mp003-debug/eye-starlink/docs/optics.md

# 新镜头到货：2026-10-23

用户10月23日确认新镜头已装好、板卡开机，纸和尺子已准备好；标称850nm补光灯10月24日已到货，铭牌/原厂接头核对及纸张开关灯响应已完成，详见procurement.md和status.md。24行/1倍增益开灯原图无饱和、大字可辨，细节仍偏软，画面位置有偏移；红外精细对焦、光谱、安全和PCCR未验证。10月23日完成的是换镜头及普通室内标靶检查。旧章节中的“保持原装镜头”等是历史操作，当前用完整新镜头替换，不拆传感器玻璃或撬IR-cut。

先在35–40cm固定纸张/尺子建立清晰基线，再固定焦点分别查看30、35、40、45cm。每档保存原始640×480画面并记录尺子可见宽度、清晰度、是否重新调焦。当前预览工具含缩小全图和中心放大窗；放大不增加原始细节。可见光焦点先用于安装验证，850nm补光到货后还需复核焦点和曝光。

镜头到货不等于安装净空、近红外像质或眼控通过；今天的标靶与可见光几何检查不作为PCCR验收。

已完成可见光粗调：手持纸约35–40cm可拍清楚；随后固定纸和竖尺于约40cm，原始640×480图能分辨毫米刻线。尺子1–5cm跨度约209像素，粗估视野123×92mm；非精密标定。随后保持当前焦点完成35/45cm固定标靶抽查，40/45cm刻线和笔画更清楚，35cm略软。目标位置/自动曝光不同，此处仅作目视比较，不等于精密景深或PCCR距离验收；30cm未测。数据见data/private/bringup/lens_40cm/assessment.json。

# 当前距离要求补充（2026-10-20）

用户要求实际使用有前后距离余量。此前32–35cm只作历史台架位置；当前先以35–40cm建立基线，将30–45cm作为待验证使用范围。镜头需要覆盖至少30–45cm的调焦位置，优先留25–50cm调焦余量。但可调焦范围、固定焦点景深、同一次PCCR校准允许的头部前后移动量必须分别测量，不能互相替代。

仍先找一只12mm镜头：薄透镜近似下，6µm像素、4mm示例目标，在30/35/40/45cm分别约27.8/23.7/20.6/18.3像素；这些是原生采样估计，不是识别精度。12mm在640列裁剪下对应水平视野约92/108/124/140mm。实际镜头畸变、焦点、景深、头动和反光效果尚未验证。

到货后先用刻度尺/打印目标，固定一个焦点，在30、35、40、45cm测清晰度和采样，再决定光圈/光源和安装位置。安全条件确认后的真人测试分开记录：每个距离重新校准的结果，以及固定一次校准后前后移动的结果；失焦或特征不可靠时暂停选择，不能输出伪稳定坐标。暂不购买测距模块。

以下旧计算保留其当时的32–35cm条件，不是当前使用硬限制。

# 原装 ATK-MT9V034 的光学准备步骤

2026-10-20用户确认只有原装摄像头与转接板，未动过镜头或线路，未准备补光及驱动。随后提供4张实物照片和京东购买链接。照片确认PCB版本为V1.5，替代此前V1.4的口头记录；产品名称仍按ATK-MT9V034记录。最新客服转述提供了M12×0.5、2.8mm及镜筒内IR-cut的信息。用户提醒客服可能出错，以下将转述、估算和实测严格分开；镜头拆检及近红外测试仍未完成；最新板测状态见status.md。

## 1. 实物核对与现在的动作

原始照片保存在[hardware/photos](../hardware/photos)，逐文件来源和SHA256见[manifest.json](../hardware/photos/manifest.json)。照片没有旋转、裁剪或修改像素。

| 实物证据 | 当前可以确认 | 仍不能确定 |
| --- | --- | --- |
| [正面照片](../hardware/photos/camera_front.jpg) | PCB丝印ATK-MC9V034 V1.5；镜头朝前，2×9接口 | 不能仅凭丝印中的MC认定内部换了传感器型号；芯片标记被镜座遮挡 |
| [镜头侧面](../hardware/photos/lens_side.jpg) | 镜筒外螺纹、黑色镜座、侧面螺钉可见 | 螺钉看起来用于锁定镜头；照片本身不能确认螺纹/焦距/后焦。客服转述提供暂定参数，详见下文 |
| [转接板](../hardware/photos/adapter_top.jpg) | PMODA/PMODB、STB/EXP开关、RST标记、两个轴向电阻 | 开关档位对应的电平、内部走线、电阻阻值不能从这些照片确定 |
| [组件全貌](../hardware/photos/assembly.jpg)及用户说明 | 现有相机与转接板，无另备补光和驱动 | 照片中的镜面反光不能证明是否有IR-cut，不能定位可拆滤片 |

正面照片在“镜头面朝观察者、接口位于下方”视角中，丝印上排从左到右为GND、SCL、SDA、D0、D2、D4、D6、PCLK、STB；下排为3.3V、VSYNC、HREF、RST、D1、D3、D5、D7、EXP。这只是丝印抄录，不是Pmod针序，也没有证明模组内部走线；背面视角会左右翻转，不能直接照此另接杜邦线。

现有[参考原理图](../references/atk_mt9v034_v14_schematic.pdf)来自V1.4资料包，不能改名成V1.5资料。该参考中STB为STANDBY、EXP为EXPOSURE；传感器LED_OUT另有其脚，且不是LED电源。客服转述称V1.5的DVP、I2C、供电、排针接口无变化，因此继续保留现有采集接线与XDC基线；这不是实际通断或新版原理图核验。新增接线仍应核对实际连接。暂不按照片规定STB/EXP开关该向哪边拨。

现在保持原装镜头和接线。把相机固定在屏幕下沿可调支架上，以32–35cm观看距离为基准，先在普通稳定室内光照下查看原始图像，检查中心及四角注视时的完整眼区、清晰度和是否离框。这是采集及几何检查，不能代替PCCR验证。现有采集上板操作先确认板卡连接及唯一控制进程；静态/单帧DMA诊断已实现并完成本地故障测试，实际板测见board_bringup.md，不运行旧实验来替代。

京东短链接已解析为[商品10114211122946](https://item.m.jd.com/product/10114211122946.html)，详细参数页未成功读取。2026-10-20用户转述客服答复如下，不再重复要求用户询问同一组问题：

| 项目 | 客服转述 | 工程采用方式 |
| --- | --- | --- |
| 原镜头 | M12×0.5，2.8mm | 暂定选型和估算输入，未独立测量 |
| IR-cut | 存在，位于镜头镜筒内部 | 优先换完整兼容镜头，保留原镜头，不撬内部滤片 |
| 可替换镜头 | M12、1/3英寸、无IR-cut、850nm、2.8mm，可在32–35cm对焦 | 说明可能存在兼容替换件；没有具体型号，也不证明其瞳孔采样足够 |
| V1.5改版 | DVP/I2C/供电/排针接口不变，仅布线与电源滤波优化 | 延续现有接口基线；原理图/通断未独立核验，晶振频率本次未明确答复 |

config/hardware.json中的reported字段保存以上答复及不确定性。顶层尚未独立确认的镜头字段继续为空，verified标志保持false；不能因收到客服答复就将光学、安全或板测标为通过。

## 2. 镜头选择：先看瞳孔像素数

能在35cm对焦，只说明焦点能落到该距离。2.8mm广角镜头即使换成无IR-cut版本，在相同距离下仍给瞳孔留下相近的少量像素；数字放大和ROI裁剪不会增加原始采样细节。

以下为选型用的理想薄透镜估算，非实际眼图或精度：像元间距p=0.006mm，捕获区域640×480，传感器不做binning；u近似取320/350mm，实际镜头主平面位置、畸变、光圈、近红外像质和角膜折射均未建模。m=f/(u-f)，物方视场宽=640p/m，目标直径像素数=d*m/p。4mm是示例目标尺寸，不代表已测得用户的瞳孔直径。

| 焦距 | 32–35cm处水平视场，640列裁剪 | 假设4mm目标直径 | 选型判断 |
| --- | --- | --- | --- |
| 原配/同焦距2.8mm | 约43.5–47.6cm | 约5.4–5.9像素 | 先做采集、对焦及视场基线，不优先买同焦距红外替换件作为主方案 |
| 8mm | 约15.0–16.4cm | 约15.6–17.1像素 | 较大视场的对照候选 |
| 12mm | 约9.9–10.8cm | 约23.7–26.0像素 | 首个单眼特写试验的优先候选，需核对机械适配和对焦 |

小瞳孔会更困难：同模型35cm、3mm示例目标在2.8mm镜头下约4.0像素，在12mm下约17.8像素。任何像素数都不是准确眼控的充分条件。较长焦距缩小可见区域，必须同时实测完整眼区、头动和景深；表中视场不能直接当成允许的头动范围。后续如输出全幅752列，水平视场可增加17.5%，同一个目标所占的原生像素数不会增加；当前位流仍输出640列，未作此改动。

估算可复现：

```powershell
python D:/Eye_tracker_system/tools/estimate_optics.py
```

默认输出[build/optics/estimate.json](../build/optics/estimate.json)。脚本仅执行几何计算，不访问相机、不控制补光、不生成眼控有效标记。

### 当前镜头规格方向

2026-10-21更新：用户已下单MTV12MP5C（12mm/F2.8/M12×0.5），商家转述无IR-cut、支持850nm且适配原镜座，待到货实测。先用这一只建立35–40cm基线，再分别验收30–45cm的调焦、固定焦点清晰度和校准移动容差；不追加8mm对照镜头。镜尾净空与传感器盖玻璃仍须按实物检查，不强行旋到底。

“定焦”通常指焦距固定，不必然表示不能调焦。需要确认的是实际工作距离能否调清楚，以及是否有足够机械调节空间。去掉IR-cut会同时接收可见与近红外，不等于加了850nm带通片；带通片留待环境干扰实测后判断。

### 现在可做的原装成像检查

板端采集适配就绪后，在普通稳定室内光下，把带50mm刻度跨度的直尺放在计划眼部平面，分别测量镜头前方约32cm和35cm，尺面尽量与成像面平行、刻度跨度位于画面中央。固定相机和尺子，记录实际距离。原始帧按640×480、1:1保存，关闭预览缩放对测量的影响，记录是否存在binning/其他缩放。

在原始帧中测量50mm跨度的像素距离n，得到中心附近的n/50像素/mm，与估算作数量级比较。按暂定2.8mm模型，约应为67–74像素/50mm；偏差先排查真实镜头参数、距离、畸变、调焦和采集缩放。没有采集到画面前不填写实测值，也不拿UI截图或插值图替代。

确认具体替换镜头适配并拿到实物后，断电、固定好模组，再按镜头/镜座说明松开锁紧螺钉并更换镜筒；不拆镜座、不撬滤片、不触碰传感器盖玻璃，不强行旋到底。换镜头后先用普通目标对焦，850nm下最终焦点在非人体台架上复核；几何或光源位置变化后重新标定。

## 3. 补光与驱动准备清单

| 部件 | 需要核对的内容 | 当前状态 |
| --- | --- | --- |
| 透近红外镜头 | 接口/后焦/成像面/工作距离/850nm响应 | M12×0.5为客服暂定规格；优先12mm、对照8mm，待具体型号和机械/光学确认 |
| 850nm LED照明组件 | 精确型号、数量、光谱、角度、辐射参数、驱动和散热资料 | 12V/24灯/850nm配电源款已收到，纸张补光响应已验证；驱动、光学输出及近眼适用性未验证，见procurement.md |
| 配套限流驱动 | 匹配LED、硬件电流上限、默认关闭、手动关闭、必要的使能接口 | 未选型；不以软件PWM替代硬件限流 |
| 供电与支架 | 按驱动额定输入选电源；可调固定架和线缆应力保护 | 先核对现有配件 |

初期可以只设计一个独立照明单元和可调位置；以实际反光点身份验证决定是否需要增加光源，不直接堆叠多灯。光源数/位置改变都应触发重新标定。

电气关系是“合适电源 → 配套限流驱动 → LED”。未来由PL控制时，GPIO只接符合3.3V逻辑要求的驱动使能/同步输入，非隔离控制需要共地；具体引脚和供电等型号确定后绘制，不能先猜。摄像头LED_OUT是同步信号，不能直接作为补光供电。现有Pmod和转接板不接新增大电流负载。

## 4. 先台架，再眼部成像

先在不照射人的台架上检查驱动限流、实际电流、默认关闭、温升、相机响应、曝光与增益。人眼试验前，需要对实际灯板、镜头/光学件、最小可能观看距离、驱动状态、持续时间及可预见故障条件取得光生物安全评估依据。仅凭850nm、低电功率、看不见或LED元件资料都不能推定整机安全；商用眼控仪的认证也不能套用到自制灯板。没有测量条件时，优先使用适用条件明确的已评估照明组件，并由具备相应测量能力的实验室复核组合后的条件。

安全条件明确后，再采集重复中心、上下左右/四角、自然小幅头动、闭眼、遮挡和离框原始图。记录曝光、增益、瞳孔像素数、反光点位置/面积、饱和情况和几何配置。相机I2C及双上下文手动曝光/增益恢复已实现并上板；不把偶然清晰的一帧当作稳定结果。

验收目标是看清真实瞳孔边界和对应光源的角膜反射，且注视变化可重复区分。虹膜外圈、眼皮阴影、眼镜/环境高亮都不能直接当作目标特征。校准与检查采用不同采集序列。

## 原始依据

客服答复的来源为用户本次转述，包含“客服也有可能出错”的限定；没有将其伪装成厂商书面规格。以下公开来源用于传感器参数和一般光学原则。

- [onsemi MT9V034 数据手册](https://www.onsemi.com/download/data-sheet/pdf/mt9v034-d.pdf)：传感器尺寸、像素间距、曝光/增益及近红外支持；不证明当前镜头透过率。
- [Edmund Optics：焦距与视场](https://www.edmundoptics.com/knowledge-center/application-notes/imaging/understanding-focal-length-and-field-of-view/)：焦距/视场/工作距离关系及近轴估算的限制；不证明某个M12镜头与本模组兼容。
- [Tobii PCCR 工作原理](https://www.tobii.com/resource-center/learn-articles/how-do-eye-trackers-work)：瞳孔与角膜反光的相对位置。
- [ams OSRAM：Eye safety of IREDs used in lamp applications](https://look.ams-osram.com/m/563d74f4395107c7/original/Eye-safety-of-IREDs-used-in-lamp-applications.pdf)：红外LED风险评估及最终系统责任。
- [Tobii 光学安全说明](https://help.tobii.com/hc/en-us/articles/212372449-Safety-guidelines)：商用产品进行IEC/EN 62471实验室测试的说明，不是自制系统的证明。

2026-10-20预算和交期已确定，具体询价规格与候选筛选见[procurement.md](procurement.md)。已有音箱AUX可复用；不因预算充足就增加不必要外设。
