mp003-debug/eye-starlink/report/design.md

# 设计说明与协同开发总结

## 系统划分

本队伍确定应用场景、交互流程、板级接口、软硬件职责和验收路径。PL 处理相机
GRAY8 采集、DDR 帧通路、RGB565 显示、UART 和双缓冲音频；ARM 组织识别、停留
状态机、文字输入、多媒体和无线消息。输入失效、帮助抢占和退出均有显式状态转换。

无线协议区分照护需求、用户确认的正文/表情分享和可关闭的活动摘要。接收端的
“确认/处理”是本屏状态，不冒充上行护理确认。断线时不自动补发旧表达。

AI 采用两个独立层次：小型 MLP 的 INT8/INT32 推理及 NEON 内核用于边缘计算研究；
极小语言模型在 PYNQ 的 ARM CPU 本机运行。生成候选经过全文预览及再次确认才
进入正文，朗读与无线发送各自确认。系统不自动替用户表达意图。

## 智能体辅助设计与本队伍决策

本队伍利用智能体辅助分析 PS/PL 分工、RTL/驱动草案、构建日志、回归脚本和文档；
需求、接口选取、实现取舍、接线与真人操作反馈由本队伍确定。对生成内容进行编译、
仿真、参考对比和实机检查，发现不符时回到接口契约修正，保留失败与通过的区别。

| 任务 | 采用方式 | 工程判断及修正 |
|---|---|---|
| 异构接口设计 | 以 IP/寄存器/时钟/缓冲区契约约束生成内容 | 保留既有外设地址及独立位流，不以重载旧工程替代增量整合 |
| 定位与交互 | 生成状态机检查和预览辅助 | 同步匹配曾阻塞 BTN0 轮询，改为后台计算与缓存绘制 |
| 无线分享 | 建立 Python→C 的整链离线模型 | 确认后的发送推进不应因视线暂时无效而停滞；过期确认仍取消 |
| 轻量语言模型 | 辅助导出、定点推理和性能记录 | 独立参考误差未达严格标准时保留失败，不用近似结果替代严格通过 |

上述经验整理成独立通用 Skill，使模型输出受到可执行检查约束。更适合此类项目的
智能体工具应提供接口契约检查、版本锁定、日志定位、资源时序关联以及可复现命令
导出，避免只生成片段代码而忽略硬件状态与清理路径。

本文件为工程总结，不是逐字对话记录。可复现检查及其结果见 `validation.md`。
