mp003-debug/eye-starlink/docs/requirements.md

# 已确认要求与工程验收

2026-11-03最后一轮10分钟拍摄窗口已启动，用户确认BTN0定位成功并进入主页，SSH已关闭，可断网线拍摄。沿用当前固定机位模型与全部功能，仅新增600秒显式配置和临时服务；151升级文件/49选定保底核对一致，运行源码、模型、门限、位流、四板固件、媒体及当前个人数据未覆盖。首次定位后计时，BTN2计入窗口、BTN3提前退出，期间独占硬件，禁止并行眼控或bootpy。上一小时日志核对3600.038秒/28950帧/272选择、1句语音完成，到时正常退出、坏行坏帧不增、音频静音且DMA停止；未重新审阅相机图或逐项确认意图，不作准确率或完整无线验收。本轮10分钟完整结果尚未观察。见build/demo_ten_20261103/result.json。

2026-11-03用户报告上一轮40分钟拍摄正常完成，日志核对2400.134秒/19527帧/137选择、24句语音完成，首次中央参考通过、无BTN2，坏行坏帧不增、到时静音并停DMA；不是逐选择意图或准确率验收，无线13次接纳及1次分享接纳，2次delivery_unknown保留。按新授权扩展显式--demo-window上限至3600秒，仅launch.py/board.py/trial_limits.py时长及帮助文本变化，普通1200秒限制不变；508项软件回归通过，含原40分钟及新一小时模拟时钟退出/停音/有界记录检查。板端151文件/49选定保底核对，旧/新个人模型、门限、位流、四板固件、素材、默认配置、收藏/音量/书签保留。新一小时独立临时服务已启动，用户确认BTN0进入主页，SSH/SFTP已关闭，可断网线拍摄；初次定位后计时，BTN2计入窗口、BTN3提前结束，独占硬件期间禁止启动其他眼控或bootpy。一小时完整真人运行尚未验收。见build/demo_hour_20261103/result.json。

2026-11-03当前固定机位新校准副本已通过代表性验证：原始采集98.234秒/75样本，50拟合、25留出匹配；独立方向368帧、状态854帧通过，实际菜单104.235秒/540交互帧/9次主动选择、4句完整语音，首次定位与BTN2→BTN0均一次取得5张参考，音乐返回停音、重定位后喝水及BTN3正常。模型7065e82c…与300/2400秒显式配置仅新增在build/fixed_camera_calibration_20261103，旧模型和默认配置不改，151运行文件/49选定保底/收藏音量书签核对一致，门限、位流、四板固件及媒体保留。535相机图审阅、733传回证据文件核对；四轮错误计数不增、音频/DMA清理正常、无重启。真人轮次接收端未供电，4次照护未发送，不能记无线LIVE通过；用户重新供电后HELLO及三种静默TEST匹配通过。新40分钟临时演示已启动，用户确认BTN0进入主页及新喝水使三端刷新；可在远程连接关闭后断网线拍摄。运行期间独占硬件，禁止并行眼控或bootpy。完整40分钟稳定性未验收。见docs/fixed_camera_calibration.md及阶段result.json。

2026-11-03本次40分钟演示启动未成功。原定位多轮眼角匹配失败；临时同步对齐引导曾阻塞BTN0轮询，已通过后台匹配及缓存绘制修复，板端CPU合成按键间隔80.44ms、绘制39.16ms，用户随后确认BTN0可出现中央圆点；但4次正式采集共48个候选均未通过眼角匹配，未进入交互。保持原250ms按键保护、5张参考、6–10秒采集、4次尝试和全部门限；失败均另存，不计40分钟通过。最后DMA已停、音频静音，151运行文件/49选定保底/3项个人数据哈希一致，板卡空闲、SSH/SFTP已关闭。用户选择评估为当前固定机位另建校准副本；已核对采集/建模流程，估计45–60分钟、用户配合10–15分钟，尚未新采集或生成模型，原模型和配置保留。见build/demo_recovery_20261103/result.json、build/fixed_camera_calibration_20261103/plan.json。所有引导只在build内为临时工具，不能当作稳定性验收或默认运行入口。

2026-11-03用户要求在当前姿势再试一次，已启动40分钟演示round5（eye-control-upgrade-demo-40min-20261103-round5.service），启动前硬件空闲，151升级/49选定保底一致，2400秒预检通过。当前active/running，等待BTN0定位确认；首次定位成功后开始40分钟计时，BTN2计入窗口、BTN3提前退出。程序独占硬件，禁止并行眼控或bootpy；源码、门限、个人模型、固件、媒体与个人数据未覆盖。完整40分钟未验收。记录build/demo_window_20261103_round5/result.json；此前失败见下一条。

2026-11-03再次安排40分钟演示（round2）：上一轮在BTN2重新定位时未取得有效参考并超时退出，exit1；DMA已停、音频已静音，不记为40分钟通过。确认空闲后复用现有程序，151升级/49选定保底文件一致，2400秒启动预检通过；未改运行源码、模型、门限、固件、媒体或覆盖个人数据。round2/round3/round4的2/1/2次定位均未取得有效参考，已退出并静音；round4的24张样本清楚，外侧眼角匹配不足，32文件诊断包SHA核对通过。用户报告相机角度可能变化，等待恢复朝向或短预览辅助；物理根因未确定；首次定位成功后计时40分钟，BTN2不重置计时，BTN3提前结束。当前没有演示窗口在运行，失败不计入40分钟。详见build/demo_window_20261103_round2/result.json、build/demo_window_20261103_round3/result.json及build/demo_window_20261103_round4/result.json。

2026-11-03按用户要求再次启动40分钟拍摄窗口，复用既有已验证程序，无运行源码/固件/模型/门限/媒体/个人数据覆盖。启动前确认硬件空闲，151升级文件和49选定保底文件哈希一致，2400秒启动预检通过。独立临时服务eye-control-upgrade-demo-40min-20261103.service已active/running，用户确认BTN0定位成功并进入主页，SSH已关闭、可断网线拍摄；首次定位成功后计时40分钟，BTN2不重置计时、BTN3提前结束。运行时独占硬件，禁止并行眼控或bootpy；完整40分钟结果尚未验收。记录build/demo_window_20261103/result.json。

2026-11-02用户授权40分钟拍摄窗口：新增显式--demo-window允许2400秒，默认1200秒不变。仅launch.py、board.py、appearance_trial.py、trial_limits.py接入时长参数；507项软件检查通过，含模拟2400秒自动停音及有界记录，不是40分钟真人稳定性验收。独立临时systemd服务运行，网线/SSH断开不结束；首次中央定位通过后开始40分钟计时，BTN2重新定位计入窗口，BTN3可提前退出。模型、门限、位流、四板固件、媒体和个人数据不改，原启动服务不变。演示准备与状态见build/demo_window_20261102/result.json；本轮已启动，用户确认BTN0定位成功并进入主页，SSH/SFTP已关闭，可拔网线。演示服务独占硬件直到40分钟到时或BTN3退出，禁止并行启动其他眼控或bootpy；完整40分钟结果尚未观察。

2026-11-02接收屏分享第二、三阶段已集中更新01/02/03/04并独立部署PYNQ，504项回归及7组Python→C离线整链通过；静默TEST覆盖原三需求和23条分享（含64字），用户确认无通知/亮灯。首轮确认后视线失效使分片停顿，已修复share_link.py推进条件并复测，失败另存。修复后1200.117秒及925.419秒两轮，共17303帧/124次选择、2句完整语音，12次分享提交获三端匹配回执；固定表达/心意/收藏正文、预览取消、已读清除、活动开关/过时、帮助优先、音乐/视频帮助、听书/游戏本地操作、04掉线不补发及BTN2→BTN0新确认通过。坏行坏帧不增，DMA/音频正常清理，无PYNQ重启；最大服务间隔269.756ms，250ms保护保留，无active service_gap中止。320图审阅/459传输条目核对（跨包重复），151升级/49选定保底核对，个人模型/门限/位流/媒体及收藏音量保留，书签按用户续听更新。02 TFT与原照护流程保留，本屏已读/处理仍无上行确认。20分钟为混合操作及观察窗口；02/03逐端掉线、64字真人和长时负载未验收。详见docs/receiver_sharing.md、build/receiver_sharing_20261102/result.json。 最终两份接收屏说明与清单已同步，151文件再次一致；私有验收包位于build/receiver_sharing_20261102/accepted，串口/SSH关闭、硬件空闲，三端待机。

2026-11-02用户批准的“照护优先”第一阶段已完成新版接收屏实测，包括原协议三需求、本屏确认/清除、帮助优先及音乐/视频帮助。视频发送调度的一文件修复经491项回归及真实眼控复测通过；保底只读、01/模型/门限/位流/个人资料保留。后续仍按六句固定表达/六张心意，再显式确认文字和默认关闭活动摘要推进；尚未扩展协议，草稿、媒体及本地操作不直接外发。确认/清除仅本屏，不宣称上行护理确认。详见[接收屏升级](receiver_displays.md)。

2026-11-01无线最小整合已独立部署并完成代表性板测：488项升级回归、56项参考检查、板端23页CPU检查通过；146升级文件/49选定保底文件及收藏、音乐100%、听书书签保留，模型/门限/升级双缓冲位流/四板固件不改。两次HELLO/TEST匹配，重做时用户确认无通知。三轮真实眼控252.048/637.848/89.092秒，共7488交互帧、24次主动选择、8句完整语音；8次原需求通知均PYNQ与三端接纳，音乐中帮助、视频两次帮助、BTN2→BTN0新控制器和新喝水、返回通过，13次本地动作不发无线。混合轮含600.018秒交互窗口及观察/空闲，非连续播放或20分钟验收。03/04首次SW1短按无响应，约1秒重试确认、SW2待机灭灯通过；无上行护理确认。3次更多均三端接纳但PYNQ视线失效撤销等待，保留delivery_unknown；新返回menu_back只本地。最大服务间隔281.921ms，250ms保护不变，未记录active service_gap中止，不宣称始终低于250ms。197图审阅、349传输条目核对（跨包重复），各轮坏行/坏帧1→1、清理正常、无重启。逐端掉线恢复、新20分钟及打字/游戏/听书无线混合仍待验收。结果build/wireless_upgrade_20261101/result.json；完整私有包eye_tracker_upgrade_wireless_short_verified.zip。默认无线仍off，显式live启用。 最终仅两份验收说明和清单同步，146文件再次一致；串口日志与SSH已关闭，全部眼控测试服务inactive，硬件空闲。收尾跨至2026-11-02。

2026-11-01自由长句增强已独立部署：UI v11、479项软件检查通过；词语简拼12010词＋5000字、16步正文撤销、64字正文/收藏与四行展示，保留完整拼音。首轮600.103秒/4662帧/69次主动选择，混合简拼与全拼展示“今天下午”、帮助和清空正常；用户在简拼中找U，已补充JT/XW/W与完整拼音提示及直接返回候选。修复后252.405秒/1903帧/45次主动选择完成JT/XW整词、撤销重加、收藏展示及两次帮助，用户BTN3结束并确认更省力、提示清楚。两轮首次5张参考通过、无BTN2、错误计数不增，DMA/音频清理正常、无复位或板卡重启；250张相机样本审阅、306个传回条目SHA核对，144升级/49选定保底/20保护项一致。音乐100%与第3篇听书29.12秒保留；模型/门限/位流、保底和02/03/04不动，无线off。规划选择次数不代表真人速度，64字真人输入与新20分钟尚未验收。见build/free_text_20261101/result.json、docs/free_text.md。 最终私有包eye_tracker_upgrade_free_text_verified.zip已保存；仅两份说明和清单同步，144文件再核对通过，新增收藏“今天下午”保留，硬件空闲、SSH已关闭。

2026-11-01眼控小游戏与有声书已独立部署：UI v10、466项软件检查通过。三轮420.067秒/3427帧/35选择、90.167秒/720帧/10选择、53.250秒/431帧/6选择，均首次5张中央参考通过、无BTN2，后两轮用户BTN3结束。图形配对完成五题，问答试三题后主动退出；3篇成熟男声均试听，前两篇到结尾，暂停继续、帮助及返回正常。第3篇保存251522样本（15.72秒），进程重启静音恢复同位置，明确播放后继续，返回保存465931样本（29.12秒）；用户确认51次均主动、音画进度正常。三轮错误计数不增，DMA/音频正常清理，无复位/板卡重启；196相机样本审阅、270传输条目SHA核对，140升级/49选定保底/18保护项一致。原收藏及音乐100%保留，新书签独立保存；模型/门限/位流、保底与02/03/04不动，无线off。短测非20分钟验收，问答整轮/错误重试、第3篇全长等尚未真人覆盖。硬件空闲。结果build/pastimes_20261101/result.json，最终私有包同目录eye_tracker_upgrade_pastimes_verified.zip；下一项按用户安排优化自由长句。 最终仅两份说明与清单同步，140文件再次核对通过，听书位置保留，SSH已关闭。

2026-11-01词句候选与续写已独立部署，453项软件检查通过。两轮240.118秒/1827帧/37选择、82.313秒/608帧/21选择，均首次5张中央参考通过、无BTN2；整句“你好”“我想喝水”、两次删除、单字“我”后续写、展示、帮助和返回覆盖，补测由用户BTN3正常结束。用户确认58次均主动、内容与音画进度正常、整句候选更省力。两轮坏行/坏帧均1→1，音频/DMA正常清理，无复位/重启；186相机样本已审阅、242传输文件条目SHA核对，130升级文件/49选定保底/19保护项一致。收藏“你”“我想喝水你好”和音乐100%保留；模型/门限/位流、保底、02/03/04不变，无线off。已知短句路径可减至7次选择，不是通用整句输入或真人速度；本增强20分钟与自由输入切回尚未真人覆盖。硬件空闲，最终说明与清单已同步、SSH已关闭。结果build/typing_words_20261101/result.json，当前私有包同目录eye_tracker_upgrade_typing_words_verified.zip，说明docs/typing_words.md。

2026-11-01：输入效率与按钮美化v9已独立部署，447项软件检查、411音节可达与板端CPU缓存检查通过。真实眼控600.107秒/4609帧/84次主动选择，首次5张中央参考通过、无BTN2辅助；常用整句后拼出“你好”，合计6字正文展示并收藏，另覆盖两次大图返回、视频播放/暂停返回、表情及音乐。用户确认内容符合意图、音画进度正常，按钮更清楚美观、输入比之前省力，继续要求更简化打字。坏行0→0、坏帧1→1，音频/DMA正常清理，无复位/重启；125相机图审阅、151传回文件SHA核对，129升级文件/49选定保底及19保护项一致。原收藏“你”保留，用户新增“我想喝水你好”，音乐100%不变。本轮无帮助语音/删除/清空/收藏重载真人覆盖，非20分钟或准确率验收。该轮提出的进一步简化现已完成，见上方词句候选阶段。见docs/ui_typing.md、build/typing_ui_20261101/result.json。

2026-11-01：用户确认45秒AMD B1最终内容及两轮真实眼控检查，31次选择主动，完整播放、暂停续播、帮助打断/不自动续播和返回正常。已完成代表性短片验证，尚非新20分钟或恒定8fps验收。下一阶段减少中文输入层级和选择次数，保留大目标、个人收藏、原模型和防误触门限；无线整链仍待用户安排。证据build/amd_video_20261101/result.json。

以下为历史阶段记录，当前状态以上文及本阶段结果为准。

2026-11-01本地视频第一版独立部署及短测完成：440项软件检查通过，生成的6秒H.264/320×180/8fps素材完成静音与有声脚本检查；真实眼控128.480秒/936帧/12主动选择及120.056秒/866帧/17主动选择，两轮首次5张参考通过、无BTN2重定位，4次自然结束、2句帮助完整，暂停继续及返回媒体菜单覆盖。用户确认29次均主动、音画基本正常；右下“暂停/控制”会暂停并回控制页，非原地暂停，文案歧义已记录。修复首帧启动超时（板端CPU实测8.743秒，媒体等待5→15秒，眼控门限不变）及首次操作日志帧编号重名，两次失败均正常停音/停DMA，未计入通过。两轮错误计数均不增加、无DMA复位恢复或重启；148相机样本和24显示样本已审阅，230传回文件哈希通过。123运行文件/49选定保底/18保护项核对，收藏“你”和音乐100%保留，硬件空闲。最终包及说明同步另见build/video_upgrade_20261101/result.json、docs/local_video.md。2026-11-01用户进一步明确需要宣传AMD自家芯片的产品短片，先列现成视频或原创动画方案，最终素材由用户决定，确认后才下载或制作；当前仅测试片，30–60秒实际素材、多片切换和新20分钟仍待验证，不承诺实际8fps。启动约9–10秒仍需改进；随后按用户安排改善打字效率，无线/02/03/04不动。

2026-10-31相册与分组拼音已独立部署，UI v8、424项软件检查通过。相册进度和大图返回两处问题已修复；120.017秒/988帧/16选择复测有3次大图正常返回，用户确认无需BTN2。输入先300.030秒/2251帧/19选择选出“你”；随后600.108秒/4598帧/55主动选择完成清空流程、收藏和大字展示，180.041秒/1336帧/17主动选择完成收藏载入和删除正文，收藏仍保留。用户确认后两轮内容与画面响应正常；三个输入轮次各用过一次BTN2辅助重新定位，不称为无辅助连续输入。仅1字实际输入，长句效率、删除收藏、新页帮助及20分钟新负载未板测。正常结束轮次坏行/坏帧均1→1、DMA/音频清理正常，无复位/重启；497张交互图已审阅、854个传输文件条目已核对（跨包有重复）。116升级文件/49选定保底文件一致，18项模型/分类器/bit/HWH/WAV未改。3张风景、5000字/411音节、32字展示及12条收藏已实现；自定义文字只在本屏展示，不新增语音或发送，无线off、02/03/04不动。见build/daily_tools_20261031/result.json与docs/daily_tools.md。

六张表情卡已按用户选择实现为本地静态大图，399项软件检查及两轮真人短测通过（51次主动选择、7句完整语音）。表情不发往手机或接收端，不新增表情语音；原模型/门限和四区域保护不变。相册和输入状态见上文；视频尚未实现。

2026-10-31用户确认下一步音乐增强：曲名、播放进度、独立音量设置；随后按表情/心情卡、相册、分组输入与常用句、视频预研推进。当前音乐增强已完成386项软件检查和两轮本版本短测（36次主动选择，3句帮助完整）；不等于新20分钟验收。音乐音量独立衰减，不调低帮助与交流语音；所有页面继续四大目标、原停留/释放保护。存储、帧率和真实操作体验须按新版本验证，不能沿用旧20分钟结论。

2026-10-31最新：可视定位/BTN2→BTN0辅助恢复180秒短测已通过，随后20分钟音乐与交流混合检查完成（66次主动选择、28句完整语音、三首各完整自然结束），用户确认后半程正常、无中途重新定位。首次启动失败、重试第3次参考采集才通过，仍需改善启动便利性。372项回归；不代表准确率、通用自动恢复或无线整链验收。见[本轮结果](../build/assisted_endurance_20261031/result.json)及[使用流程](reposition.md)。

## 用户要求

1. PYNQ-Z2 不换；保留现有 ATK-MT9V034 模组、现有转接板和 9 寸折叠屏。2026-10-20实物照片确认PCB为V1.5，替代此前V1.4的口头记录；未更换硬件。
2. 首版免佩戴、屏幕支架式，自然看 UI，需要允许眼睛与相机距离变化。32–35 cm仅保留为早期调试记录，不作为最终硬限制；暂定30–45 cm为首版待验证范围，35–40 cm建立基线。固定焦点景深、同一次校准允许的前后移动量和重新校准边界均须实测；固定头位只能用于诊断。
3. 采集、识别、个人校准、显示、交互、本地语音与安全停机全部运行于板上 PS+PL。独立供电、断开电脑与外网后可使用，不依赖 Notebook。
4. 四大按钮：喝水、休息、帮助、更多；更多页有返回。支持可见停留进度、单次播报、防连点、取消、暂停/恢复、重新校准及失效保护。辅助人员可手动设置；鼠标不代替真实眼控验收。
5. 必须交付实际 Vivado .xpr 工程、BD、RTL、引脚/时序约束、重建脚本、资源/时序报告和板测记录。
6. 所有新增内容只写入 <project>；D:/Eye_tracker_system保留为禁止写入的基线。失败算法可推翻，旧实验不成为新主线依赖。
7. UI后续需更丰富、美观，采用清晰图标、配色和状态反馈；保留大目标和防误触，实际显示通路应支持界面颜色。
8. 用户报告截止为 2026-11-04，需预留视频、文档和稳定性时间。2026-10-21 完整交付不作承诺。

9. 2026-10-20用户授权为赶进度缩减部分指标/范围，但稳定性和实际效果必须保留。补配件预算1000元以内，期望2–3天内到货；纽曼BS02音箱支持3.5mm AUX，优先复用。具体交期未核实。采购仅限淘宝/京东，助手给详细参数，用户寻找商品，随后助手核对具体链接和SKU，购买前确认必要性、兼容性、价格和交期；不把泛化清单当作下单建议。收货地区为广西南宁市西乡塘区，非必需品不买。

首版按单眼、受控室内环境、四个大目标、本地预录固定语音交付；暂缓自由鼠标、通用键盘、3DGS和复杂动画。校准、独立检查、无效输入保护、取消/暂停和防重复播报继续保留。头动与适用人群按实测报告，不宣称通用眼镜适配或大范围自由头动。

2026-10-25用户明确同意优先普通室内光、有限头动的稳定四区域眼控。此方案不称为PCCR，保留独立检查、闭眼/离框保护、停留、取消和防重复；实际头动与距离范围仍须测量。

2026-10-28启动方式调整：用户决定正常开机后在需要时手动启动程序，取消上电自动进入眼控及反复自启测试这一交付前置项。电脑可仅用于发送启动命令，采集、识别、显示、语音和通信仍须全部运行于PYNQ；不依赖Notebook或电脑计算。系统开机完成后手动运行的可靠性仍须保留真实证据。本调整按用户演示安排执行，未独立核验赛事规则。

## 用户新增通信要求（2026-10-22）

两块BearPi-Pico H3863采用自带星闪通信，约2米、无遮挡。PYNQ将四按钮已确认触发事件经有线UART发送到本端小熊派，再无线送至队友小熊派；队友负责具体动作模块。保留PYNQ USB Host供有线鼠标使用。此扩展与现有本地界面/语音共存，正式运行不依赖电脑。见[通信说明](communication.md)。

2026-10-27通信拓扑更新：用户已有四块同款小熊派，A通过UART连接PYNQ，B、C、D均接收每个相同按钮事件。三端具体动作分别由队友开发；本项目交付通信固件、事件接口和验证证据。先完成通信交接，再回到眼控完善。2026-10-27四板TEST事件及B断电恢复台架验证通过；真实眼控到无线和队友动作仍未验收。

## 首版工程目标

2026-10-29升级授权：按使用引导与状态提示、本地音乐、更多快捷交流推进，阶段见roadmap.md。前三阶段在升级目录完成后，用户安排独立部署并确认板卡空闲、可以观察；板端仅使用/home/xilinx/Eye_Tracker_Upgrade_Version和eye-control-upgrade.service，不覆盖保底服务/固件，不操作队友02/03/04接收端。升级后板上效果须单独验证，历史20分钟及TEST通信证据不自动适用于新代码。

2026-10-30首批音乐限定3首，用户从已核对录音许可的候选选择1/2/3后才授权下载，已独立导入。标称32GB SD内仅新增普通曲库文件，通过网线传输，不需读卡器、格式化或重写镜像；后续加曲先核对实际空闲容量与许可。选曲尊重个人偏好，不当作渐冻症治疗方法。当前21.52MB及测试结果见music.md；10月31日第2首全曲通过。20分钟检查因移开后返回仍选不中而提前结束，重新中央定位后的120秒操作恢复；后续辅助定位模式已完成第3首全曲和20分钟混合使用；通用移开后自动恢复仍未验证，不放宽门限。

下面是建议验收指标，未当作用户逐项批准或已通过：两轮各40个随机首试目标，每轮至少38个正确且零错误播报；至少10个新鲜有效坐标/秒；连续20分钟；正常开机后按需手动启动（上电自启测试于2026-10-28按用户要求移出交付前置项）。每项同时报告失败数、丢失率和实际条件。

沿用原先的输入年龄150ms、输入服务250ms、识别worker500ms预算，校准归一化拟合最大误差0.08和独立检查0.10作为初始软件门。屏幕坐标按宽高分别归一化，误差为该坐标系欧氏距离；它不是视角精度。更换定义或数值必须说明原因，不为追通过而放宽。

## 不可替代的真实验收

模拟 UI 通过不等于眼控；数学校准通过不等于光学有效；Vivado 构建通过不等于上板；历史位流板测不等于新位流板测。测试包括自然头动、眼镜/反光、闭眼、遮挡、离框、断流、校准失效和重启。

核心脱机后再考虑3DGS或其他扩展，它们不是首版前置条件。
