mp003-debug/eye-starlink/docs/display.md

# 彩色显示与界面

2026-10-20用户希望界面更丰富、更好看。当前采用浅色、青绿色主色和独立功能图标；“眼语”是暂定界面名称，可继续调整。界面优化必须同时落实到板端显示格式，不能只提供电脑上的彩色效果图。

## 当前实现

四个目标仍为喝水、休息、需要帮助、更多；目标矩形和停留逻辑保持原定义。用浅色卡片、文字加图标、目标边框和停留进度表示状态；颜色不作为唯一提示。重要状态以文字说明，模拟/回放来源始终可见。桌面预览没有伪造已连接摄像头、识别精度或实际发声。

640×480是当前真实HDMI时序。渲染器缓存背景、字体和图标，动态更新目标、状态和光标，避免每帧重画完整装饰。四按钮交流UI及相机调焦界面均已上板验证；交流UI当前以合成坐标验收。实体辅助按键和合成停留到实际语音已联调；真实视线与个人校准闭环仍待验证。

## 两种缓冲不能混用

| 通道 | 用途 | 像素格式 | 一行字节 | 每帧字节 |
| --- | --- | --- | --- | --- |
| VDMA S2MM | 摄像头采集 | GRAY8 | 640 | 307200 |
| VDMA MM2S | 界面显示 | RGB565小端 | 1280 | 614400 |

RGB565每个16位字中R占15:11、G占10:5、B占4:0。红色0xF800在DDR中为00 F8，绿色为E0 07，蓝色为1F 00。PL在显示端扩展到RGB888送入现有TMDS编码器。UI颜色独立于灰度摄像头，不需要换彩色传感器。

软件framebuffer.py负责格式、几何、步长和字节序检查。board_io.py实现静态显示、三缓冲动态显示、整帧重复采集和安全停止。2026-10-22共126项软件测试通过，包含超时、硬件当前槽确认和CPU/DMA所有权。最新位流相机预览优化后30.056秒322次换帧、10.713fps，用户确认跟手感改善且稳定。

按60帧/秒估算，显示有效像素读取约36.864MB/s；这是字节数计算，不是板端吞吐实测。摄像头与显示必须分配独立缓冲，重配置几何前停止通道。

Vivado改变AXIS宽度时可能重置相关行缓存配置；同步脚本现在显式恢复并检查两个方向8192的linebuffer_depth。创建脚本同样检查。不能靠放宽CDC检查掩盖配置改变。

参考：[AMD AXI VDMA PG020](https://docs.amd.com/r/en-US/pg020_axi_vdma/Product-Specification)。

## 实际屏幕验证

先显示RGB色条、边缘线和像素网格，再显示当前UI原始帧，核对颜色/字节序、边界、比例、撕裂与停止行为。最后再并行启动摄像头，检查两通道状态和缓冲独立性。本轮上述静态步骤已实测完成并由用户确认画面正常，详见status.md。历史动态相机预览已通过60秒验证；最新位流另通过30秒预览、18.141秒/362次UI换帧及19段合成输入场景。两项分别测试，尚未验证真实眼控闭环和长时间稳定性。

当前HDMI工程只发送视频，不能通过HDMI输出语音。用户已有纽曼BS02，优先复用3.5mm AUX输入；板载codec已通过三段实际语音听音；按键中止及恢复复核见status.md。

## 可复用的板端交流UI

src/eye_tracker/ui.py消费现有DwellController的状态，不产生选择事件。中文/图标/状态用tools/build_ui_assets.py预生成assets/communication_ui.npz（约354KiB压缩、6.6MiB展开），不分发字体文件；背景、选中锁定提示和20档进度直接拼入RGB565空闲帧。锁定目标即使暂时丢失输入仍显示“已选择·请移开视线”，避免重复选择的原因不可见。

同一几何和停留时间用于素材契约校验；修改后须重新构建并验证。真实位流维持三显示缓冲，运行时仅在空闲槽完成复制/flush后换帧。ui-test所有画面都有“测试输入·非真实眼控”标记，底部选择反馈明确未播放声音。输入新鲜度仍按150ms门限，不因演示放宽。板测性能见status.md，不作为含摄像头/定位的最终性能。

## 预览绘制优化（2026-10-21）

小全景384×288改为最近邻采样，中心128×128到192×192放大方式不变；原始640×480采集不变。数字图块用有界缓存直接拼入RGB565，颜色预打包；相机帧和统计仍每次更新。小全景取消平滑可能有锯齿，不影响原图及后续定位输入。参考渲染与优化输出的逐字节一致性测试通过。

同一位流和曝光下，预览由8.188提升到10.713fps，P95绘制61.994降至37.141ms；用户确认改善。完整曝光到屏幕延迟仍未量测。完整记录见status.md和build/board/result.json。
