mp003-debug/eye-starlink/docs/emotion_cards.md

# 六张本地表情卡

2026-10-31，用户选定首批六张：开心、难过、担心、喜欢、谢谢、想你。此版本先在PYNQ连接的屏幕展示，表达由本人主动选择；不识别或推断用户情绪，不发往手机或02/03/04，不增加六句语音。

启用后从“更多”进入“表情心意”。“心情”页包含开心、难过、担心；“心意”页包含喜欢、谢谢、想你，两页右下均为返回。选中后上半屏显示静态大图与文字，下半屏保留原位置的“需要帮助”和“返回”。图像保持到用户返回；返回回到原来的那一页。帮助使用现有完整语音，播完仍保留所选表情。

“更多”的四格变为本地音乐、快捷交流、表情心意、返回。快捷交流内进入原回应交流或日常照护，九句既有语音内容不变。音乐离开播放页时仍停音。四区域位置、1秒新停留、300ms有效移开、无效输入清零和防重复保护保持；特别覆盖“担心/想你”翻页后同位置出现帮助的情况。图像上半部不是可选目标。BTN2辅助重新定位清除表情并在成功后回主页，不恢复旧内容。

以显式 `--emotion-cards` 启用，当前集成入口要求同时带 `--music --quick-phrases`，无线off。默认未启用时保持原菜单。示例仅在确认板卡空闲后使用独立升级目录：

```bash
cd /home/xilinx/Eye_Tracker_Upgrade_Version
sudo ./tools/run_eye.sh --profile data/private/profiles/upgrade_check.json --music --quick-phrases --reposition-assist --emotion-cards
```

UI v7源码与素材需整包配套；矢量图形为本项目绘制，中文在开发机烘焙成RGB565，不依赖板上Emoji字体、联网或额外下载。压缩素材3.05MB、数组54.36MB，比音乐v6增加约0.98MB存储/17.45MB数组。两轮RSS采样范围190136–197076KiB与194856–205824KiB；短测包含有限审计增长，不把差值称为纯UI开销或长期平台。

2026-10-31六张本地表情卡独立部署与两轮短测通过：开心/难过/担心、喜欢/谢谢/想你分两页，静态大图保持，展示页帮助/返回，新增动作不发手机或无线。UI v7、399项软件回归；240.047秒/1926帧/18选择与180.029秒/1407帧/33选择，均首次采集5张中央参考通过，无中途辅助重新定位。第二轮全六张、新快捷交流两页及音乐播放覆盖，7句语音全部完成；用户确认51次均主动，图文匹配、返回正确、音画响应正常，无明显误选或选不中。坏行/坏帧各1→1、0→0，DMA/音频正常清理，无复位或重启。205交互图审阅、251下载文件SHA核对，102升级文件/49选定保底文件一致；18项模型/分类器/bit/HWH/WAV不变，不改门限/保底/02/03/04。RSS采样峰值205824KiB，属于短测而非20分钟/准确率验收。结果build/emotion_cards_20261031/result.json；下一项按已定顺序为眼控相册，尚未实现。

两轮初次中央采集均取得5张有效参考；本轮未按BTN2，清除已展示表情后回主页属于软件检查，不列为真人覆盖。未重做新版本20分钟、音乐全曲、专门闭眼/离框挑战或无线联调。完整私有包为同阶段eye_tracker_upgrade_emotions_verified.zip，包含个人模型，不作公开发布。
