mp003-debug/eye-starlink/docs/free_text.md

# 自由长句与词语简拼

2026-11-01：在已验证小游戏/有声书v10之上开发，已独立部署并完成两轮代表性真实眼控检查。新UI为v11，原四大目标、1秒停留、300ms有效移开、个人模型与位流保持。文字仍只在本屏显示，不自动朗读或发送。

从“文字输入→自由输入”选择“词语简拼”或“完整拼音”。简拼每字取首字母，如今天JT、下午XW、音乐YY；zh/ch/sh只取z/c/s。输入一个字母时先显示单字；要组词，选右下“继续简拼”后补下一字母。单字“午”简拼为W，完整拼音为WU；简拼不会接入该字的后续韵母。最多6个首字母。候选每页两项，下一组循环，选一字或一词后回到简拼字母页继续。所有加入都需新的明确停留，不自动拼出整句。候选较多时可切回完整拼音。

词库包含5000个原有汉字及12010个2–6字词语：来自已在工程内固定版本保存的MIT词频与读音数据，另含13个手工连接片段。新增词库419006字节，不下载新依赖，不联网推断。常用首读音和11项明确多音词读法优先，保留最多16种初声组合。已有常用表达及个人收藏可提高相关候选顺序，原候选不删除；不写入学习日志。仍可能遇到生僻词、罕见读音或简拼重码，需要翻页或使用完整拼音，不是通用中文输入法的等效替代。

“修改/完成”可删除一个未完成简拼字母，或通过“查看候选”回到原候选页，不改正文和首字母；简拼为空时，可撤销最近一次正文编辑，按加入的一字或一词撤销，不影响收藏。撤销历史只在内存保留最近16步；退出程序后不保留，也不恢复已经删除的收藏。进入“输入方式”可切换完整拼音、输入标点数字。切换方式保留各自未完成的拼音/简拼；确认载入收藏、确认清空会清理两种待输入内容。未收藏草稿不会跨进程保存。

正文与收藏单句上限由32字扩至64字，收藏仍最多12句。空间不足时整词不加入，已有正文和简拼保留，不截断内容。大字展示使用同一28像素字形、最多四行，帮助与返回仍在原下方位置；旧收藏可直接载入。64字是容量边界，不表示真人已经输入过64字。

| 规划输入内容 | 原完整拼音选择次数 | 新简拼选择次数 |
| --- | ---: | ---: |
| 今天下午 | 36 | 19 |
| 我们一起听音乐 | 58 | 31 |
| 明天天气很好 | 52 | 31 |
| 谢谢你陪我聊天 | 64 | 40 |
| 今天下午我想和你一起听音乐 | 112 | 56 |

以上从文字输入主页到正文完成，按真实状态机、事先确定的单字/词语切分计算，含新输入方式入口和候选翻页；不含进入功能、查找失败、纠错、展示或实际眼控时间，不代表所有句子都会更快。原完整拼音因新方式选择页多一次入口选择，后续逐字流程保持。

本地检查包括全部词条别名的字母可达性、原411音节可达、跨页持续注视不连选、无效输入不能提交、完整词语空间边界、撤销/载入/标点返回、旧与64字收藏、四行展示及动态进度缓存。16张初版及8张提示修复的实际RGB565页面已审阅，PC及两轮板端CPU21页/840次缓存绘制通过；不据此声称PYNQ帧率。当前结果：build/free_text_20261101/result.json。

2026-11-01自由长句增强已独立部署：UI v11、479项软件检查通过；词语简拼12010词＋5000字、16步正文撤销、64字正文/收藏与四行展示，保留完整拼音。首轮600.103秒/4662帧/69次主动选择，混合简拼与全拼展示“今天下午”、帮助和清空正常；用户在简拼中找U，已补充JT/XW/W与完整拼音提示及直接返回候选。修复后252.405秒/1903帧/45选择，具体简拼/撤销/收藏覆盖与用户反馈见结果。两轮参考采集、退出及错误计数按原始日志记录，DMA/音频清理正常、无复位或板卡重启；250张相机样本审阅、306个传回条目SHA核对，144升级/49选定保底/20保护项一致。音乐100%与第3篇听书29.12秒保留；模型/门限/位流、保底和02/03/04不动，无线off。规划选择次数不代表真人速度，64字真人输入与新20分钟尚未验收。见build/free_text_20261101/result.json、docs/free_text.md。

修复后用户确认用JT、XW输入“今天下午”；撤销只退回“今天”，再次选词恢复4字。45次选择及BTN3均主动，两次收藏操作只新增一条“今天下午”，原两句保留；展示、两次帮助及画面进度正常。用户评价“比逐字输入省力，提示清楚”。本轮252.405秒/1903帧，首次5张参考通过、无BTN2，坏行0→0、坏帧1→1；未触发新的直接返回候选入口，也未输入标点或超过4字的真人自由句，因此这些不计为真人覆盖。首轮600.103秒/4662帧/69选择同样首次参考通过、无BTN2，坏行/坏帧均1→1，帮助一遍完整；该轮混合简拼与全拼，已单独保留其模式混淆反馈。

完整私有包为build/free_text_20261101/eye_tracker_upgrade_free_text_verified.zip。最终同步仅更新本说明、upgrade_deployment.md与清单；已测运行源码和素材保持。未收藏草稿不跨进程保留。新“查看候选”原位返回的软件行为已检查，真人是否触发按日志单独记录，不扩大为所有新分支已验收。
