mp003-debug/eye-starlink/docs/local_video.md

# 本地视频第一版

2026-11-01：播放器、离线导入和眼控主循环接入已实现，440项软件检查通过。PC实际H.264解码配合模拟音频寄存器完成两轮48帧精确RGB565比较、暂停继续、自然结束及96000样本顺序比较；强制终止解码进程后停音并保持故障态。本版本随后独立部署完成两轮真人短测，见下方板测记录；仍不等于实际恒定8fps、端到端音画延迟或20分钟验收。

## 当前内容：B1成熟男声与管弦乐版已板测

用户已确认revision3预览，并完成最终45秒内容的两轮真实眼控短测。正式片库已部署到`/home/xilinx/Eye_Tracker_Upgrade_Version`，全程离线运行。完整私有包为`build/amd_video_20261101/accepted/eye_tracker_upgrade_amd_verified.zip`；旧30秒素材仅保留历史记录。

镜头沿用已认可的黑色、银色和橙光风格，新增芯片微距、游戏空间、创作雕塑和产品主视觉4张场景，组成7段虚拟镜头。加入缓动推拉、流动光路、粒子、标题与中文大字幕；这些是生成静帧与视频合成，不是精确芯片3D建模。收尾明确标注“非官方概念展示”，不含具体SKU、性能数字或官方背书。

七句中文旁白已换为Microsoft Yunjian合成男声（语速-12%、音高-6Hz），低频轻度均衡与2.5:1压缩，最后一句42.625秒结束，无句间重叠。通过[edge-tts](https://github.com/rany2/edge-tts)合成，运行时离线。配乐改为Scott Buckley的[Titan](https://www.scottbuckley.com.au/library/titan/)124.5–169.5秒管弦乐节选，按[CC BY 4.0](https://creativecommons.org/licenses/by/4.0/)使用；做渐强/淡出、EQ和旁白压低背景音，片尾、视频comment、CREDITS.txt和素材attribution.json保留作者、来源、许可与改动说明，无购买或发布。旁白期间音乐降至30%，180ms进入/650ms释放。混音峰值0.801，PCM无削波；活跃语音样本与背景RMS比8.32–14.56dB，这只是信号检查，电脑预览与板卡AUX实际听感均获用户确认。预览48kHz立体声，板卡16kHz单声道，时长仍45秒。

- [45秒有声预览](../build/amd_video_20261101/revision3/amd_b1_cinematic_preview.mp4)：1280×720/24fps，17421732字节。
- [场景素材与生成提示词](../assets/video_sources/amd_b1/revision2/prompts.json)、[旁白文本](../assets/video_sources/amd_b1/revision3/narration.json)。采用内置image_gen，原始PNG均保存在同一升级目录。
- [制作脚本](../tools/build_amd_video.py)、[旁白生成脚本](../tools/synthesize_video_narration.py)、[当前阶段结果](../build/amd_video_20261101/result.json)。
- 正式片库`assets/video`（原候选保存在`build/amd_video_20261101/revision3/board_candidate`）：MP4+WAV合计3041267字节，附来源记录。私有最终内容包输出至`build/amd_video_20261101/accepted`，只允许部署升级路径和独立服务。

本地专项检查：完整解码1080源帧；板卡格式360帧/45秒、720000个PCM样本；静音时钟/模拟音频两模式各逐像素核对360帧RGB565，每模式3次暂停续播和自然结束通过，音频逐样本与转换后的混音一致。45张预览采样与8个原生UI视图已审阅，字幕放大后保持在画面内。模拟时钟没有跳帧或故障，不据此承诺板上实际8fps或延迟。85项既有运行源码、配置、模型/分类器、bit/HWH、原语音与音乐哈希不变。440项软件回归是上一轮结果，本轮未修改运行核心，不重复整套测试。

旧30秒版本与45秒Yunxi/原创配乐版的预览、原始素材与检查结果保留；旧包`eye_tracker_upgrade_amd_video_local.zip`/`amd_video_delta.zip`仅作历史，禁止按旧部署计划发送。上一轮丰富版结果保存于`build/amd_video_20261101/revision3/before_revision_result.json`；更早30秒结果见revision2/before_revision_result.json。当前板卡使用最终45秒内容；实际AUX、画面与眼控操作已短测，不是新的20分钟验收。无需重新烧写SD镜像。

## 最终45秒内容的真实眼控检查（2026-11-01）

| 轮次 | 交互时长 | 帧数 | 主动选择 | 覆盖 |
| --- | ---: | ---: | ---: | --- |
| 首轮 | 240.111秒 | 2017 | 15 | 完整播放45秒、自然结束、返回菜单 |
| 补测 | 180.033秒 | 1382 | 16 | 5.669秒暂停并续播至结尾、5.349秒帮助打断、保持暂停、返回 |

两轮首次采集5张中央参考通过，无中途BTN2重新定位；用户确认31次选择均主动、音画与响应正常。补测帮助和休息两句均完整播报。首轮结束前再次播放仍在载入时达到时限，正常清理，不计作第二次完整播放。两轮共两次自然结束，来自同一短片，其中一次含暂停续播。

两轮坏行/坏帧均1→1，音频静音、双DMA停止后释放，无复位恢复或重启。155张相机样本已审阅、194个传回证据文件哈希核对，126升级文件与49选定保底文件一致，收藏“你”和音乐100%保留。18项保护文件及85项既有运行文件未改。板卡空闲、升级static/inactive、保底眼控disabled/inactive、bootpy enabled/inactive，启动参数和自动启动策略不变。

按音频时钟跳过的显示帧分别为19和24（补测含重播），无播放器故障；用户未见明显异常。这不等于恒定8fps、零跳帧、精确音画延迟或准确率证明。新视频20分钟、多片切换和通用移开后恢复未验收。返回在暂停控制页触发并清除位置；“暂停/控制”仍会回控制页。结果见`build/amd_video_20261101/result.json`，原始证据保留在其`accepted/board_evidence`内。

## 使用流程

显式启用 `--local-video --daily-tools --emotion-cards --music --quick-phrases`，无线保持off。正常菜单路径：更多→相册表情→相册视频→本地视频。未启用视频时原相册路径保持原样。

- 控制页：播放观看、下一段、需要帮助、返回。下一段会停止当前播放，选择后再明确播放，不自动播放下一段或循环。
- 观看页：画面在顶部352×198范围，下方原左下/右下锚点分别是需要帮助、暂停/控制。上方两个眼控目标关闭；注视内容不会产生上方按钮选择。
- 暂停/控制同时暂停画面和声音并返回控制页；再次播放从已消耗的音频样本/静音时钟位置继续。帮助先暂停视频声音，再使用原音量播报，结束后保持暂停。
- 返回媒体菜单、BTN2重新定位、BTN3退出停止并清除续播位置；BTN0暂停/恢复和BTN1取消只令视频暂停，恢复眼控后不自动续播。
- 原1000ms停留、300ms有效移开、150ms新鲜度以及模型与分类器规则不变。任何视频操作不发手机或02/03/04接收端。

## 导入与存储边界

使用现有工作区Python和 `tools/import_video.py`，输入文件先放进升级目录。默认无声，显式 `--audio` 才抽取原音轨；无音轨会报错。导入器不联网、不下载、不覆盖同名素材，拒绝升级目录外的输入和输出。

```powershell
& '<user-home>/.cache/codex-runtimes/codex-primary-runtime/dependencies/python/python.exe' tools/import_video.py assets/video_sources/example.mp4 --id amd1 --title 'AMD短片' --seconds 30 --audio
& '<user-home>/.cache/codex-runtimes/codex-primary-runtime/dependencies/python/python.exe' tools/build_text_assets.py
```

统一H.264 Baseline、无B帧、320×180、固定8fps，单段1–60秒。源片不足指定时长则用实际时长；视频保持比例补边。音轨为独立PCM16/mono/16kHz，与视频帧数严格对齐，每帧2000样本，峰值不超过8191。视频声音固定使用导入后的PCM，不改音乐音量文件、原语音素材或codec增益。

最多8段、每个MP4/WAV不超过8MiB，库内有效素材累计不超过64MiB。上限是校验边界，不是内存常驻量；60秒单声道WAV约1.92MB。清单限制文件名、目录边界、帧数、尺寸和SHA256；启动前完整检查音轨。导入全片解码检查、标题字库重建后再打包。现有32GB SD无需重新烧镜像或使用读卡器。

## 运行与故障行为

主进程仍唯一拥有采集、显示DMA和音频硬件。`spawn`子进程只读视频并完成颜色转换/固定最近邻映射，不获得MMIO、DMA或PYNQ句柄。应用队列限1个待解码请求、2个输出帧；过时帧可以跳过，主循环不等待解码。首次帧到达后才开始声音和播放时钟。

有声视频以音频IP实际已消耗样本为时钟，无声视频以单调时钟计时。暂停保持画面，恢复显式启动。首帧等待有界15秒（板端CPU单测实测8.743秒，原5秒会超时退出）；等待期间主循环继续响应，不播放声音。解码进程退出、格式改变或播放期间连续落后超过约0.75秒会停音并显示播放异常，不自动重启。CPU解码进程终止和回收有界；音频STOP失败仍进入原有硬件清理错误流程，不能隐瞒为普通媒体错误。

静态中文文字按页面状态缓存；运动画面和进度条直接复制像素，不逐帧栅格化中文字。静态UI格式仍为v8，动态页面/字库另随新包校验。未新增板端依赖或重建FPGA。

## 证据与下一步

- `build/video_upgrade_20261101/result.json`：本阶段汇总。
- `build/video_upgrade_20261101/offline_video.json`：PC真实解码+模拟音频证据；两轮相同生成素材，非96张不同内容。
- `build/video_upgrade_20261101/ui_review.png`：9张640×480原生渲染页面拼图，已人工审阅。
- `build/video_upgrade_20261101/before_video.zip`：修改前检查点；18项保护文件哈希保持一致。

下一步按用户既定顺序改善打字效率。当前仅1段45秒正式素材，多片切换、新20分钟负载与首次载入优化仍待验证；不将先前6秒素材的检查范围替代本次证据。

## 早期6秒测试片板测记录与边界（历史）

第一次静音检查因5秒首帧上限退出。CPU单测首帧8.743秒，改为15秒媒体等待上限后，静音34.246秒/有声36.091秒脚本完成；两轮均检查暂停、续播、完整结束、帮助抢占及返回停播。暂停前后的PL样本合计各96000，用户确认画面/声音正常。未采集端到端音画延迟；连续提示音也不能证明所有内容的主观同步。

第一次真实启动在首次菜单选择时因日志两个frame_index关键字重名退出；已改用camera_frame_index区分，回归夹具补齐真实快照字段，440项再次通过。两次失败均保留记录并正常停止音频和DMA，无复位恢复，不能算作通过轮次。

修复后两轮首次中央参考通过（各5张），无辅助重新定位：

| 轮次 | 交互时间/帧 | 主动选择 | 覆盖 |
|---|---|---|---|
| 首轮 | 128.480秒/936帧 | 12 | 2次自然结束、帮助在3.155秒暂停视频、2句完整帮助、主动BTN3退出 |
| 补测 | 120.056秒/866帧 | 17 | 在3.335/3.430秒暂停回控制页、两次继续到结束、两次返回媒体菜单、到时退出 |

用户确认两轮选择主动、音画基本正常，并询问为何暂停会返回。当前“暂停/控制”按设计**暂停音画并回视频控制页**；再选“播放观看”从原位置继续，控制页“返回”才退出媒体菜单并清除位置。该文案易产生歧义，已记录后续可改为“暂停并返回控制页”，本轮不变更已测试布局。

两轮视频显示缓存分别接收85帧，统计跳过10/11帧；这是4次播放同一6秒测试片，含暂停与重放，不是四段不同视频或恒定8fps验收。下一段按钮跨不同素材、无声视频真人流程、30–60秒代表性内容和新20分钟负载仍待测。首轮坏行/坏帧1→1；补测坏行0→0、坏帧1→1，DMA和音频清理正常，无复位恢复或重启。148相机样本与24显示样本已审阅，230个传回文件哈希通过。

测试包仅含生成测试素材（MP4+WAV共310088字节），不代表已选定正式娱乐内容。当前完整私有包eye_tracker_upgrade_video_verified.zip以result.json所记哈希为准；video_offline.zip和video_test.zip均缺少后续修复，作为历史保留。49选定保底文件、18保护项、收藏“你”和音乐100%保持。
