mp003-debug/eye-starlink/docs/music.md

# 本地音乐升级（阶段2）

2026-10-31音乐增强独立部署与短测通过：UI v6、386项软件回归；曲名、样本进度、音乐入口/独立音量页和20–100%五档衰减完成。两轮240.069秒/1979帧/18选择、180.055秒/1508帧/18选择，均首次中央采集通过；用户确认主动、曲名匹配、暂停进度停住、音画正常。60%实际播放、帮助抢占及3句帮助完整通过，语音音量不受音乐调节影响；用户主动恢复100%，保存文件及板端预检读回5档。坏行/坏帧各1→1，DMA/音频清理正常、无复位/重启；150交互样本已审阅，198下载文件SHA核对，99升级文件/49选定保底文件一致。模型/门限/bit/HWH/WAV不变，无线off、02/03/04不动。结果build/music_controls_20261031/result.json；属于本版本短测，不是新20分钟或准确率验收。

最高100%仍沿用此前合适的音量，板测覆盖60%/100%听感及80%中间档调节；20%/40%、损坏偏好与保存失败等边界仅软件验证。两轮未重做本版本三首全曲或20分钟负载。

当前导航：更多→本地音乐→音乐入口。入口四格为“播放控制／音乐音量／需要帮助／返回”；播放页仍是“播放/暂停／下一首／需要帮助／返回”，返回停音、清进度并回音乐入口。音量页四格为“小声一点／大声一点／需要帮助／返回”。每次翻页和再次调节都保留300ms有效移开与新1秒停留，不增加小按钮或长按暗操作。

音乐音量为20%、40%、60%、80%、100%五档，表示PCM幅度比例，不是主观响度比例。首次为已试听的100%，只对尚未提交的音乐块做有界衰减；不改WAV、codec增益或帮助/交流语音。进入音量页先停音乐，调整后不会自动播放；当前值即时原子保存至升级目录data/private/music_volume.json，下一次读取保留值。该个人设置不放入升级包，不覆盖现有偏好；损坏设置会在硬件加载前拒绝，不静默改成其他音量。帮助保持原语音音量。

曲名来自playlist.json，时间与进度条是显示信息，不能点击拖动。暂停时冻结，返回清零，换曲显示对应总时长，自然结束满格；显示秒数向下取整。中文曲名随UI编译成像素，不依赖板上字体。新增/修改曲目后须在电脑运行tools/build_ui_assets.py再打包；预检绑定顺序、ID、曲名、样本数及音频SHA，避免旧曲名与新录音错配。UI素材v6须与本次源码一起部署。

以下为此前版本的板测证据。

2026-10-31最新：20分钟眼控/音乐/交流混合检查通过（1200.059秒、66次主动选择、28句完整语音）。三首本轮均从头连续播放至自然结束：舒伯特5725440样本/357.84秒、勃拉姆斯1413538样本/88.346秒、李斯特3622400样本/226.4秒。用户确认第3首完整正常及全程音画、后半程选择正常；无中途重新定位。后10分钟RSS波动740KiB，采集错误0→0，音频/DMA正常退出。首次启动失败、重试第3次采集才通过；不是20分钟连续音乐或通用自动恢复证明。372项回归，见[本轮结果](../build/assisted_endurance_20261031/result.json)。

以下为既有阶段记录。

2026-10-30：用户选定1/2/3，已下载、完整解码并导入电脑及板端独立曲库，共21,522,888字节（21.52MB）、672.586秒；358项本地回归和板端95文件离线预检通过。首曲完整播放88.35秒、1413538样本一致，另两曲各试听25秒，无音频故障且退出静音，用户确认清楚、音量合适。两轮120秒真实眼控完成播放、切歌、暂停恢复，以及两次帮助抢占/返回停音；7句语音完整，用户确认主动选择、音画稳定、行为正确。第二、三首全曲和20分钟持续负载仍待测；不是随机准确率验收。结果见build/music_import_20261030/result.json。

| 编号 | 曲目 / 录音者 | 时长 | WAV大小 | 录音许可 |
| --- | --- | --- | --- | --- |
| 1 | 勃拉姆斯Op.39 No.15 / Martha Goldstein | 1:28.35 | 2.83MB | [CC BY-SA 2.0](https://creativecommons.org/licenses/by-sa/2.0/) |
| 2 | 李斯特《安慰曲》第3首 / Benedict Kramer；录音Tobias Lohner | 3:46.40 | 7.24MB | [CC BY-SA 4.0](https://creativecommons.org/licenses/by-sa/4.0/) |
| 3 | 舒伯特D.899 No.3 / Chiara Bertoglio | 5:57.84 | 11.45MB | [CC BY 3.0](https://creativecommons.org/licenses/by/3.0/) |

完整来源链接、录音署名、原文件/转换后哈希和所作转换保存在assets/music/attribution.json，并随曲库分发。转换后每条录音沿用各自上述许可，不代表演奏者认可本项目。原OGG和转换日志仅保留在电脑build/music_import_20261030；板端播放不需转换工具或联网。按个人偏好选择，不宣称治疗效果。以下阶段2/3/4文字为历史记录。

阶段4更新：已独立部署并完成两分钟真实眼控，用户进入空音乐页、触发播放/下一首/帮助/返回；曲库为0首，没有歌曲播放。新位流双缓冲已通过长语音的数字与实际听音检查，这不等于音乐实曲连续播放、暂停恢复或负载验收。最新证据见build/upgrade_deploy_20261029/result.json。

阶段3更新：当前配套素材已升为版本4，增加独立的回应交流/日常照护两页；358项软件回归通过，详见[双页交流](quick_phrases.md)。下面的342项和素材v3描述属于阶段2完成时记录，当前部署须用最新源码和素材；硬件位流保持同一v2版本。

2026-10-29：源码、实际RGB565界面、音频RTL和Vivado位流已本地完成；342项软件测试及两项音频RTL仿真通过。尚未连接PYNQ、实际听音或真人音乐操作。结果见 `build/music_upgrade_20261029/result.json`。

## 文件存放与导入

电脑曲库是 `<project>/assets/music`，已部署的独立板端曲库为 `/home/xilinx/Eye_Tracker_Upgrade_Version/assets/music`。它是SD卡Linux文件系统中的普通目录；复制歌曲不需要重新烧写镜像，也不改启动分区。曲目导入后须同步升级包清单，再在程序停止时传入板卡。

曲库现有上述3首完整录音。首版接受PCM16、小端、单声道、16000Hz的WAV；每曲大于0且不超过1小时，最多32曲，不支持直接播放MP3或自动重采样。界面显示曲目编号，按播放列表顺序切换。16kHz单声道是当前板载音频通路的范围，不承诺高保真。

准备好相应格式的WAV后，在升级目录执行下面的本地导入命令（示例路径须替换）：

```powershell
python tools/import_music.py D:/Music/selected_16k_mono.wav --id track01 --title "选定的音乐"
```

导入器检查格式、长度和损坏数据，必要时把峰值缩放至既有8191界限，拒绝覆盖同名曲目，生成WAV和带SHA256的playlist.json；原始文件不改。运行前再次核对清单、路径、完整PCM和哈希。启动后播放前核对文件大小/修改时间，播放时继续检查块长度和峰值；运行中不要替换曲库。每曲约1.92MB/分钟，未来复制前检查SD可用空间。

## 眼控行为

- 音乐默认关闭，仅显式 `--music` 的有声eye-trial启用；要求配套音频IP v2和源码/版本3界面素材。无线仍默认off。
- 主页面四按钮不变。“更多”进入功能菜单，左上进入音乐、右下返回主页。音乐页依次为左上播放/暂停、右上下一首、左下帮助、右下返回。
- 换页后需在原触发区外保持有效输入300ms，再开始新一轮完整停留。闭眼或无效输入不能绕过此门。
- 正常暂停在完整立体声帧边界生效，恢复沿当前位置继续。下一首在播放时立即切歌；暂停时切换曲目后等待显式播放。末曲下一首回到第一曲；自然结束停音，不自动续曲/循环。
- 帮助优先中止音乐并播放原帮助语音，播完保持暂停。再次播放从已消费样本位置继续；抢占可能打断正在发送的样本重复片段，和正常精确暂停不同。
- 返回音乐页上级时停音并清位置；BTN0/BTN1暂停音乐且不自动续播，BTN2清校准和BTN3退出停音。识别无效立即清停留，但已主动开始的音乐不会因普通眨眼停播。
- 只有一个音频硬件拥有者，短语与音乐不同时播放。缺数、失钟、播放停滞或暂停应答超时会停音并退出当前运行，记录故障，不重播旧缓冲冒充正常连续输出。
- 音乐/新增导航键只作本地动作；帮助仍沿原规则可在另行显式启用无线后发送。未扩展02/03/04协议或固件。

## 连续播放实现

原64KiB音频RAM保留，v2将其分成两个16384样本的缓冲区，每区1.024秒；PS有界读取文件、填充空闲区，PL保持I2S时钟连续消费。无需把整首歌读入内存，无音频DMA或后台硬件线程。数组转换/读回会产生有界临时副本；实际板上RSS和填充余量仍待测。

AXI基址0x43C20000、地址范围128KiB不变；ID仍AUD1，版本0x00020000。原短语单缓冲模式保留，软件在短语开始前切回模式0。

| 偏移 | v2含义 |
| --- | --- |
| 0x08 | START=1、STOP=2、CLEAR=4；PAUSE=8、RESUME=16。STOP立即清播放和缓冲所有权 |
| 0x0C | busy/done/fault/clock_alive为bit0–3；paused/underrun/pause_pending为bit4–6 |
| 0x30 | 停止时选择模式：0短语、1连续播放 |
| 0x34 | bit0/1表示两区已交PL，bit2表示当前区；交付后禁止PS修改 |
| 0x38/0x3C | 提交bank0/1，低位长度1–16384，bit31表示末块，其他位为0 |
| 0x40 | 本轮播放已消费样本数 |
| 0x10000/0x18000 | 两区PCM16数据首地址；每区32KiB |

16kHz样本仍各重复三个48kHz帧，左右声道相同。最后一个样本完整输出后才报告结束或欠载，禁止提交/覆盖PL拥有的缓冲。暂停期间失钟仍终止。

## 验证与下一步

```powershell
python tools/verify_audio_rtl.py
python tools/verify_software.py
python tools/preview_music.py
```

XSim实际解码I2S引脚：49159个连续样本（超过3秒、含两区复用），检查左右声道/每样本三次重复、暂停恢复、末块、写保护、欠载、停止和暂停时失钟；旧短语仿真也通过。软件覆盖超过4秒的缓冲调度、导入、帮助抢占、翻页防连选、故障清理及无线命令隔离。均非真人或听音证据。

Vivado在升级目录重新创建实际.xpr/BD/缓存后完成综合、实现、位流导出；WNS2.209ns、WHS0.015ns，LUT4563、FF6263、BRAM40。既有HDMI外部时序及方法学警告仍单独保留，详见 `build/fpga/result.json`。新位流SHA256为 `662895c04211deb32e805b7f205251faa8abf0d87e62992abac631b864f75c20`，未上板。

升级副本的current_eye.json已绑定此新bit/HWH，原配置保存在before_music.zip；模型和分类器未改。离线预检只确认文件/合同/历史模型入口一致，不能替代启动时的新鲜中央参考或新版本真人验证。build/deploy旧包与保底服务模板不能用于本次升级。

后续按用户安排隔离部署，再验证AUX连续性、音质、负载下眼控/辅助键响应、帮助抢占与长时运行。板端目录必须为升级专用路径，服务为eye-control-upgrade.service，并与保底服务、bootpy和DMA所有者互斥。本轮没有部署授权或执行。
