mp003-debug/eye-starlink/docs/pastimes.md

# 眼控小游戏与本地有声书

2026-11-01，用户确定先增加“图形配对＋轻松问答”及3篇原创温和短故事，之后再优化自由长句。当前已在独立升级目录实现并部署，通过三轮真实眼控短测。UI素材版本10，保留个人模型、18项模型/位流/旧音频保护文件与原1秒停留、300ms有效移开等输入保护。

启用参数为原有`--music --quick-phrases --emotion-cards --daily-tools`加`--pastimes`；视频仍由`--local-video`独立启用。无线必须off，标准手动服务参数未改。入口：更多→休闲心意→游戏听书。原相册、视频与表情移到同级“相册心意”；新增页面仍保留帮助与返回。

图形配对使用六种静态图形，每轮随机抽五种；题目右上为参照图形，两种答案在已验证按钮中心显示。轻松问答从十道日常常识题中随机抽五题。均两项答案、不限时、错误可重试；正确后必须明确选择下一题，不自动切换，不记录竞争性分数。游戏只用于休闲，不宣称认知训练或疾病疗效。

有声书包含原创虚构故事《雨后的小书店》《山间的来信》《黄昏的面包店》，成熟合成男声Yunjian，合计247.368秒/7,915,908字节，PCM16单声道16kHz，峰值不超过7600。没有第三方故事文本或录音，文本和合成来源保存在assets/audiobooks/stories.json与attribution.json；配音在开发机生成，板端完全离线播放。

播放/暂停、上一章、下一章、从头播放、时间/进度、帮助与返回均已实现。进入章节选项时暂停；切换章节后保持暂停，再明确选择播放。自然播完不自动切章。帮助先立即停止朗读、保存位置并释放共用音频，再播放原帮助语音；不会自动续播。音乐、视频、短语和有声书互斥使用同一音频硬件。有声书保持原语音硬件增益，音乐的独立衰减设置不影响朗读。

进度独立保存在data/private/audiobook_progress.json，按章节ID和音频SHA绑定，每30秒及暂停、章节切换、返回、帮助、正常退出时原子保存。重新启动只恢复位置，不自动开声。异常断电可能丢失最近一次保存后的片段；损坏或过期书签不用于越界播放，页面明确提示，保存失败仍可停止音频。收藏和音乐音量文件不在升级包中，不覆盖。

本地验证包括完整软件回归、实际RGB565逐页预览、同位置跨页防连选、重启恢复样本位置、章节隔离、不自动续播、书签异常、音频错误与模拟相机主循环中的帮助优先级。板端另完成17页/680次CPU缓存绘制检查，P95最高14.027ms；未含眼部处理、DMA或音频，不代表实际帧率。实际声音与核心流程短测范围见下文，本负载20分钟仍待验证。结果集中保存在build/pastimes_20261101/result.json。

本阶段板测三轮分别420.067秒/3427帧/35选择、90.167秒/720帧/10选择、53.250秒/431帧/6选择，全部首次获得5张中央参考，无BTN2辅助，后两轮由用户BTN3正常退出。用户确认51次选择均主动，图形、文字、按钮进度、音画与返回正常。图形配对完成五题；轻松问答试三题后主动退出，不记为整轮完成。

第1篇80.136秒完整播放，第2篇80.304秒经暂停与帮助后播到结尾；一条帮助语音完整结束，之后需主动播放。第3篇先暂停在251522样本（15.720125秒），退出后重新启动，恢复相同章节与样本且保持静音；用户主动播放后接续，返回时停音并保存465931样本（29.1206875秒）。用户确认三篇声音正常、音量和进度正常、恢复位置与续听正确。

三轮坏行/坏帧分别1→1、0→0、1→1，双DMA停止后释放、音频静音，无清理错误、复位或板卡重启。196张相机样本审阅，270个传输条目SHA核对（跨证据包有重复）；140升级文件、49选定保底与18保护项核对一致。原收藏两句和音乐100%保留。当前私有包build/pastimes_20261101/eye_tracker_upgrade_pastimes_verified.zip，含个人模型，请勿公开。

本阶段仍未真人覆盖问答整轮、故意答错重试、第3篇全长、上一章与从头播放控件，以及20分钟新混合负载；书签损坏、保存失败、断电边界与跨媒体抢占有软件覆盖，本轮未做对应实机故障注入。不能当作渐冻症患者临床有效性或识别准确率证明。下一阶段按用户要求回到自由长句效率优化。
