mp003-debug/eye-starlink/docs/quick_phrases.md

# 双页快捷交流（阶段3）

2026-10-29，用户确认采用“回应交流＋日常照护”双页方案。本地源码、六句WAV和实际RGB565素材已完成，358项软件测试通过。随后阶段4已独立部署并完成120.052秒真实眼控，双页六句全部触发并完整播完，用户确认主动选择、语音匹配完整、画面稳定、无明显误选或漏响应。阶段3离线结果见 `build/phrases_upgrade_20261029/result.json`，阶段4实测见 `build/upgrade_deploy_20261029/result.json`；不是独立随机准确率或长时稳定性验收。

## 内容与入口

原主页保持喝水、休息、帮助、更多四个位置。同时启用音乐和快捷交流时，“更多”页左上本地音乐、右上回应交流、左下日常照护、右下返回主页。只启用快捷交流时音乐入口隐藏，其他位置不移动。

| 页面 | 左上 | 右上 | 左下 | 右下 |
| --- | --- | --- | --- | --- |
| 回应交流 | 是 | 不是 | 请停一下 | 返回 |
| 日常照护 | 换个姿势 | 上厕所 | 我不舒服 | 返回 |

“换个姿势”卡片副标题及完整播报为“请帮我换个姿势”，“上厕所”完整播报为“我要上厕所”。其余卡片按显示文字播报。“请停一下”仅向照护者表达请求，不暂停程序、不停止外部设备、不发送接收端命令；实体BTN0/BTN1仍承担暂停/取消。

快捷交流默认关闭，显式 `--quick-phrases` 启用，可与 `--music` 共用。只允许有声eye-trial，要求配套音频IP v2，不允许脚本化辅助按键/挑战混入此模式。原严格个人配置文件字段不增加开关，旧启动方式不会自动启用新页面。独立升级服务已安装并完成首次手动测试，保持static，不开机自启。

## 交互与音频

- 每个表达需完整1秒有效停留。同一目标持续注视不重复；闭眼、离框、陈旧输入等仍立即清除未完成停留。语音开始后普通眨眼不打断已确认的表达。
- 换页需在原触发区之外持续有效输入300ms；此期间不累计新选择。返回时这段有效移开同时用于导航释放和当前可见按钮解锁，避免连续等待两轮；无效帧不能代替移开视线。
- 播报期间不累计新停留、不排队。新表达沿用原新鲜时间、live来源、校准、文本身份及防重复检查。返回只导航，不播音。
- 所有表达沿同一音频入口执行；音乐在短语开始前暂停，语音结束不自动续播。通过音乐页返回菜单时，音乐本就停止并清位置；日常使用进入两页无需后台继续播放。
- BTN0暂停、BTN1取消、BTN2清校准、BTN3退出均中止正在播报的长/短句，中断后不续播、不补播。清校准后继续禁选。
- 新页面导航和六句表达都只作用于本地屏幕/AUX；即使未来另行启用无线，也不会发送给02/03/04。原帮助事件保留原协议语义。

## 固定素材与较长语音

`src/eye_tracker/phrases.py`是文字来源，目标、界面反馈、生成工具和运行时音频校验共用。`assets/speech/manifest.json`绑定每句文字、文件名、样本数和SHA256。原water/rest/help WAV字节未改；六句使用本机Microsoft Huihui Desktop、正常Rate=0生成，PCM16/mono/16kHz，峰值不超过8191。

| 键 | 完整语音 | 样本数 | 时长 |
| --- | --- | ---: | ---: |
| yes | 是 | 19040 | 1.190秒 |
| no | 不是 | 21600 | 1.350秒 |
| please_stop | 请停一下 | 28800 | 1.800秒 |
| reposition | 请帮我换个姿势 | 39760 | 2.485秒 |
| toilet | 我要上厕所 | 33600 | 2.100秒 |
| unwell | 我不舒服 | 26720 | 1.670秒 |

超过32768样本的两句通过 `phrase_audio.py` 复用阶段2双缓冲，其余继续使用原短句模式。没有截断语音、提高语速或修改RTL。固定短语上限8秒，文件大小/PCM长度/峰值/哈希均在加载前检查；一次只播一句。欠载、失钟、总时长超时或不完整结束均停音报错。

板上只读取已生成WAV和像素素材，不依赖Windows语音引擎、字体、网络或电脑计算。阶段4用户已确认本次六句听感完整清楚，长句在真实眼控循环中完整结束；升级输出0dB，WAV字节不变。持续运行及不同环境音量仍按实际条件验证。

## 本地验证与边界

使用工程记录的带NumPy/Pillow的Python，在升级目录运行：

```powershell
python tools/build_ui_assets.py
python tools/verify_software.py
python tools/preview_quick_phrases.py
```

358项测试零失败/错误/跳过，本阶段新增16项。覆盖两页全六句/重复往返、无效输入/禁选、音文与文件绑定、真实运行循环的合成候选接线、长句跨缓冲顺序/末样本/中止/超时、可选启动和无线隔离。预览及像素一致性已检查；这些是离线软件验证，不是新真人准确率或板测证据。

需要主动重制六句时才运行 `tools/build_quick_speech.py`；它使用本机Huihui，将输出限制在升级目录，对子PowerShell进程使用RemoteSigned，不修改永久执行策略，不重制原三句。文本变化后须重新生成WAV和RGB565素材再验证；不要只改单个文件绕过身份检查。

素材版本4，压缩约1.58MB，全部数组约27.96MB；新增固定PCM合计339040字节。阶段4两分钟运行RSS约170332至177336KiB，929交互帧约7.74帧/秒；这是包含审计记录的短时数据，不是新增功能单独开销或长时稳定平台。复用阶段2位流 `662895c04211deb32e805b7f205251faa8abf0d87e62992abac631b864f75c20`，本阶段未重建FPGA、未重复其XSim；历史构建的外部时序/方法学限制继续保留。

当前部署包位于build/upgrade_deploy_20261029，build/deploy旧包及保底服务模板不可用于升级。独立板端目录 `/home/xilinx/Eye_Tracker_Upgrade_Version` 和 `eye-control-upgrade.service` 已使用；每次运行前仍须核对所有者与连接。真实眼控到接收端整链继续等待通知。
