mp003-debug/eye-starlink/docs/receiver_displays.md

# 接收屏升级：照护优先

2026-11-02后续：第二、三阶段已集中更新四板并完成代表性真实眼控、混合负载和04掉线恢复检查；详见[接收屏分享](receiver_sharing.md)。以下保留第一阶段范围和证据，新增分享按新报告独立验收。

2026-11-02。第一阶段照护显示已完成逐板更新及代表性真实眼控检查：三端七种页面、本屏确认/清除、帮助优先、03/04红灯、音乐和视频播放中帮助均通过。用户确认选择与BTN3主动，画面、进度及声音正常。视频补测发现一次帮助未发出，已修复PYNQ的一文件发送调度并完成真实复测；失败与通过分别保留。此结论仅覆盖下述范围，不等于新20分钟或逐端掉线恢复验收。

## 总体路线

升级版按五类组织：照护与求助、交流与文字、情绪心意、休闲娱乐、定位与系统支持。接收屏呈现与照护者有关的信息，眼控定位、草稿编辑、媒体内容本身保留在本机。

1. 本阶段：沿用原协议，完成待机、喝水、休息、帮助及本屏确认显示，先验证显示与原通知共存。
2. 下一阶段：增加六句固定表达、六张情绪心意的明确发送与对应显示；扩展协议需独立版本/能力检查，旧接收端不误解新消息。
3. 随后：明确确认后发送最长64字文字，活动摘要默认关闭。仅在活动状态切换时更新，不传照片、视频、音频或每次游戏操作。普通信息不能覆盖待处理照护/求助；过时活动标注未知，不凭视线门控判定设备离线。

下述记录对应第1步；第2、3步现已接入明确确认的表达、心意、正文及默认关闭的活动摘要。普通本地操作不直接外发媒体或正文；新增验收范围以接收屏分享报告为准。

## 第一阶段实际变化

| 设备 | 本地实现 |
| --- | --- |
| 02串口屏 | 480×272彩色分类、需求大字、优先求助配色；“待响应”与“本屏已确认·待处理”分开；底部“确认收到”“本屏已处理”两个触摸区 |
| 03/04墨水屏 | 480×800黑白分区、图标、大字、状态和实体按键说明；右上角各自标识03或04；其余能力相同 |
| 01与PYNQ | 01不改；PYNQ仅修复event_link.py中的心跳/新鲜动作调度。仍是原HELLO/PING/EVENT及1喝水/2休息/3帮助；4更多/5返回不改变接收屏，新menu_back只在本机处理 |

02的确认只改变本屏状态；完成只清除此屏。03/04的SW1确认后红灯继续闪，SW2清除后灭灯；没有上行护理确认，也不表示其他接收端已处理。求助在本屏清除前不会被喝水、休息覆盖。

墨水屏驱动、刷新时序、按键消抖、LED与引脚不改：CS GPIO0外接10k上拉3V3；SW1 GPIO13/SW2 GPIO14各串1k经常开按键接地；GPIO2串1k至红灯阳极、阴极接地。本版SW1/SW2按住约1秒的确认、清除及红灯行为已实物复核，不宣称任意短按都已验收。

## 文件和构建

- 修改前备份：`build/receiver_upgrade_20261102/before_receiver_upgrade.zip`。
- 独立源码：`comm/receiver_upgrade/`；SDK：`comm/fbb_sdk_upgrade/src/`，锁定交接要求的1.10.106 / `7cda10e7476d8df35f0ac1a4013eb395874247e0`，18项指纹匹配。
- 原SDK只读取并复制。复制时排除顶层生成输出，保留厂商ROM下必需的`output`目录；不运行保底构建脚本，不用旧`comm/sdk`。
- 编译工具：系统Python3.11（含cmake）执行`tools/build_receiver_firmware.py NODE --label LABEL`。每次全配置构建、清除旧samples归档；核对节点、7个应用对象和唯一eye_entry。没有连接/烧录代码。
- 图像生成：现有带Pillow的验证Python执行`tools/build_receiver_assets.py`。14张墨水屏图，每张解压严格48000字节；顺时针旋转与交接版同向。最终ELF逐字节核对各节点七幅字图。
- 串口屏源工程：`comm/receiver_upgrade/hmi/eye_care_upgrade.HMI`，USART HMI 1.68.1实际编译；设备TJC4827T143_011，480×272/8MB/gb2312。
- 串口屏生产文件：同目录`eye_care_upgrade.tft`，2372852字节；图片ID3待机、4/5喝水、6/7休息、8/9帮助，奇数需求图为本屏确认状态。
- page0保留两个无绘制触摸区：m0=(16,218,216,42)，释放发送`A5 02 5A`；m1=(248,218,216,42)，释放发送`A5 01 5A`。普通模拟器与实体固件分别核对后才能认定整体验收。
- 接收端最终私有包：`build/receiver_upgrade_20261102/receiver_care_ui_verified.zip`；包含源文件、已测02/03/04固件、TFT、原三板回退固件和原HMI、烧写与板测证据。原HMI副本已用同一编辑器编译为`baseline_v6.tft`（2043240字节、0错误/0警告），用于配套回退；源HMI与保底原件哈希一致，回退TFT不是从实体屏读回的镜像。此前local_ready包保留为硬件检查前候选。
- PYNQ最终私有包：同目录`eye_tracker_upgrade_receiver_care_verified.zip`，包含146个升级运行清单文件。相对上一无线版仅一处运行源码修复及两份随包说明更新；不包含、覆盖板端收藏/音量/听书进度。`before_sender_fix.zip`和板端`sender_fix_before_board.zip`保留修复前检查点。

## 本地验证

接收屏初版488项升级软件回归通过，发送调度修复后491项通过。新增主机C检查直接编译实际HMI/EPD驱动，覆盖需求与确认页映射、重复新请求重新提醒、帮助优先、完成清除、拆分/异常触摸帧、导航无显示动作、队列满BUSY重试、TEST隔离与重复包去重；03/04字图分别检查。模拟HAL不等同硬件验收。

串口屏编辑器报告0错误/0警告；早期离线模拟器已查看全部七个图片ID并验证确认/完成原始字节。初始157个保护文件一致，后续仅event_link.py经明确范围修复；模型、门限、位流、素材及板端个人数据不变。结果汇总见`build/receiver_upgrade_20261102/result.json`。

## 本版硬件证据与限制

03早期传输中断后换数据线/直连USB，并改为115200、直接文件日志，最终七段完整写入成功；具体电气或日志影响未单独证实。04/02采用保持RST后连接再释放完成烧录。四板身份均从启动日志核对，01未烧写。02配套TFT在44秒下载2372852字节，内部屏幕固件随编辑器更新（此前S89，更新后版本未读回）；原02接线已恢复，用户确认三端新版待机清楚且方向正确。

HELLO及1/2/3 TEST均首次匹配，三端日志一致，用户确认无通知、无红灯。第一次预览因用户未准备好超时，无选择；第二次有一次有效喝水后，用户误按03/04板载RST，请求重试，眼控以SIGINT安全结束。两次均保留，不计为完整成功轮；误按复位只发生于接收板，PYNQ启动ID不变。

| 检查轮 | 总时长/交互帧/主动选择 | 结果 |
| --- | --- | --- |
| 照护流程 | 529.206秒/4250帧/6次 | 三需求/确认页、02触摸本屏隔离、SW1确认/SW2清除、红灯；帮助覆盖已确认休息，喝水和导航不覆盖待处理帮助 |
| 音乐混合 | 259.669秒/1982帧/11次 | 实际播放时帮助停音并保持暂停，三端通知；时间结束前未完成视频，后续单独补测 |
| 首次视频补测 | 276.129秒/2073帧/27次 | 本地帮助与表情/收藏文字正常；无线帮助因心跳等待过期，记为未发送，不算无线通过 |
| 发送修复后视频 | 101.619秒/657帧/7次 | 实际视频6.416秒处帮助停音停画，完整语音且不自动续播；三端各接纳一次，PYNQ匹配ACK，用户BTN3结束 |

未发送的根因是动作到达时已过去61.255ms，心跳等待把首次发送推到152.780ms，超过原150ms新鲜度。修复只让尚未发送的心跳让位，并在在途心跳回执后同次服务发送仍新鲜的动作；不抢占在途包，不放宽150ms/250ms保护或协议。新增回归覆盖此时序及过期拒绝；最后真实帮助session=2988434023、seq=2、code=3有三端唯一接纳和PYNQ回执。

含中断轮共11223交互帧、52次主动选择、8句完整语音；7次已发送照护通知均获三端与PYNQ接纳，另一次修复前帮助明确未发送。5次更多三端接纳但PYNQ因input_disabled撤销等待，保留delivery_unknown；39次本地动作无EVENT。最大服务间隔271.273ms，未记录active service_gap中止，不声称所有间隔低于250ms。

373张保留相机图已审阅，无黑色竖纹；包含自然离位/闭眼等样本，不用于准确率。613传输条目哈希核对（跨包重复），146运行文件与各轮清单一致，49选定保底文件、收藏、音乐100%及第3篇听书465931样本书签保持。四个完整轮坏行/坏帧均1→1，DMA/音频清理正常，无PYNQ重启；中断轮不具备正常结尾错误差值。串口记录与眼控已停止；接收端最后帮助由各屏自行确认/清除，未另行观察最终清除。

这是一组限定范围检查，不是新20分钟、连续音视频、眼控准确率或逐端掉线恢复验收。文字、表情与固定表达外发尚未实现，不能把待机分类图标记为消息功能。

## 板测顺序与回退

先确认四板和PYNQ当前空闲、供电及接线、USB日志无占用；串口号只作枚举，必须从启动身份确认地址，不能直接沿用历史COM号烧写。03/04可以先单板升级一块观察，成功后再更新另一块。01保留原固件。

02需要**匹配更新TFT与02固件**，原界面与新程序混用无法正确显示。本轮使用用户原USB下载器供电下载，断电切换后恢复原接线；不拔出、不格式化PYNQ启动SD卡，不猜测串口电平或带电改接线。

逐板记录完整烧写结果与启动身份，再检查待机、三需求、确认/清除。三端就绪后做HELLO/TEST（接纳但无通知），再真实眼控LIVE和音乐/视频帮助打断，复核普通本地动作不发无线。仅短测通过仍不等于新20分钟、逐端掉线恢复或全面准确率验收。

失败时只使用包中对应节点的交接固件恢复；02还需恢复原HMI编译出的对应TFT。保底目录、PYNQ个人配置与升级部署目录始终不作回退覆盖目标。
