mp003-debug/eye-starlink/docs/receiver_sharing.md

# 接收屏分享：合并第二、三阶段

2026-11-02接收屏分享第二、三阶段已集中更新01/02/03/04并独立部署PYNQ，504项回归及7组Python→C离线整链通过；静默TEST覆盖原三需求和23条分享（含64字），用户确认无通知/亮灯。首轮确认后视线失效使分片停顿，已修复share_link.py推进条件并复测，失败另存。修复后1200.117秒及925.419秒两轮，共17303帧/124次选择、2句完整语音，12次分享提交获三端匹配回执；固定表达/心意/收藏正文、预览取消、已读清除、活动开关/过时、帮助优先、音乐/视频帮助、听书/游戏本地操作、04掉线不补发及BTN2→BTN0新确认通过。坏行坏帧不增，DMA/音频正常清理，无PYNQ重启；最大服务间隔269.756ms，250ms保护保留，无active service_gap中止。320图审阅/459传输条目核对（跨包重复），151升级/49选定保底核对，个人模型/门限/位流/媒体及收藏音量保留，书签按用户续听更新。02 TFT与原照护流程保留，本屏已读/处理仍无上行确认。20分钟为混合操作及观察窗口；02/03逐端掉线、64字真人和长时负载未验收。详见docs/receiver_sharing.md、build/receiver_sharing_20261102/result.json。

## 使用方式

保留独立升级目录与服务，显式增加 `--receiver-sharing`，同时启用 `--eye-events live` 和原日常工具依赖。无线及分享默认关闭，不修改自启动。`--eye-events log` 用于真实眼控输入、接收端不显示内容的TEST检查。

入口：更多 → 快捷交流 → 文字输入 → 编辑展示 → 接收屏分享。原正文、收藏、输入法及休闲功能保留。没有启用分享参数时沿用原页面。

| 内容 | 发送方式 | 接收屏行为 |
| --- | --- | --- |
| 是、不是、请停一下、请帮我换个姿势、我要上厕所、我不舒服 | 选择固定表达，再确认发送 | 交流表达页，不触发红灯 |
| 开心、难过、担心、喜欢、谢谢、想你 | 选择心意文字，再确认发送 | 情绪心意页，不发送本机图片或新增语音 |
| 输入正文 | 固定正文快照 → 完整预览 → 继续确认 → 确认发送 | 最长64字，完整接收后显示，草稿与收藏不变 |
| 活动摘要 | 本次运行内明确开启，默认关闭，随类别变化发送 | 显示上次活动，两分钟未更新标为过时，不据此判断离线 |

活动仅包含菜单、音乐、视频、听书、游戏、相册、文字交流、展示心意类别；不发曲名、书名、照片、视频、声音、正文或每次游戏操作。变化最多每5秒一次，连接不可用时丢弃当次更新，不补发旧活动；关闭后不再自动更新，并尝试发送关闭提示。关闭提示若失败，旧活动仍按原规则标为过时。

正文限1–64个可打印GB2312字符。不支持的生僻字或符号明确提示，不替换、不截断。引号与反斜杠按屏幕文本语法转义。“三端已接纳”只表示应用接纳，不表示屏幕已完成刷新或护理人员确认。提交包在途时取消/断链显示“接纳结果不确定”，不能宣称远端撤回。

## 显示、优先级与协议

02沿用第一阶段TFT的24像素中文字库和触摸区，MCU动态绘制类别、正文、状态与“本屏已读/本屏清除”。官方USART HMI 1.68.1离线模拟器已检查64字末字、引号及反斜杠；板上若仍为已验收TFT，不需要重复下载或拆线。03/04以24像素栅格生成480×800竖屏，短表达放大、长文分行；SW1本屏已读，SW2本屏清除。普通分享不闪红灯。

原喝水/休息/帮助保持v1协议与照护流程。任何待处理照护都阻止普通分享覆盖；新照护丢弃旧分享，清除照护后不恢复旧分享。帮助仍优先于喝水/休息。活动不覆盖明确发送的表达/正文。本屏已读和清除仍无上行护理确认，也不改变其他屏。

02显示任务优先级改为30，让优先级28的协议任务能抢占9600波特率的较长绘制发送；仍只有原显示任务写UART。墨水屏引脚、SPI/刷新时序、按键消抖和LED逻辑保留。用户已确认播放中帮助的显示与抢占正常；物理刷新不能立即中断，本轮没有计量接纳至实际刷新延迟。

沿用16字节物理帧、原UART/SLE和升级位流。v1照护字节不变。版本2必须先在同一v1会话内完成三端CAPS：32 CAPS、33 BEGIN（类别/字节数）、34 DATA（两字节）、35 COMMIT（整段CRC16）。每包保留CRC16、三端逐包回执；只在完整COMMIT校验后交给显示队列。最多128字节/64字，传输总时限20秒；原会话2秒失联、150ms首次动作新鲜度、250ms服务间隔保护不放宽。

显式确认后允许自然眨眼；暂停、重新定位、退出、取消和照护终止未完成分享。断线不自动补发。旧固件不支持v2时停止分享并保留v1照护。COMMIT部分接纳不能回滚，发送端显示不确定。日志仅记录类别、长度、会话、序号与状态，不记录正文或分片内容；相机/显示诊断文件仍按原私有证据规则保存。

## 构建、验收与回退

仅在升级目录开发，保底只读；SDK固定1.10.106/`7cda10e7476d8df35f0ac1a4013eb395874247e0`，不用旧comm/sdk。01扩展协议转发，02/03/04扩展重组显示；PYNQ新增分享控制器、启动选项、页面与字形，不改模型、分类器、视线门限、PL、媒体或个人收藏/书签/音量。检查点 `build/receiver_sharing_20261102/before_sharing.zip`。

软件回归、实际C驱动主机检查和Python→C桥→三C接收端离线检查分别记账，不当作真人或无线验收。更新前核对当前独占与四板USB身份，不沿用历史COM号；先接收端、01最后，四端一致后才启用PYNQ分享。02保持第一阶段TFT。

本轮集中测试路线如下；首次失败修复后完成20分钟混合窗口，再集中补测未覆盖项：

1. 更新、启动身份核对与静默HELLO/CAPS/TEST；原照护及新分享TEST均不得通知或亮灯。
2. 约20分钟真人窗口：固定表达/心意、已有收藏载入后预览发送、取消不发送、三屏显示及本屏已读清除。
3. 活动默认关闭与明确开关、过时提示；音乐/视频/听书/游戏不外发内容；播放中求助抢占。
4. 帮助不被分享覆盖；BTN2→BTN0不重发旧内容；单端掉线后重新确认新消息。完成BTN3退出。

不要求用户重新输入64字；长度上限先由离线与静默TEST覆盖。真人长文、所有词句、长时无线负载未覆盖时仍列为待验收。失败时只回退升级部署和对应节点：第一阶段PYNQ包、02/03/04固件及原01交接固件。保留屏幕TFT配套，不覆盖个人数据。候选包仅作历史，当前已验证私有包位于build/receiver_sharing_20261102/accepted，禁止公开发布。

## 本轮证据与修复

首轮8次选择中，确认“是”后视线暂时无效，DATA到COMMIT间隔2965.369ms，三端返回会话过期，未显示。修复仅令已确认的固定内容继续逐包推进；取消、辅助定位、退出和帮助仍中止未完成分享，150ms/250ms/2s/20s保护不变。504项回归、7组离线整链与板端1/64字模拟视线失效TEST通过，再完成真实眼控复测。首轮SIGINT正常清理，但exit1明确记为失败。

两次通过轮分别1200.117秒/9846帧/70次选择和925.419秒/7457帧/54次选择，第二轮由用户BTN3结束。前轮默认活动关闭，经明确开启后显示音乐活动及过时提示；结束前未实际完成关闭，后轮补齐明确开启再关闭。关闭可显示“活动分享已关闭”，不会自动清除屏幕；随后本地操作不再推送活动。待处理帮助拒绝普通提交属预期，更多导航的delivery_unknown单列，不记为可靠送达。

04下载前两次失败，用户换数据线/直连USB后完整写入；不据此推断电气根因。04拔下后分享未发送，重接无补发；BTN2→BTN0后重新确认才显示。新固件引导段与既有TFT保持，未重编或替换PYNQ位流。所有运行样本为私有调试证据，非眼控准确率或临床验收。
