mp003-debug/eye-starlink/docs/reposition.md

# 可视定位与辅助重新定位

2026-10-31最新：可视定位/BTN2→BTN0辅助恢复180秒短测已通过，随后20分钟音乐与交流混合检查完成（66次主动选择、28句完整语音、三首各完整自然结束），用户确认后半程正常、无中途重新定位。首次启动失败、重试第3次参考采集才通过，仍需改善启动便利性。372项回归；不代表准确率、通用自动恢复或无线整链验收。见[本轮结果](../build/assisted_endurance_20261031/result.json)及[使用流程](reposition.md)。

2026-10-31，372项软件回归、RGB565素材v5检查及180秒真实眼控短测通过。两次中央定位各5张新鲜参考、中途BTN2→BTN0恢复成功；1270交互帧/23次主动选择、6句语音完整，用户确认预览、选择与音画正常。坏行/坏帧0→0，音频/DMA清理正常，无复位或重启。它提供明确的人工确认恢复流程，不宣称头部移开后自动恢复，也不改变个人模型、分类门限、同眼匹配或位流。

## 使用流程

仅在升级目录以`--reposition-assist`显式启用，默认启动行为不变。无线开启或脚本化挑战不能与此模式并用。

1. 启动后显示实时相机画面；用户自然坐好、眼部清楚入镜后，由辅助人员按板上BTN0。
2. 用户看屏幕中央圆点，完成原有6–10秒、5张新鲜参考及一致性检查。小预览只供辅助人员观察，不是注视目标。定位期间禁止选择和音频播放。
3. 通过后进入主页，每次选择仍需新的完整1秒停留。音乐由新的眼控选择启动，不自动续播。
4. 持续选不中时，辅助人员按BTN2：先停音乐与语音，清除本次参考与旧停留，进入实时预览；坐好后按BTN0再采集。无需重启Linux或重载位流。
5. BTN1取消正在进行的采集，回到预览；BTN3退出。失败后须重新按BTN0才能重试，不自动在任意姿态下采集。一次运行最多4次采集，每次预览/定位流程最多60秒；运行总时限不会因中途重新定位而延长。超时会安全退出并记录未完成。

画面清楚不等于识别有效。若仍无法获得参考或恢复选择，应保留证据检查位置、相机与模型适用条件，不降低识别门限来通过。患者不需要自己按板卡，按键由辅助人员完成；尚未实现完全无辅助的重新定位入口。

## 启动与验证边界

现有手动服务仍保持原参数。新流程使用明确的启动参数，且必须先检查升级/保底服务、bootpy和硬件拥有者为空：

```bash
cd /home/xilinx/Eye_Tracker_Upgrade_Version
sudo /usr/bin/python3 tools/upgrade_preflight.py --owners
sudo /bin/bash tools/run_eye.sh --profile data/private/profiles/upgrade_check.json --music --quick-phrases --reposition-assist
```

真实验证时用独立临时systemd服务承载上述命令，避免SSH关闭中断运行；不覆盖保底服务，不添加开机启动。当前独立升级目录已同步本功能及v5素材；标准手动服务没有加入新参数，因此仍需显式启动新模式。

每次重新定位重新读取原模型和经验证的同眼位置种子，再取得新参考。旧参考另存`reference_attempts/`，交互行记录`reference_epoch`，`reposition_events`记录确认、取消、失败、通过与超时。稀疏图像和合成测试不能当作真实准确率或自动恢复验收。后续第3首全曲与20分钟混合使用已完成；首次启动失败、重试第3次参考采集才成功，通用明显移开后的自动恢复仍未验收。

本地结果：`build/reposition_upgrade_20261031/result.json`；离线预览：同目录`preview.png`（使用已标注的历史图像）。

本轮中途重新定位约16.77秒（包括辅助人员等待），恢复后首个选择距通过约3.12秒；不是固定恢复时延。按BTN2时音乐/语音已停，本轮未真人验证BTN2打断活动音频、BTN1取消、失败重试或超时；这些边界由软件测试覆盖。89张有限交互样本已审阅，126个下载文件SHA一致；实际结果与用户反馈见本阶段result.json。
