mp003-debug/eye-starlink/docs/typing_words.md

# 明确选择的词句候选

2026-11-01，用户完成v9十分钟检查后，确认按钮更清楚美观、输入比之前省力，并要求进一步简化。本增强已完成453项软件检查、独立部署与两轮真人短测。用户确认整句候选更省力，内容、续写、显示、帮助和返回正常。

拼出一个音节后，候选页除了汉字，还能显示以该字开头的已知词句。例如ni可以选择“你”或“你好”，wo可以选择“我”或“我想喝水”。所有单字仍可通过“下一组”选到，第一候选字不变；最多加入3项词句候选。

若先选中单字“我”，会出现“想喝水”“想休息”等可接在正文后面的内容。只有完成一次新的有效停留选择才会加入，不自动补字。选择“拼音输入”可继续逐字输入，“修改/完成”可删除或展示。选择完整词句后进入展示/收藏操作页，不自动展示、播音或发送。

候选来自当前20句本地常用表达和已有个人收藏，按稳定顺序去重；不使用云端、生成模型或新词频下载。它是已知词句的快捷方式，不是通用整句拼音输入法。遇到续写建议而仍选择逐字输入时，会多一次“拼音输入”操作，不能声称所有自由文本都变快。

| 内容 | 已测v9逐字拼音步数 | 本地词句候选步数 |
| --- | ---: | ---: |
| 你好 | 15 | 7（ni后选整句） |
| 我想喝水 | 35 | 7（wo后选整句） |
| 谢谢 | 18 | 9（xie后选整句） |
| 请帮我换个姿势 | 58 | 11（qing后选整句） |

从文字输入主页到正文完成，不含功能入口、显示、纠错和实际注视时间；是确定性的已知短句路径，不是真人速度。常用表达菜单本身仍可直接选择整句。

32字限制保持：空间不足时隐藏不能完整加入的词句；不会截断正文或吞掉待选拼音。所有内容必须明确选择，跨页仍需300ms有效移开与1秒新停留，长时间盯住同一位置不会连续提交。原有5000字/411音节、收藏原子保存、防误触、模型与位流保持。

本地预览和检查：`build/typing_words_20261101/offline_review.json`与`word_completion_preview.png`。备份为同目录`before_word_completion.zip`；当前板端检查点为`build/typing_ui_20261101/eye_tracker_upgrade_typing_ui_verified.zip`。新完整私有包为`build/typing_words_20261101/eye_tracker_upgrade_typing_words_verified.zip`，不包含个人收藏或音乐音量。

板端两轮分别240.118秒/1827帧/37选择、82.313秒/608帧/21选择，均首次采集5张中央参考通过、无BTN2。第一轮直接选出并展示“你好”“我想喝水”，包含两次删除；第二轮先选“我”再续写“想喝水”，展示、完整帮助语音和返回，用户按BTN3正常结束。用户确认58次均主动，内容、声音、画面与停留进度正常。

两轮坏行与坏帧均1→1，双DMA停止后释放、音频静音、无清理错误，无复位或重启。186张相机样本已审阅，242个传输条目SHA核对；130升级清单、49选定保底及19保护项核对一致，原收藏两句和音乐100%保留。首轮正常离开画面的样本不当作准确率失败。

板端CPU文件检查含10页、400次缓存绘制，候选页P95为13.922ms、续写页13.016ms；冷页140.625–240.615ms。未含相机识别、DMA与音频，不代表实际帧率。继续自由拼音的出口、32字边界已有软件覆盖，但本增强未专门真人补测；新20分钟混合负载、泛化输入效率仍待验证。
