mp003-debug/eye-starlink/docs/ui_typing.md

# 输入效率与按钮美化

后续词句候选与续写已独立部署，并通过两轮共58次主动选择短测；见[词句候选说明](typing_words.md)。下方保留v9首轮84次选择的原始范围，两个版本证据不混用。

2026-11-01，本轮按用户授权改善文字输入和全局按钮。UI素材版本9、字形图集版本2；447项软件检查与411音节可达检查通过，现已独立部署并完成10分钟混合真实眼控检查。用户确认按钮更清楚美观、输入比之前省力，并要求进一步简化。

## 输入方式

文字输入页四个入口为“拼音输入 / 常用表达 / 编辑展示 / 返回”。拼音只显示词典允许接在当前拼音后面的字母；拼成音节时直接进入候选。若音节还没拼完，例如ha后还要输入o，选择右下“继续拼音”。单独m、n等少见音节可从“修改/完成→选字”进入候选。全部411个词典音节仍可达。

选中汉字后清空拼音并直接继续输入下一个字。“修改/完成”提供选字、删除、展示收藏和返回输入页。删除仍先删未完成拼音，再删正文；不删除收藏。已有常用句与当前正文末尾能匹配时，将相应候选字排到前面，其余候选保持原顺序；不增加在线模型、学习日志或存储写入。

“常用表达”提供日常需要、交流心意各10句，以及原有“我的收藏”。每页两句，下一组和返回；选择后整句追加到正文并进入展示/收藏操作页，不自动展示、不播音、不发送。未完成的拼音保留。空间不足时整句不加入，不截断或覆盖草稿。正文32字、收藏12句上限及原子保存方式保持。

| 自由拼音输入 | 旧版选择次数 | 新版选择次数 |
| --- | ---: | ---: |
| 你好 | 23 | 15 |
| 谢谢 | 28 | 18 |
| 我想喝水 | 57 | 35 |
| 我想听音乐 | 78 | 43 |
| 请帮我换个姿势 | 104 | 58 |

从文字输入页开始，到正文输入完成为止；不含进入功能、纠错、实际注视或展示。“你好”“我想喝水”等预置整句从该页各3次选择可加入，另1次可展示。步数由真实状态机的确定性路径计算，不代表真人速度、正确率或渐冻症患者适用性验收。原来未完成“你好”的情况仍留在历史证据中，不用本轮模拟结果覆盖。

## 按钮与页面

所有按钮继续使用原四大目标范围，文字中心对齐已校准的注视位置；没有缩小按钮或增加密集小目标。圆角、细边框、图标与顶部装饰预先生成，不闪烁、不播放装饰动画。

| 内容 | 视觉区分 |
| --- | --- |
| 输入与主页 | 薄荷绿、简洁文字卡片 |
| 快捷交流 | 蓝色与暖色需求卡片 |
| 音乐 | 紫色、音符和声波细节 |
| 表情心意 | 玫瑰色、对应表情图标 |
| 相册 | 绿色、叶片细节 |
| 视频 | 靛蓝色、播放图形 |
| 常用表达 | 暖色对话卡片 |

帮助采用暖色，返回/继续等右下导航采用蓝色；保留文字含义，不仅依赖颜色。单字候选放大到36像素，长句自动采用适合卡片宽度的字号。相册大图返回仍以(472,336)为中心，查看照片不改变命中区域。

动态页面仅在内容改变时混合字形，停留和光标更新只复制缓存。已选择提示和进度继续明确显示；无效输入仍立即清零，翻页后仍要有效移开300ms，再重新停留1秒。150ms新鲜度、模型、分类器、参考采集、位流、音频和无线规则均未改。

## 验证与部署边界

42张原生界面预览和操作步数见`build/typing_ui_20261101/offline_review.json`，当前阶段汇总为同目录`result.json`。本地CPU缓存绘制检查通过；板端360次CPU缓存绘制P95为12.256–15.206ms，首次页面绘制146.381–249.455ms；未包含相机、眼图处理、DMA或音频开销，不作为恒定帧率承诺。

运行须完整更新v9源码、communication_ui.npz及新glyphs.npz，避免混用旧包。完整私有包为`build/typing_ui_20261101/eye_tracker_upgrade_typing_ui_verified.zip`，包含个人模型，不公开。包不含个人收藏/音乐音量文件，部署时保留。使用现有显式功能参数及独立升级服务；保底目录与服务、02/03/04和启动镜像不变，无线off。

真实检查运行600.107秒/4609帧/84次主动选择，首次5张参考通过，无中途BTN2。预置“我想喝水”之后通过拼音加入“你好”，最终6字正文展示并收藏；原收藏“你”保留。不是6字自由拼音，也不把84次总选择解释为最佳输入步数。还覆盖两次相册大图返回、视频播放/暂停返回、两张表情及音乐播放。用户确认内容符合意图，音画与进度正常。

坏行0→0、坏帧1→1，DMA和音频正常清理，无复位或重启；125相机样本已审阅，151传回文件哈希通过。129升级文件与49选定保底文件一致，19保护项保持；音乐100%未变。正常退出后硬件空闲。此轮未触发帮助语音、删除/清空或收藏重载；新20分钟、长句输入效率和通用恢复未验收。

下一步按用户反馈增加明确选择的词句候选，减少继续逐字母输入的次数。当前验证包作为板端检查点，新简化先在本地验证。
