mp003-debug/eye-starlink/docs/wireless_upgrade.md

# 升级版无线整合

2026-11-02更新：接收屏照护第一阶段已独立部署并通过代表性实测，02彩色屏及03/04墨水屏均支持原三需求、本屏确认/清除及帮助优先。无上行护理确认、无新消息类型，01/模型/门限/位流/素材及个人状态保持。详细结果在build/receiver_upgrade_20261102/result.json，界面说明为docs/receiver_displays.md（开发目录）。以下11月1日数据保留为前一阶段记录，四板不改等范围仅适用于当时。

视频帮助补测曾在心跳等待期间超过150ms新鲜度，本机语音成功但EVENT未发出。仅修复event_link.py：动作到达时不启动新心跳，尚未发送的心跳让位，在途心跳ACK后同次服务发送仍有效的动作；150ms/250ms、重试和失效撤销规则不变，不抢占在途包、不补发旧请求。491项软件回归通过。修复后真实眼控101.619秒/657帧/7主动选择，实际视频6.416秒处帮助暂停，三端各接纳一次且PYNQ匹配ACK；用户确认完整语音、不自动续播、接收显示及主动BTN3正常。原失败另存sender_failure.json，不改写为成功。

本阶段另有529.206秒照护流程、259.669秒音乐混合和276.129秒修复前视频补测。含一次因误按接收板RST而中断的轮次，共52主动选择、8句完整语音，7次已发照护通知均匹配，39本地动作无EVENT；5次更多三端已接纳但PYNQ撤销等待，保留delivery_unknown。最大服务间隔271.273ms，未记录active service_gap中止，不保证始终低于250ms。373张图审阅、613传输条目核对（含重复），146升级文件、49选定保底及收藏/音乐100%/听书书签保留。四个正常结束轮错误计数不增、DMA/音频清理正常、PYNQ无重启。新20分钟、逐端掉线恢复仍待验收。

当前完整私有PYNQ包为build/receiver_upgrade_20261102/eye_tracker_upgrade_receiver_care_verified.zip；接收端与回退包为同目录receiver_care_ui_verified.zip。最终只同步两份验收说明及清单，已实测源码保持。默认无线仍off，必须显式live；表达、情绪、文字和活动摘要外发属于后续阶段。

## 2026-11-01最小整合记录

2026-11-01：最小合并、独立部署、HELLO/TEST、真实LIVE、音乐/视频代表性混合和重新定位补测完成。原有升级功能代码与数据保护通过；本阶段属于限定范围验证，逐端掉线与更长连续负载尚待验收。交接72项载荷/74份导入文件保持只读依据。

## 接入判断与修改范围

当前升级位流已经包含event_uart_0，0x42C00000、64KiB、50MHz、115200/8N1、TX U12/AR1、RX T14/AR0。bit保持662895c04211deb32e805b7f205251faa8abf0d87e62992abac631b864f75c20；HWH保持d2b3120f4a7598ab7c67294592763e79176815ecead5d3c76d11daebf5b2eb50。底层event_protocol/event_uart/event_link/trial_limits与交接参考一致，不替换、不放宽时限，不重编FPGA或四板固件。

仅7个运行模块有小范围修改：launch.py、board.py放开显式无线与升级功能共存入口；emotions.py、daily_tools.py只调整选项验证；trial_events.py以原EVENTS为白名单并增加暂停/新控制器绑定；appearance_trial.py接入定位生命周期与通信服务点；text_ui.py在冷页面字形绘制结束时调用同一线程的可选服务回调。默认off不建立UART。UI素材、按钮位置、停留/释放规则、识别模型与门限、输入功能、音视频、收藏及书签不变。

视频仍由原有CPU解码子进程提供帧，主循环不等待首帧；不另开UART/MMIO线程。冷页面绘制分段穿插非阻塞服务，不产生Action、不重复提交停留。辅助键先取消旧请求；进入预览期间无线禁用，新的参考通过后绑定当前控制器，再由原门控建立新会话。旧动作时间戳不得跨定位复用。退出先关闭无线，再做可能等待的媒体清理。

## 协议和状态边界

- 1喝水、2休息、3帮助保持原语义；4更多、5返回只导航接纳，不改变通知画面。
- 音乐、视频、听书、游戏、相册、表情、打字、收藏、六句新增快捷交流及新页面导航都留在本机。各页面明确选择“帮助”仍是原code3，仅发送一次。
- log为真实眼控输入加TEST标志，只记日志；live才交给接收端动作接口。模拟/回放不能走LIVE。
- 首发150ms、重试180ms、事务600ms、服务间隔250ms均保持。超过服务间隔仍中止旧会话，不自动补发。已发而无匹配ACK只能记录送达未确认。
- 只有原协议匹配的remote_accepted代表A汇总的三端通信接纳；它不等于显示刷新结束，更不等于护理人员已确认或完成。本屏未新增这类护理状态承诺。

## 本地证据

488项升级软件检查、56项交接通信参考检查通过。覆盖本地动作白名单隔离、六类升级页面与帮助单次提交、收端失联时本地继续、重新定位换控制器/旧请求撤销/失败退出、250ms服务超时不补发。参考套件只把旧定位显示桩适配为现有setup_frame；保留断言，未修改导入原件。旧音频夹具的-6dB断言不适用于已验证的升级0dB，音频行为由完整升级套件覆盖，不能把音量退回旧值以通过旧测试。

tools/check_wireless_coexistence.py是CPU和内存TEST对端检查，23种页面的开启/关闭回调像素一致，920次缓存绘制，无个人文件写入；不是实际无线通信或整帧时延。板端运行同工具后，再核对真实采集、识别、显示、音频负载中的service_gap与事务回执，不能用PC数值保证PYNQ时序。

结果：build/wireless_upgrade_20261101/result.json。修改前完整检查点before_integration.zip及上一版eye_tracker_upgrade_free_text_verified.zip保留。当前候选包不能取代上一版已验证包；短时保底8次眼控成功不计入升级验收。

## 本轮板端证据

三轮分别252.048秒/2029帧/4选择、637.848秒/5061帧/17选择、89.092秒/398帧/3选择。第一/三轮用户BTN3结束，第二轮达到600.018秒交互窗口正常结束。8次通知（喝水2、休息1、帮助5）各有三端唯一接纳、A汇总0x7与PYNQ匹配ACK；8句语音完整。用户确认24次均主动，画面、语音和按钮进度正常。原升级bit/HWH和四板固件保持。

音乐实际播放约67秒后帮助抢占，视频在10.625秒、续播至14.467秒两次帮助暂停；均不自动续播，用户确认正常。12次混合页本地动作和补测menu_back没有无线EVENT。两轮BTN2→BTN0分别取得新的5张参考并绑定新controller；定位期间没有旧EVENT。混合轮定位后用户尚未尝试选择，不能据此称为选不中；补测新参考后8.246秒的新喝水获三端及PYNQ接纳。

3次more在三端均接纳，但PYNQ因input_disabled取消等待，正确保留delivery_unknown；它们只导航，不改变通知画面，不改写为本机确认送达。真实服务间隔峰值281.921ms，记录中没有service_gap类型中止，仍保留250ms保护；不能声称完整运行始终满足250ms或以CPU页面检查代替整帧验证。

03/04最新物理接线由用户确认，需求显示与红灯正常。首次SW1短按未触发，两块约1秒重试后均有acknowledged及page6；SW2均completed locally及page0，用户确认待机灭灯。短按原因未明，不改固件、不宣称任意按压时长已验收。SW1/SW2仍没有上行护理确认。

197张图已审阅（包含用户观察接收端时移开视线的样本，不用于准确率），349个传输条目SHA校验（跨包重复）。三轮坏行/坏帧均1→1，音频/DMA清理正常，无板卡重启；146运行清单、49选定保底文件、收藏/100%音乐音量/第3篇听书465931样本书签保持。完整私有包：build/wireless_upgrade_20261101/eye_tracker_upgrade_wireless_short_verified.zip。

仍待：逐端断电掉线/重连与不补发、连续更长无线负载、打字/游戏/听书与无线的实际混合。此次600秒窗口包含观察和空闲，不是连续600秒视频/音乐或新20分钟验收。下一轮先明确各端独立供电与日志重连方式，再进行物理掉线测试；不得带电改UART/按键/显示接线。

## 后续复测路线与启动方式

1. 确认PYNQ外接电源/J9 REG、补光灯关闭、相机/屏幕/AUX正常，板卡及串口无其他所有者；读取四板身份，不按历史COM号烧录。保底、升级与bootpy均须空闲，既有共享锁保持。
2. 仅更新/home/xilinx/Eye_Tracker_Upgrade_Version的候选差异；保留个人收藏、音乐音量、听书进度，保持eye-control-upgrade.service独立、手动。先离线预检、板端CPU检查；沿用升级bit，不安装保底服务。
3. 记录四端原始串口日志，先HELLO/TEST逐事务核对三端接纳与A汇总；TEST不改变三端通知画面。
4. 用户就位后用--eye-events live执行真实喝水、休息、更多/返回、帮助。先正常需求，帮助放最后；按session/sequence/code核对，不以READY或本机播音代替送达。
5. 混合音乐、视频、输入、听书/小游戏与帮助，确认本地动作不外发，暂停、取消和BTN2重新定位无旧请求复播。再做有界连续运行与逐端失联/恢复、不补发检查。
6. 03/04新增实物按键/LED单独验收。若尚未安装，不把它们记为通过，也不因接线图重编固件。

测试使用原启动器和显式参数：

```text
tools/run_eye.sh --profile <本轮独立检查配置> --quick-phrases --music --emotion-cards --daily-tools --local-video --pastimes --reposition-assist --eye-events log
```

完成TEST后再把log改为live。运行时间由本轮独立配置限定；不覆盖用户current_eye.json或标准服务参数。

## 03/04接线与本地按钮

以imports/Eye_Wireless_Upgrade_Handoff_20261101/wiring/WIRING_UPDATED.md为准：CS GPIO0直连屏幕且10kΩ上拉3V3；SW1 GPIO13、SW2 GPIO14各串1kΩ至常开按钮再接地；LED GPIO2串1kΩ至阳极，阴极接地。接线修改须断电。

SW1只把本机需求标为已确认，红灯不会因此直接灭；SW2清需求回待机并灭灯。HELP待处理时保留优先页面。SW1/SW2没有上行护理确认协议。现有四板固件保持；禁止使用升级目录旧comm/sdk重建或旧TEST-only包覆盖。
