mp003-debug/eye-starlink/assets/eye_region_template.png

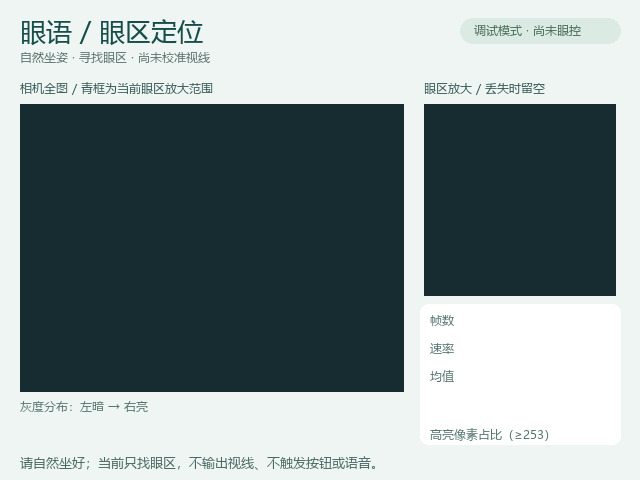
assets/eye_region_template.png
