mp003-debug/eye-starlink/assets/fixation_template.png

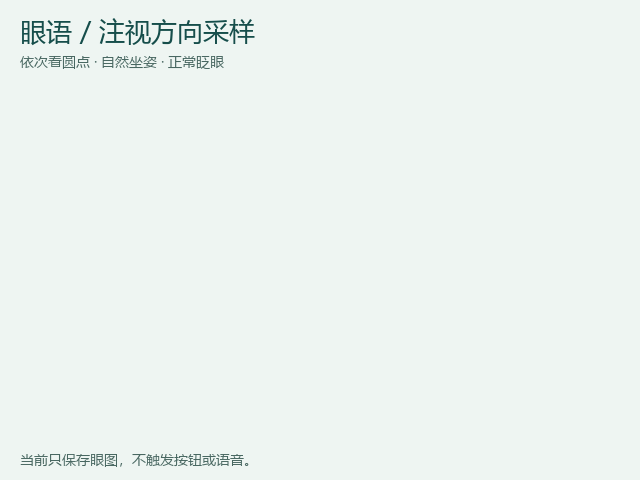
assets/fixation_template.png
