mp003-debug/eye-starlink/assets/preview_template.png

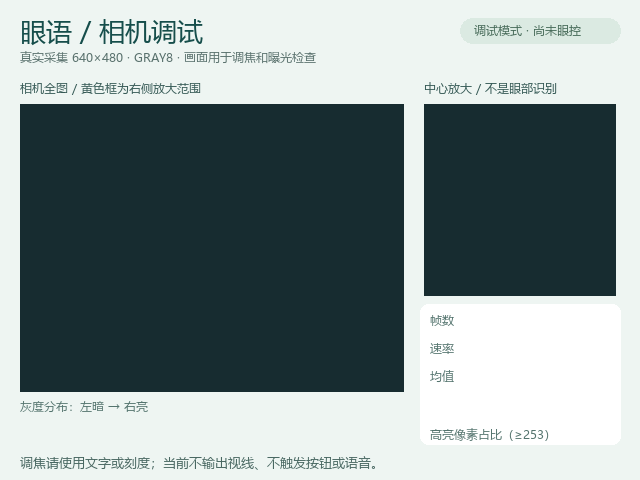
assets/preview_template.png
