mp003-debug/eye-starlink/board/wiring/epaper_connections_user.png

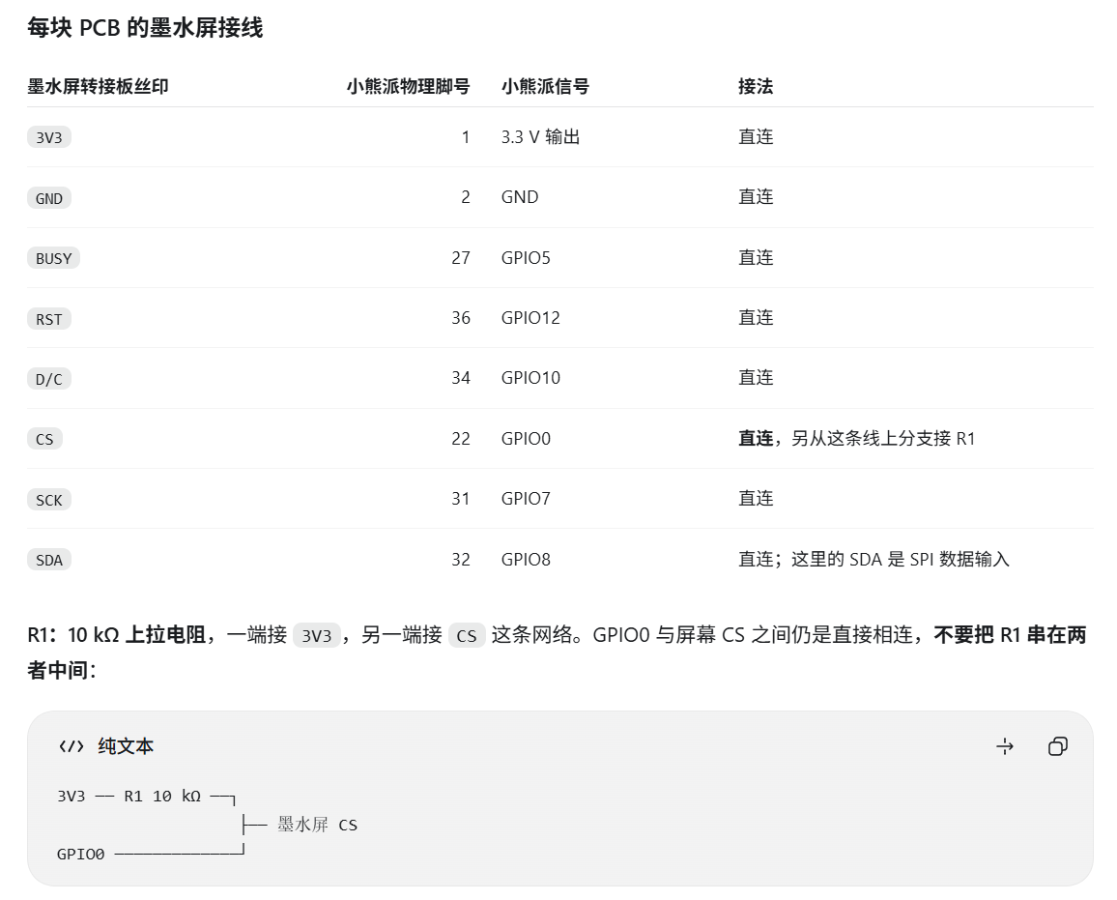
board/wiring/epaper_connections_user.png
