mp003-debug/eye-starlink/comm/receiver_upgrade/hmi/assets/03_idle.png

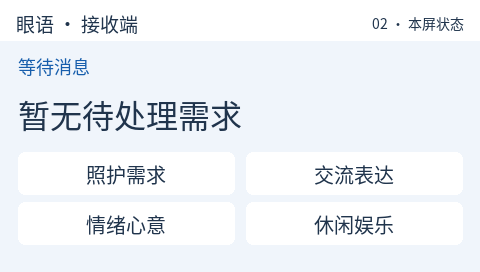
comm/receiver_upgrade/hmi/assets/03_idle.png
