mp003-debug/eye-starlink/comm/receiver_upgrade/hmi/assets/04_water.png

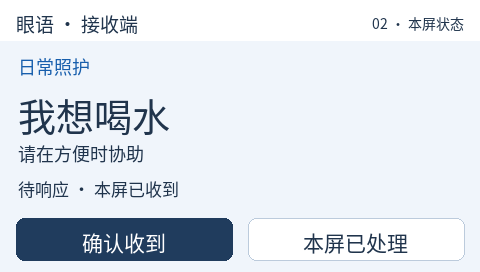
comm/receiver_upgrade/hmi/assets/04_water.png
