mp003-debug/eye-starlink/comm/receiver_upgrade/build_hooks/products_cmakelists.txt

if(DEFINED CONFIG_SAMPLE_SUPPORT_SLE_UART)
    add_subdirectory(sle_uart)
endif()
set(SOURCES "${SOURCES}" PARENT_SCOPE)
set(PUBLIC_HEADER "${PUBLIC_HEADER}" PARENT_SCOPE)
