mp003-debug/eye-starlink/board/wiring/keys_led_user.png

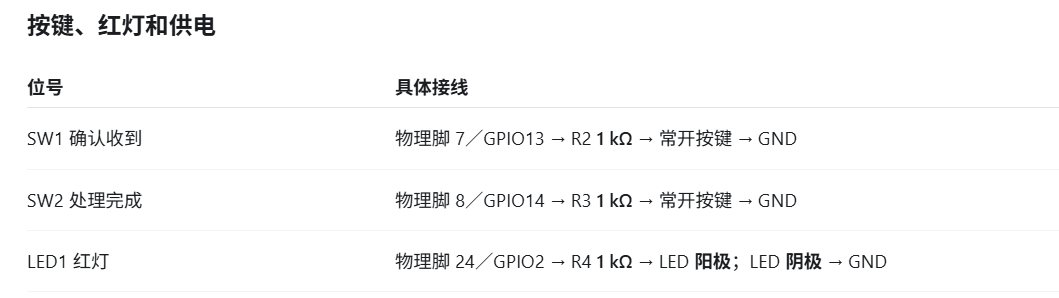
board/wiring/keys_led_user.png
