mp003-debug/eye-starlink/report/software_tests.txt

test_adopted_text_uses_existing_wireless_preview_confirm (test_ai_writing.AIWritingTests.test_adopted_text_uses_existing_wireless_preview_confirm) ... ok
test_async_page_change_resets_existing_dwell_and_requires_release (test_ai_writing.AIWritingTests.test_async_page_change_resets_existing_dwell_and_requires_release) ... ok
test_candidate_cancel_keeps_text_and_favorites (test_ai_writing.AIWritingTests.test_candidate_cancel_keeps_text_and_favorites) ... ok
test_candidate_requires_review_and_second_confirmation (test_ai_writing.AIWritingTests.test_candidate_requires_review_and_second_confirmation) ... ok
test_changing_draft_invalidates_generation (test_ai_writing.AIWritingTests.test_changing_draft_invalidates_generation) ... ok
test_enabled_entry_preserves_access_to_display_and_favorites (test_ai_writing.AIWritingTests.test_enabled_entry_preserves_access_to_display_and_favorites) ... ok
test_expired_or_replay_speech_confirmation_cannot_start (test_ai_writing.AIWritingTests.test_expired_or_replay_speech_confirmation_cannot_start) ... ok
test_feature_off_keeps_original_pages (test_ai_writing.AIWritingTests.test_feature_off_keeps_original_pages) ... ok
test_generated_text_never_auto_adopted_or_shared (test_ai_writing.AIWritingTests.test_generated_text_never_auto_adopted_or_shared) ... ok
test_help_stops_speech_and_cancels_worker_without_restart (test_ai_writing.AIWritingTests.test_help_stops_speech_and_cancels_worker_without_restart) ... ok
test_late_result_after_cancel_is_not_reused (test_ai_writing.AIWritingTests.test_late_result_after_cancel_is_not_reused) ... ok
test_launch_requires_explicit_opt_in_and_checks_complete_local_bundle (test_ai_writing.AIWritingTests.test_launch_requires_explicit_opt_in_and_checks_complete_local_bundle) ... skipped 'requires optional local private profile or AI runtime bundle'
test_only_explicit_share_confirmation_reaches_wire_commit (test_ai_writing.AIWritingTests.test_only_explicit_share_confirmation_reaches_wire_commit) ... ok
test_partial_pinyin_cannot_be_discarded_by_AI (test_ai_writing.AIWritingTests.test_partial_pinyin_cannot_be_discarded_by_AI) ... ok
test_play_uses_fresh_live_confirmation_and_streams_complete_pcm (test_ai_writing.AIWritingTests.test_play_uses_fresh_live_confirmation_and_streams_complete_pcm) ... ok
test_reposition_discards_result_and_pending_voice_but_preserves_draft (test_ai_writing.AIWritingTests.test_reposition_discards_result_and_pending_voice_but_preserves_draft) ... ok
test_silence_rejected_instead_of_claiming_speech (test_ai_writing.AIWritingTests.test_silence_rejected_instead_of_claiming_speech) ... ok
test_speech_file_corruption_is_rejected (test_ai_writing.AIWritingTests.test_speech_file_corruption_is_rejected) ... ok
test_unknown_glyph_and_overlong_candidates_rejected_without_truncation (test_ai_writing.AIWritingTests.test_unknown_glyph_and_overlong_candidates_rejected_without_truncation) ... ok
test_voice_ready_never_autoplays (test_ai_writing.AIWritingTests.test_voice_ready_never_autoplays) ... ok
test_wave_resample_limits_and_peak (test_ai_writing.AIWritingTests.test_wave_resample_limits_and_peak) ... ok
test_check_leakage_is_rejected_and_disables_previous_result (test_appearance.AppearanceModelTests.test_check_leakage_is_rejected_and_disables_previous_result) ... ok
test_invalid_feature_is_not_silently_repaired (test_appearance.AppearanceModelTests.test_invalid_feature_is_not_silently_repaired) ... ok
test_missing_or_ambiguous_target_cannot_create_model (test_appearance.AppearanceModelTests.test_missing_or_ambiguous_target_cannot_create_model) ... ok
test_single_outlier_is_not_forced_into_target (test_appearance.AppearanceModelTests.test_single_outlier_is_not_forced_into_target) ... ok
test_training_alone_never_enables_and_geometry_change_rejects (test_appearance.AppearanceModelTests.test_training_alone_never_enables_and_geometry_change_rejects) ... ok
test_training_cross_class_error_is_not_hidden_by_majority (test_appearance.AppearanceModelTests.test_training_cross_class_error_is_not_hidden_by_majority) ... ok
test_wrong_accepted_check_blocks_even_when_majority_is_correct (test_appearance.AppearanceModelTests.test_wrong_accepted_check_blocks_even_when_majority_is_correct) ... ok
test_default_uniform_metric_matches_explicit_uniform_model (test_appearance.DiscriminativeMetricTests.test_default_uniform_metric_matches_explicit_uniform_model) ... ok
test_invalid_or_mutable_external_weights_cannot_change_decisions (test_appearance.DiscriminativeMetricTests.test_invalid_or_mutable_external_weights_cannot_change_decisions) ... ok
test_training_metric_never_enables_actions_or_consumes_check_examples (test_appearance.DiscriminativeMetricTests.test_training_metric_never_enables_actions_or_consumes_check_examples) ... ok
test_weight_training_is_order_independent_and_distinguishes_informative_pixels (test_appearance.DiscriminativeMetricTests.test_weight_training_is_order_independent_and_distinguishes_informative_pixels) ... ok
test_weighted_fit_keeps_cross_class_conflict_block (test_appearance.DiscriminativeMetricTests.test_weighted_fit_keeps_cross_class_conflict_block) ... ok
test_weighted_novelty_gate_rejects_unseen_patterns_and_changed_geometry (test_appearance.DiscriminativeMetricTests.test_weighted_novelty_gate_rejects_unseen_patterns_and_changed_geometry) ... ok
test_distant_moving_texture_does_not_drive_eye_alignment (test_appearance.EyeAnchorTests.test_distant_moving_texture_does_not_drive_eye_alignment) ... ok
test_eye_band_change_does_not_become_head_motion_or_stale_eye_pixels (test_appearance.EyeAnchorTests.test_eye_band_change_does_not_become_head_motion_or_stale_eye_pixels) ... ok
test_known_translation_aligns_current_pixels_without_drift (test_appearance.EyeAnchorTests.test_known_translation_aligns_current_pixels_without_drift) ... ok
test_small_anisotropic_face_motion_aligns_but_excessive_shear_rejects (test_appearance.EyeAnchorTests.test_small_anisotropic_face_motion_aligns_but_excessive_shear_rejects) ... ok
test_textureless_or_wrong_geometry_fails_closed (test_appearance.EyeAnchorTests.test_textureless_or_wrong_geometry_fails_closed) ... ok
test_missing_required_support_is_still_rejected (test_appearance_diagnostic.AnatomicalFeatureCropTests.test_missing_required_support_is_still_rejected) ... ok
test_unknown_crop_cannot_silently_use_different_features (test_appearance_diagnostic.AnatomicalFeatureCropTests.test_unknown_crop_cannot_silently_use_different_features) ... ok
test_visible_eye_support_survives_missing_distant_skin (test_appearance_diagnostic.AnatomicalFeatureCropTests.test_visible_eye_support_survives_missing_distant_skin) ... ok
test_corner_refinement_recovers_eye_motion_different_from_brow (test_appearance_diagnostic.BoundedCornerPeakTests.test_corner_refinement_recovers_eye_motion_different_from_brow) ... ok
test_cut_off_strong_peak_is_bracketed_once_without_changing_feature (test_appearance_diagnostic.BoundedCornerPeakTests.test_cut_off_strong_peak_is_bracketed_once_without_changing_feature) ... ok
test_peak_beyond_bounded_retry_and_blank_are_still_rejected (test_appearance_diagnostic.BoundedCornerPeakTests.test_peak_beyond_bounded_retry_and_blank_are_still_rejected) ... ok
test_complete_eye_survives_clipped_search_margin (test_appearance_diagnostic.CornerEdgeTests.test_complete_eye_survives_clipped_search_margin) ... ok
test_corner_cannot_match_in_padded_or_blank_edge (test_appearance_diagnostic.CornerEdgeTests.test_corner_cannot_match_in_padded_or_blank_edge) ... ok
test_corner_refinement_recovers_eye_motion_different_from_brow (test_appearance_diagnostic.CornerEdgeTests.test_corner_refinement_recovers_eye_motion_different_from_brow) ... ok
test_refined_crop_not_unused_coarse_crop_controls_visibility (test_appearance_diagnostic.CornerEdgeTests.test_refined_crop_not_unused_coarse_crop_controls_visibility) ... ok
test_unobserved_final_feature_crop_still_rejected (test_appearance_diagnostic.CornerEdgeTests.test_unobserved_final_feature_crop_still_rejected) ... ok
test_corner_refinement_recovers_eye_motion_different_from_brow (test_appearance_diagnostic.CornerRegistrationTests.test_corner_refinement_recovers_eye_motion_different_from_brow) ... ok
test_single_visit_needs_explicit_current_fit_and_cannot_enable (test_appearance_diagnostic.CurrentSessionPackTests.test_single_visit_needs_explicit_current_fit_and_cannot_enable) ... ok
test_brief_wrong_candidate_never_survives_and_resets_previous (test_appearance_diagnostic.DiagnosticTemporalTests.test_brief_wrong_candidate_never_survives_and_resets_previous) ... ok
test_fixed_plan_covers_all_classes_once (test_appearance_diagnostic.DiagnosticTemporalTests.test_fixed_plan_covers_all_classes_once) ... ok
test_instructed_label_never_reaches_predictor_and_prediction_is_not_action (test_appearance_diagnostic.DiagnosticTemporalTests.test_instructed_label_never_reaches_predictor_and_prediction_is_not_action) ... ok
test_large_gap_cannot_earn_stability_and_duplicate_fails (test_appearance_diagnostic.DiagnosticTemporalTests.test_large_gap_cannot_earn_stability_and_duplicate_fails) ... ok
test_stale_or_missing_input_immediately_clears_candidate (test_appearance_diagnostic.DiagnosticTemporalTests.test_stale_or_missing_input_immediately_clears_candidate) ... ok
test_center_only_offset_is_frozen_and_preserves_new_direction_difference (test_appearance_diagnostic.SessionBaselineTests.test_center_only_offset_is_frozen_and_preserves_new_direction_difference) ... ok
test_duplicate_frames_and_unstable_reference_are_rejected (test_appearance_diagnostic.SessionBaselineTests.test_duplicate_frames_and_unstable_reference_are_rejected) ... ok
test_incomplete_or_excessive_setup_cannot_enable_reference (test_appearance_diagnostic.SessionBaselineTests.test_incomplete_or_excessive_setup_cannot_enable_reference) ... ok
test_reference_collection_never_scores_predictions (test_appearance_diagnostic.SessionBaselineTests.test_reference_collection_never_scores_predictions) ... ok
test_duplicate_eye_neighborhood_cannot_relocate_automatically (test_appearance_diagnostic.SetupRelocationTests.test_duplicate_eye_neighborhood_cannot_relocate_automatically) ... ok
test_explicit_setup_relocates_without_expanding_inference_window (test_appearance_diagnostic.SetupRelocationTests.test_explicit_setup_relocates_without_expanding_inference_window) ... ok
test_blank_or_unrelated_neighborhood_is_rejected (test_appearance_diagnostic.TranslationDiagnosticTests.test_blank_or_unrelated_neighborhood_is_rejected) ... ok
test_translation_and_current_eye_pixels (test_appearance_diagnostic.TranslationDiagnosticTests.test_translation_and_current_eye_pixels) ... ok
test_missing_duplicate_or_foreign_setup_never_moves_origin (test_appearance_trial.CurrentNeighborhoodTests.test_missing_duplicate_or_foreign_setup_never_moves_origin) ... ok
test_only_fresh_accepted_setup_moves_frozen_search_origin (test_appearance_trial.CurrentNeighborhoodTests.test_only_fresh_accepted_setup_moves_frozen_search_origin) ... ok
test_recentered_matcher_accepts_local_motion_but_still_rejects_escape_and_blank (test_appearance_trial.CurrentNeighborhoodTests.test_recentered_matcher_accepts_local_motion_but_still_rejects_escape_and_blank) ... ok
test_unverified_or_outside_origin_rejected_without_relaxation (test_appearance_trial.CurrentNeighborhoodTests.test_unverified_or_outside_origin_rejected_without_relaxation) ... ok
test_fresh_session_candidate_requires_its_own_evidence_hash (test_appearance_trial.NamedModelEvidenceTests.test_fresh_session_candidate_requires_its_own_evidence_hash) ... ok
test_paired_matcher_cannot_borrow_evidence_from_changed_or_unrecorded_code (test_appearance_trial.PairEvidenceHashTests.test_paired_matcher_cannot_borrow_evidence_from_changed_or_unrecorded_code) ... ok
test_feature_revision_can_reuse_only_exact_same_eye_position (test_appearance_trial.SeedEvidenceTests.test_feature_revision_can_reuse_only_exact_same_eye_position) ... ok
test_seed_is_only_position_and_checks_pack_and_positive_record (test_appearance_trial.SeedEvidenceTests.test_seed_is_only_position_and_checks_pack_and_positive_record) ... ok
test_seeded_check_needs_positive_current_results_and_identity_provenance (test_appearance_trial.SeedEvidenceTests.test_seeded_check_needs_positive_current_results_and_identity_provenance) ... ok
test_ambiguous_reacquisition_restores_seed_and_is_bounded (test_appearance_trial.SetupReacquisitionTests.test_ambiguous_reacquisition_restores_seed_and_is_bounded) ... ok
test_stale_seed_reacquires_position_then_uses_a_new_capture (test_appearance_trial.SetupReacquisitionTests.test_stale_seed_reacquires_position_then_uses_a_new_capture) ... ok
test_any_positive_wrong_or_incomplete_stage_blocks_entry (test_appearance_trial.VisualTrialTests.test_any_positive_wrong_or_incomplete_stage_blocks_entry) ... ok
test_assisted_retry_failure_cleans_up_without_resuming_old_speech (test_appearance_trial.VisualTrialTests.test_assisted_retry_failure_cleans_up_without_resuming_old_speech) ... ok
test_assisted_retry_stops_audio_mutes_and_requires_fresh_dwell (test_appearance_trial.VisualTrialTests.test_assisted_retry_stops_audio_mutes_and_requires_fresh_dwell) ... ok
test_audiobook_camera_loop_help_priority_chapter_and_exit (test_appearance_trial.VisualTrialTests.test_audiobook_camera_loop_help_priority_chapter_and_exit) ... ok
test_automatic_helper_test_cancels_and_pauses_only_real_selections (test_appearance_trial.VisualTrialTests.test_automatic_helper_test_cancels_and_pauses_only_real_selections) ... ok
test_both_quick_pages_use_camera_loop_dwell_and_single_speech (test_appearance_trial.VisualTrialTests.test_both_quick_pages_use_camera_loop_dwell_and_single_speech) ... ok
test_center_reference_required_before_screen_trial (test_appearance_trial.VisualTrialTests.test_center_reference_required_before_screen_trial) ... ok
test_challenge_prompts_do_not_override_candidate_dwell_or_locks (test_appearance_trial.VisualTrialTests.test_challenge_prompts_do_not_override_candidate_dwell_or_locks) ... ok
test_daily_tools_camera_loop_composes_saves_displays_and_views_album (test_appearance_trial.VisualTrialTests.test_daily_tools_camera_loop_composes_saves_displays_and_views_album) ... ok
test_display_failure_stops_audio_and_keeps_observations (test_appearance_trial.VisualTrialTests.test_display_failure_stops_audio_and_keeps_observations) ... ok
test_emotions_use_camera_loop_without_speech_except_explicit_help (test_appearance_trial.VisualTrialTests.test_emotions_use_camera_loop_without_speech_except_explicit_help) ... ok
test_entry_requires_every_target_and_sustained_fresh_evidence (test_appearance_trial.VisualTrialTests.test_entry_requires_every_target_and_sustained_fresh_evidence) ... ok
test_failed_reference_shows_failure_and_never_starts_actions (test_appearance_trial.VisualTrialTests.test_failed_reference_shows_failure_and_never_starts_actions) ... ok
test_forty_minute_demo_fake_clock_exits_and_keeps_bounded_records (test_appearance_trial.VisualTrialTests.test_forty_minute_demo_fake_clock_exits_and_keeps_bounded_records) ... ok
test_invalid_current_frame_cannot_reuse_stable_candidate (test_appearance_trial.VisualTrialTests.test_invalid_current_frame_cannot_reuse_stable_candidate) ... ok
test_live_helpers_stop_active_phrase_and_never_resume_it (test_appearance_trial.VisualTrialTests.test_live_helpers_stop_active_phrase_and_never_resume_it) ... ok
test_live_setup_and_display_failures_always_stop_and_mute (test_appearance_trial.VisualTrialTests.test_live_setup_and_display_failures_always_stop_and_mute) ... ok
test_live_speech_once_and_no_held_target_repeat_or_queue (test_appearance_trial.VisualTrialTests.test_live_speech_once_and_no_held_target_repeat_or_queue) ... ok
test_long_run_exceeds_short_audit_limit_without_repeating_held_speech (test_appearance_trial.VisualTrialTests.test_long_run_exceeds_short_audit_limit_without_repeating_held_speech) ... ok
test_more_requires_center_and_holding_more_cannot_trigger_return (test_appearance_trial.VisualTrialTests.test_more_requires_center_and_holding_more_cannot_trigger_return) ... ok
test_music_navigation_uses_real_dwell_and_help_suspends_before_speech (test_appearance_trial.VisualTrialTests.test_music_navigation_uses_real_dwell_and_help_suspends_before_speech) ... ok
test_one_hour_demo_fake_clock_stops_audio_and_keeps_bounded_records (test_appearance_trial.VisualTrialTests.test_one_hour_demo_fake_clock_stops_audio_and_keeps_bounded_records) ... ok
test_pause_cancel_and_clear_remove_dwell_without_clock_trigger (test_appearance_trial.VisualTrialTests.test_pause_cancel_and_clear_remove_dwell_without_clock_trigger) ... ok
test_previous_seed_preserves_fresh_center_requirement_and_bounds (test_appearance_trial.VisualTrialTests.test_previous_seed_preserves_fresh_center_requirement_and_bounds) ... ok
test_quick_pages_require_checked_audible_bank_before_actions (test_appearance_trial.VisualTrialTests.test_quick_pages_require_checked_audible_bank_before_actions) ... ok
test_real_reference_reset_retains_opt_in_but_clears_displayed_expression (test_appearance_trial.VisualTrialTests.test_real_reference_reset_retains_opt_in_but_clears_displayed_expression) ... ok
test_real_region_drives_one_visual_selection_and_held_target_locks (test_appearance_trial.VisualTrialTests.test_real_region_drives_one_visual_selection_and_held_target_locks) ... ok
test_reference_retries_rejected_blink_without_reusing_old_offset (test_appearance_trial.VisualTrialTests.test_reference_retries_rejected_blink_without_reusing_old_offset) ... ok
test_return_rearms_each_visit_without_held_more_auto_return (test_appearance_trial.VisualTrialTests.test_return_rearms_each_visit_without_held_more_auto_return) ... ok
test_runtime_camera_frames_drive_ui_but_no_audio_play_path (test_appearance_trial.VisualTrialTests.test_runtime_camera_frames_drive_ui_but_no_audio_play_path) ... ok
test_setup_progress_never_starts_speech_before_reference_validation (test_appearance_trial.VisualTrialTests.test_setup_progress_never_starts_speech_before_reference_validation) ... ok
test_short_mode_still_refuses_recording_overflow (test_appearance_trial.VisualTrialTests.test_short_mode_still_refuses_recording_overflow) ... ok
test_stale_or_duplicate_frames_cannot_complete_dwell (test_appearance_trial.VisualTrialTests.test_stale_or_duplicate_frames_cannot_complete_dwell) ... ok
test_video_camera_loop_routes_controls_and_stops_before_help_speech (test_appearance_trial.VisualTrialTests.test_video_camera_loop_routes_controls_and_stops_before_help_speech) ... ok
test_video_decoder_cleanup_runs_even_when_display_raises (test_appearance_trial.VisualTrialTests.test_video_decoder_cleanup_runs_even_when_display_raises) ... ok
test_volume_page_routes_real_dwell_once_and_keeps_help_and_cleanup (test_appearance_trial.VisualTrialTests.test_volume_page_routes_real_dwell_once_and_keeps_help_and_cleanup) ... ok
test_wireless_media_and_typing_only_original_actions_send_once (test_appearance_trial.VisualTrialTests.test_wireless_media_and_typing_only_original_actions_send_once) ... ok
test_wireless_missing_receivers_does_not_block_local_media_or_typing (test_appearance_trial.VisualTrialTests.test_wireless_missing_receivers_does_not_block_local_media_or_typing) ... ok
test_wireless_reference_rebind_and_failed_retry_cannot_restore_old_request (test_appearance_trial.VisualTrialTests.test_wireless_reference_rebind_and_failed_retry_cannot_restore_old_request) ... ok
test_busy_cannot_overwrite_pcm_or_restart (test_auxiliary.AudioTests.test_busy_cannot_overwrite_pcm_or_restart) ... ok
test_clock_fault_and_timeout_stop_playback (test_auxiliary.AudioTests.test_clock_fault_and_timeout_stop_playback) ... ok
test_clock_missing_and_invalid_formats_do_not_write (test_auxiliary.AudioTests.test_clock_missing_and_invalid_formats_do_not_write) ... ok
test_codec_bus_16bit_register_repeated_start_and_final_nack (test_auxiliary.AudioTests.test_codec_bus_16bit_register_repeated_start_and_final_nack) ... ok
test_codec_configuration_stays_muted_and_readback_is_required (test_auxiliary.AudioTests.test_codec_configuration_stays_muted_and_readback_is_required) ... ok
test_codec_pll_timeout_is_bounded (test_auxiliary.AudioTests.test_codec_pll_timeout_is_bounded) ... ok
test_i2c_adapter_does_not_touch_camera_video_control (test_auxiliary.AudioTests.test_i2c_adapter_does_not_touch_camera_video_control) ... ok
test_invalid_hardware_rejected_before_writes (test_auxiliary.AudioTests.test_invalid_hardware_rejected_before_writes) ... ok
test_mute_attempts_every_channel_after_failure (test_auxiliary.AudioTests.test_mute_attempts_every_channel_after_failure) ... ok
test_pcm_packing_odd_negative_and_readback (test_auxiliary.AudioTests.test_pcm_packing_odd_negative_and_readback) ... ok
test_phrase_bank_is_bounded_local_and_verified (test_auxiliary.AudioTests.test_phrase_bank_is_bounded_local_and_verified) ... ok
test_unexpected_stop_is_not_reported_as_completion (test_auxiliary.AudioTests.test_unexpected_stop_is_not_reported_as_completion) ... ok
test_warm_codec_requires_pll_disable_before_relock (test_auxiliary.AudioTests.test_warm_codec_requires_pll_disable_before_relock) ... ok
test_boot_pll_divisors_are_recalculated_before_use (test_auxiliary.ClockTests.test_boot_pll_divisors_are_recalculated_before_use) ... ok
test_unexpected_clock_readback_fails_before_dma (test_auxiliary.ClockTests.test_unexpected_clock_readback_fails_before_dma) ... ok
test_bad_clock_or_raw_is_rejected (test_auxiliary.ControlsTests.test_bad_clock_or_raw_is_rejected) ... ok
test_board_loop_respects_buttons_and_exits_without_audio (test_auxiliary.ControlsTests.test_board_loop_respects_buttons_and_exits_without_audio) ... ok
test_bounce_hold_release_and_second_press (test_auxiliary.ControlsTests.test_bounce_hold_release_and_second_press) ... ok
test_cancel_resets_partial_dwell_without_forging_action (test_auxiliary.ControlsTests.test_cancel_resets_partial_dwell_without_forging_action) ... ok
test_clear_calibration_cannot_resume_gaze_selection (test_auxiliary.ControlsTests.test_clear_calibration_cannot_resume_gaze_selection) ... ok
test_simultaneous_commands_prioritize_stop_then_invalidate (test_auxiliary.ControlsTests.test_simultaneous_commands_prioritize_stop_then_invalidate) ... ok
test_startup_held_and_scheduler_gap_never_forge_press (test_auxiliary.ControlsTests.test_startup_held_and_scheduler_gap_never_forge_press) ... ok
test_default_audio_test_never_unmutes (test_auxiliary.ListeningTests.test_default_audio_test_never_unmutes) ... ok
test_display_failure_stops_voice_preserves_incomplete_trace (test_auxiliary.ListeningTests.test_display_failure_stops_voice_preserves_incomplete_trace) ... ok
test_dwell_to_speech_once_per_target_no_held_repetition (test_auxiliary.ListeningTests.test_dwell_to_speech_once_per_target_no_held_repetition) ... ok
test_each_helper_interrupts_audio_no_resume_or_replay (test_auxiliary.ListeningTests.test_each_helper_interrupts_audio_no_resume_or_replay) ... ok
test_listening_opt_in_plays_three_phrases_and_mutes_on_exit (test_auxiliary.ListeningTests.test_listening_opt_in_plays_three_phrases_and_mutes_on_exit) ... ok
test_physical_abort_during_listening_preserves_trace_and_mutes (test_auxiliary.ListeningTests.test_physical_abort_during_listening_preserves_trace_and_mutes) ... ok
test_resume_keeps_interrupted_target_silent_until_fresh_next_dwell (test_auxiliary.ListeningTests.test_resume_keeps_interrupted_target_silent_until_fresh_next_dwell) ... ok
test_active_channel_cannot_be_taken_over (test_board_io.BoardIOTests.test_active_channel_cannot_be_taken_over) ... ok
test_bad_preview_frame_does_not_poison_or_touch_display (test_board_io.BoardIOTests.test_bad_preview_frame_does_not_poison_or_touch_display) ... ok
test_both_channels_must_halt_before_any_free (test_board_io.BoardIOTests.test_both_channels_must_halt_before_any_free) ... ok
test_capture_error_rejects_frame_before_cache_read (test_board_io.BoardIOTests.test_capture_error_rejects_frame_before_cache_read) ... ok
test_capture_fifo_overflow_is_fatal_before_completion (test_board_io.BoardIOTests.test_capture_fifo_overflow_is_fatal_before_completion) ... ok
test_capture_requires_completion_and_invalidates_cache (test_board_io.BoardIOTests.test_capture_requires_completion_and_invalidates_cache) ... ok
test_close_is_idempotent (test_board_io.BoardIOTests.test_close_is_idempotent) ... ok
test_combined_buffers_have_independent_addresses_and_sizes (test_board_io.BoardIOTests.test_combined_buffers_have_independent_addresses_and_sizes) ... ok
test_diagnostic_sequence_wrap_is_accepted (test_board_io.BoardIOTests.test_diagnostic_sequence_wrap_is_accepted) ... ok
test_diagnostic_valid_bit_alone_is_not_fresh (test_board_io.BoardIOTests.test_diagnostic_valid_bit_alone_is_not_fresh) ... ok
test_display_error_during_switch_poisoned_and_buffers_retained (test_board_io.BoardIOTests.test_display_error_during_switch_poisoned_and_buffers_retained) ... ok
test_display_fault_does_not_look_healthy (test_board_io.BoardIOTests.test_display_fault_does_not_look_healthy) ... ok
test_display_programming_and_cache_ownership (test_board_io.BoardIOTests.test_display_programming_and_cache_ownership) ... ok
test_display_start_timeout_never_enables_sink (test_board_io.BoardIOTests.test_display_start_timeout_never_enables_sink) ... ok
test_display_waits_for_delayed_dma_start_before_enabling_sink (test_board_io.BoardIOTests.test_display_waits_for_delayed_dma_start_before_enabling_sink) ... ok
test_dynamic_failed_shutdown_retains_all_four_buffers (test_board_io.BoardIOTests.test_dynamic_failed_shutdown_retains_all_four_buffers) ... ok
test_dynamic_slots_unique_flush_before_request_and_current_slot_ack (test_board_io.BoardIOTests.test_dynamic_slots_unique_flush_before_request_and_current_slot_ack) ... ok
test_failed_request_cannot_be_retried_in_same_session (test_board_io.BoardIOTests.test_failed_request_cannot_be_retried_in_same_session) ... ok
test_foreign_display_pointer_prevents_cpu_buffer_write (test_board_io.BoardIOTests.test_foreign_display_pointer_prevents_cpu_buffer_write) ... ok
test_latched_fault_rejects_even_completed_frame (test_board_io.BoardIOTests.test_latched_fault_rejects_even_completed_frame) ... ok
test_missing_capture_clock_reset_times_out_without_allocation (test_board_io.BoardIOTests.test_missing_capture_clock_reset_times_out_without_allocation) ... ok
test_native_errors_after_dma_reject_copy (test_board_io.BoardIOTests.test_native_errors_after_dma_reject_copy) ... ok
test_native_frame_counter_must_advance_not_just_snapshot_sequence (test_board_io.BoardIOTests.test_native_frame_counter_must_advance_not_just_snapshot_sequence) ... ok
test_native_frame_counter_wrap_is_valid_progress (test_board_io.BoardIOTests.test_native_frame_counter_wrap_is_valid_progress) ... ok
test_native_frame_geometry_rejects_wrong_sensor_window (test_board_io.BoardIOTests.test_native_frame_geometry_rejects_wrong_sensor_window) ... ok
test_native_frames_complete_before_geometry_is_accepted (test_board_io.BoardIOTests.test_native_frames_complete_before_geometry_is_accepted) ... ok
test_no_frame_event_cannot_be_mistaken_for_completion (test_board_io.BoardIOTests.test_no_frame_event_cannot_be_mistaken_for_completion) ... ok
test_overlapping_physical_addresses_are_rejected (test_board_io.BoardIOTests.test_overlapping_physical_addresses_are_rejected) ... ok
test_queue_not_empty_prevents_reuse (test_board_io.BoardIOTests.test_queue_not_empty_prevents_reuse) ... ok
test_repeated_captures_reuse_one_buffer_and_return_owned_copies (test_board_io.BoardIOTests.test_repeated_captures_reuse_one_buffer_and_return_owned_copies) ... ok
test_requested_slot_readback_cannot_hide_stuck_hardware_pointer (test_board_io.BoardIOTests.test_requested_slot_readback_cannot_hide_stuck_hardware_pointer) ... ok
test_reset_recovery_must_complete_before_free (test_board_io.BoardIOTests.test_reset_recovery_must_complete_before_free) ... ok
test_stale_frame_done_cannot_pass_a_new_stalled_capture (test_board_io.BoardIOTests.test_stale_frame_done_cannot_pass_a_new_stalled_capture) ... ok
test_static_display_cannot_be_updated_in_place (test_board_io.BoardIOTests.test_static_display_cannot_be_updated_in_place) ... ok
test_unaligned_address_is_not_programmed (test_board_io.BoardIOTests.test_unaligned_address_is_not_programmed) ... ok
test_wrong_frame_size_does_not_start_dma (test_board_io.BoardIOTests.test_wrong_frame_size_does_not_start_dma) ... ok
test_corrupt_bitstream_is_rejected_before_hwh_or_mmio (test_board_io.ContractTests.test_corrupt_bitstream_is_rejected_before_hwh_or_mmio) ... ok
test_real_built_pair_matches_contract (test_board_io.ContractTests.test_real_built_pair_matches_contract) ... ok
test_affine_predicts_unused_point_and_signed_features (test_calibration.CalibrationTests.test_affine_predicts_unused_point_and_signed_features) ... ok
test_common_pixel_translation_cancels_algebraically (test_calibration.CalibrationTests.test_common_pixel_translation_cancels_algebraically) ... ok
test_context_and_roi_changes_rejected (test_calibration.CalibrationTests.test_context_and_roi_changes_rejected) ... ok
test_degenerate_features_rejected (test_calibration.CalibrationTests.test_degenerate_features_rejected) ... ok
test_independent_failure_does_not_refit (test_calibration.CalibrationTests.test_independent_failure_does_not_refit) ... ok
test_mixed_sessions_and_missing_targets_rejected (test_calibration.CalibrationTests.test_mixed_sessions_and_missing_targets_rejected) ... ok
test_no_extrapolation_or_clipping (test_calibration.CalibrationTests.test_no_extrapolation_or_clipping) ... ok
test_nonfinite_coordinates_and_thresholds_rejected (test_calibration.CalibrationTests.test_nonfinite_coordinates_and_thresholds_rejected) ... ok
test_reused_frame_rejected (test_calibration.CalibrationTests.test_reused_frame_rejected) ... ok
test_blank_one_corner_and_unrelated_images_are_rejected (test_corner_pair.PairCornerTests.test_blank_one_corner_and_unrelated_images_are_rejected) ... ok
test_complete_corners_do_not_allow_missing_feature_crop (test_corner_pair.PairCornerTests.test_complete_corners_do_not_allow_missing_feature_crop) ... ok
test_current_eye_texture_is_used_without_template_substitution (test_corner_pair.PairCornerTests.test_current_eye_texture_is_used_without_template_substitution) ... ok
test_interaction_never_reacquires_outside_frozen_neighborhood (test_corner_pair.PairCornerTests.test_interaction_never_reacquires_outside_frozen_neighborhood) ... ok
test_parallel_and_serial_matching_return_identical_current_pixels (test_corner_pair.PairCornerTests.test_parallel_and_serial_matching_return_identical_current_pixels) ... ok
test_setup_can_relocate_far_without_reusing_skin_template (test_corner_pair.PairCornerTests.test_setup_can_relocate_far_without_reusing_skin_template) ... ok
test_two_complete_same_identity_pairs_are_ambiguous (test_corner_pair.PairCornerTests.test_two_complete_same_identity_pairs_are_ambiguous) ... ok
test_atlas_pages_render_bounded_and_dynamic_text_changes_pixels (test_daily_tools.AlbumAndDisplayTests.test_atlas_pages_render_bounded_and_dynamic_text_changes_pixels) ... ok
test_atlas_rejects_dictionary_mismatch_and_no_binding (test_daily_tools.AlbumAndDisplayTests.test_atlas_rejects_dictionary_mismatch_and_no_binding) ... ok
test_cached_dynamic_pixels_match_fresh_build_after_navigation (test_daily_tools.AlbumAndDisplayTests.test_cached_dynamic_pixels_match_fresh_build_after_navigation) ... ok
test_dynamic_labels_have_readable_contrast_and_help_uses_same_card_layout (test_daily_tools.AlbumAndDisplayTests.test_dynamic_labels_have_readable_contrast_and_help_uses_same_card_layout) ... ok
test_import_replace_path_and_hash_validation (test_daily_tools.AlbumAndDisplayTests.test_import_replace_path_and_hash_validation) ... ok
test_live_dwell_updates_reuse_bounded_text_cache_and_keep_progress_and_cursor (test_daily_tools.AlbumAndDisplayTests.test_live_dwell_updates_reuse_bounded_text_cache_and_keep_progress_and_cursor) ... ok
test_photo_return_caption_is_centered_on_original_gaze_anchor (test_daily_tools.AlbumAndDisplayTests.test_photo_return_caption_is_centered_on_original_gaze_anchor) ... ok
test_three_assets_are_hash_checked_and_cache_one_immutable_frame (test_daily_tools.AlbumAndDisplayTests.test_three_assets_are_hash_checked_and_cache_one_immutable_frame) ... ok
test_candidate_and_favorite_odd_pagination_wraps_without_skipping (test_daily_tools.ComposerTests.test_candidate_and_favorite_odd_pagination_wraps_without_skipping) ... ok
test_draft_survives_navigation_and_reposition_without_automatic_show (test_daily_tools.ComposerTests.test_draft_survives_navigation_and_reposition_without_automatic_show) ... ok
test_empty_candidates_and_empty_draft_do_not_expose_invalid_actions (test_daily_tools.ComposerTests.test_empty_candidates_and_empty_draft_do_not_expose_invalid_actions) ... ok
test_full_body_does_not_consume_pending_candidate (test_daily_tools.ComposerTests.test_full_body_does_not_consume_pending_candidate) ... ok
test_limits_invalid_characters_erase_and_clear (test_daily_tools.ComposerTests.test_limits_invalid_characters_erase_and_clear) ... ok
test_load_delete_and_clear_require_explicit_confirmation (test_daily_tools.ComposerTests.test_load_delete_and_clear_require_explicit_confirmation) ... ok
test_malformed_saved_data_and_dictionary_fail_before_hardware (test_daily_tools.ComposerTests.test_malformed_saved_data_and_dictionary_fail_before_hardware) ... ok
test_pinyin_commits_one_character_then_resets_syllable (test_daily_tools.ComposerTests.test_pinyin_commits_one_character_then_resets_syllable) ... ok
test_save_failure_keeps_previous_disk_and_memory_and_draft (test_daily_tools.ComposerTests.test_save_failure_keeps_previous_disk_and_memory_and_draft) ... ok
test_saved_phrases_survive_reload_duplicate_and_capacity (test_daily_tools.ComposerTests.test_saved_phrases_survive_reload_duplicate_and_capacity) ... ok
test_feature_requires_explicit_complete_local_enable (test_daily_tools.DailyNavigationTests.test_feature_requires_explicit_complete_local_enable) ... ok
test_grouped_gaze_sequence_composes_displays_saves_and_returns (test_daily_tools.DailyNavigationTests.test_grouped_gaze_sequence_composes_displays_saves_and_returns) ... ok
test_pause_cancel_lost_and_invalid_reference_do_not_commit_text (test_daily_tools.DailyNavigationTests.test_pause_cancel_lost_and_invalid_reference_do_not_commit_text) ... ok
test_photo_view_has_only_return_and_cannot_switch_by_looking_at_picture (test_daily_tools.DailyNavigationTests.test_photo_view_has_only_return_and_cannot_switch_by_looking_at_picture) ... ok
test_same_slot_and_invalid_input_cannot_repeat_letters (test_daily_tools.DailyNavigationTests.test_same_slot_and_invalid_input_cannot_repeat_letters) ... ok
test_native_binding_requires_fresh_reference (test_edge_ai_v2.EdgeAITests.test_native_binding_requires_fresh_reference) ... ok
test_native_binding_requires_same_camera (test_edge_ai_v2.EdgeAITests.test_native_binding_requires_same_camera) ... ok
test_oversized_input_rejected (test_edge_ai_v2.EdgeAITests.test_oversized_input_rejected) ... ok
test_special_markers_only_in_template (test_edge_ai_v2.EdgeAITests.test_special_markers_only_in_template) ... ok
test_unicode_round_trip (test_edge_ai_v2.EdgeAITests.test_unicode_round_trip) ... ok
test_user_special_marker_rejected (test_edge_ai_v2.EdgeAITests.test_user_special_marker_rejected) ... ok
test_whitespace_and_contraction_precedence (test_edge_ai_v2.EdgeAITests.test_whitespace_and_contraction_precedence) ... ok
test_missing_or_unknown_expression_is_not_silently_displayed (test_emotions.EmotionDisplayTests.test_missing_or_unknown_expression_is_not_silently_displayed) ... ok
test_panels_are_distinct_bounded_and_all_six_labels_are_present (test_emotions.EmotionDisplayTests.test_panels_are_distinct_bounded_and_all_six_labels_are_present) ... ok
test_six_compiled_panels_and_feedback_match_actual_rgb565_artwork (test_emotions.EmotionDisplayTests.test_six_compiled_panels_and_feedback_match_actual_rgb565_artwork) ... ok
test_bottom_left_expression_cannot_immediately_trigger_help_on_display (test_emotions.EmotionNavigationTests.test_bottom_left_expression_cannot_immediately_trigger_help_on_display) ... ok
test_communication_and_music_return_to_new_menu_without_changing_original_phrases (test_emotions.EmotionNavigationTests.test_communication_and_music_return_to_new_menu_without_changing_original_phrases) ... ok
test_explicit_local_option_does_not_change_old_menu_and_rejects_partial_enable (test_emotions.EmotionNavigationTests.test_explicit_local_option_does_not_change_old_menu_and_rejects_partial_enable) ... ok
test_lost_pause_cancel_and_invalid_calibration_prevent_expression_selection (test_emotions.EmotionNavigationTests.test_lost_pause_cancel_and_invalid_calibration_prevent_expression_selection) ... ok
test_new_pages_keep_original_regions_and_large_display_is_not_a_target (test_emotions.EmotionNavigationTests.test_new_pages_keep_original_regions_and_large_display_is_not_a_target) ... ok
test_six_cards_and_repeated_return_stay_visual_and_restore_source_page (test_emotions.EmotionNavigationTests.test_six_cards_and_repeated_return_stay_visual_and_restore_source_page) ... ok
test_delegates_once_and_records_complete_track_once (test_endurance_observer.ObserverTests.test_delegates_once_and_records_complete_track_once) ... ok
test_mismatched_completion_is_marked_and_history_bounded (test_endurance_observer.ObserverTests.test_mismatched_completion_is_marked_and_history_bounded) ... ok
test_original_fault_propagates_without_false_completion (test_endurance_observer.ObserverTests.test_original_fault_propagates_without_false_completion) ... ok
test_unavailable_teammate_interface_is_not_accepted (test_events.BusyAckTests.test_unavailable_teammate_interface_is_not_accepted) ... ok
test_errors_read_to_clear_detected_and_reset (test_events.DriverTests.test_errors_read_to_clear_detected_and_reset) ... ok
test_fifo_bounds_and_busy_are_nonblocking (test_events.DriverTests.test_fifo_bounds_and_busy_are_nonblocking) ... ok
test_frame_size_validation_before_mmio (test_events.DriverTests.test_frame_size_validation_before_mmio) ... ok
test_uart_fault_aborts_link (test_events.DriverTests.test_uart_fault_aborts_link) ... ok
test_all_helpers_stop_retry_without_sending_another_action (test_events.IntegratedControlTests.test_all_helpers_stop_retry_without_sending_another_action) ... ok
test_display_failure_aborts_communication_too (test_events.IntegratedControlTests.test_display_failure_aborts_communication_too) ... ok
test_speech_and_event_share_same_dwell_action (test_events.IntegratedControlTests.test_speech_and_event_share_same_dwell_action) ... ok
test_crc_corruption_noise_and_partial_bound (test_events.ProtocolTests.test_crc_corruption_noise_and_partial_bound) ... ok
test_crc_known_check_and_little_endian (test_events.ProtocolTests.test_crc_known_check_and_little_endian) ... ok
test_duplicate_hello_does_not_clear_highwater (test_events.ProtocolTests.test_duplicate_hello_does_not_clear_highwater) ... ok
test_every_single_bit_error_rejected (test_events.ProtocolTests.test_every_single_bit_error_rejected) ... ok
test_fragmentation_and_concatenation (test_events.ProtocolTests.test_fragmentation_and_concatenation) ... ok
test_invalid_event_and_ack_storm_prevention (test_events.ProtocolTests.test_invalid_event_and_ack_storm_prevention) ... ok
test_invalid_version_kind_session_size (test_events.ProtocolTests.test_invalid_version_kind_session_size) ... ok
test_old_or_conflicting_sequence_rejected (test_events.ProtocolTests.test_old_or_conflicting_sequence_rejected) ... ok
test_receiver_duplicate_event_is_ack_only (test_events.ProtocolTests.test_receiver_duplicate_event_is_ack_only) ... ok
test_receiver_reboot_expiry_and_unknown_session (test_events.ProtocolTests.test_receiver_reboot_expiry_and_unknown_session) ... ok
test_test_mode_needs_both_sides_opt_in (test_events.ProtocolTests.test_test_mode_needs_both_sides_opt_in) ... ok
test_ack_timeout_unknown_no_replay_after_reconnect (test_events.SenderTests.test_ack_timeout_unknown_no_replay_after_reconnect) ... ok
test_cancel_before_send_and_after_send_stop_retries (test_events.SenderTests.test_cancel_before_send_and_after_send_stop_retries) ... ok
test_deferred_action_expires_while_ping_ack_missing (test_events.SenderTests.test_deferred_action_expires_while_ping_ack_missing) ... ok
test_disconnected_or_busy_actions_not_replayed (test_events.SenderTests.test_disconnected_or_busy_actions_not_replayed) ... ok
test_finite_clock_and_sequence_exhaustion (test_events.SenderTests.test_finite_clock_and_sequence_exhaustion) ... ok
test_full_dwell_scenario_delivers_only_selected_actions (test_events.SenderTests.test_full_dwell_scenario_delivers_only_selected_actions) ... ok
test_heartbeat_can_defer_one_fresh_action (test_events.SenderTests.test_heartbeat_can_defer_one_fresh_action) ... ok
test_invalid_input_pause_calibration_clear_prevent_send (test_events.SenderTests.test_invalid_input_pause_calibration_clear_prevent_send) ... ok
test_lost_ack_retries_same_id_executes_once (test_events.SenderTests.test_lost_ack_retries_same_id_executes_once) ... ok
test_normal_all_five_events (test_events.SenderTests.test_normal_all_five_events) ... ok
test_receiver_reboot_rejects_pending_event (test_events.SenderTests.test_receiver_reboot_rejects_pending_event) ... ok
test_service_stall_aborts_instead_of_retrying (test_events.SenderTests.test_service_stall_aborts_instead_of_retrying) ... ok
test_stale_duplicate_future_replay_and_simulated_default_blocked (test_events.SenderTests.test_stale_duplicate_future_replay_and_simulated_default_blocked) ... ok
test_transport_busy_does_not_spin (test_events.SenderTests.test_transport_busy_does_not_spin) ... ok
test_unsent_event_expires_instead_of_delayed_send (test_events.SenderTests.test_unsent_event_expires_instead_of_delayed_send) ... ok
test_wrong_or_stale_ack_does_not_confirm (test_events.SenderTests.test_wrong_or_stale_ack_does_not_confirm) ... ok
test_confirmation_following_and_immediate_loss_do_not_hold_stale_box (test_eye_region.EyeRegionTests.test_confirmation_following_and_immediate_loss_do_not_hold_stale_box) ... ok
test_duplicate_suppression_bounds_and_clipped_display_crop (test_eye_region.EyeRegionTests.test_duplicate_suppression_bounds_and_clipped_display_crop) ... ok
test_long_gap_reconfirms_and_cannot_directly_jump_to_other_eye (test_eye_region.EyeRegionTests.test_long_gap_reconfirms_and_cannot_directly_jump_to_other_eye) ... ok
test_no_eye_frames_and_invalid_identity_never_create_location (test_eye_region.EyeRegionTests.test_no_eye_frames_and_invalid_identity_never_create_location) ... ok
test_appearance_plan_has_separate_visits_and_bounded_owned_records (test_fixation.FixationTests.test_appearance_plan_has_separate_visits_and_bounded_owned_records) ... ok
test_runner_labels_only_after_confirmed_presentation_and_limits_memory (test_fixation.FixationTests.test_runner_labels_only_after_confirmed_presentation_and_limits_memory) ... ok
test_transition_frames_excluded_and_owned_samples_keep_instructed_labels (test_fixation.FixationTests.test_transition_frames_excluded_and_owned_samples_keep_instructed_labels) ... ok
test_all_words_round_trip (test_framebuffer.FramebufferTests.test_all_words_round_trip) ... ok
test_padding_and_reject_wrong_frame (test_framebuffer.FramebufferTests.test_padding_and_reject_wrong_frame) ... ok
test_primary_colors_byte_order (test_framebuffer.FramebufferTests.test_primary_colors_byte_order) ... ok
test_quantization_bound_and_not_bgr (test_framebuffer.FramebufferTests.test_quantization_bound_and_not_bgr) ... ok
test_separate_dma_row_sizes (test_framebuffer.FramebufferTests.test_separate_dma_row_sizes) ... ok
test_common_readings_rank_before_rare_aliases_and_favorites_refresh_cache (test_free_text.FreeTextTests.test_common_readings_rank_before_rare_aliases_and_favorites_refresh_cache) ... ok
test_dictionary_rejects_malformed_or_mismatched_aliases (test_free_text.FreeTextTests.test_dictionary_rejects_malformed_or_mismatched_aliases) ... ok
test_every_compiled_entry_has_reachable_alias_and_every_character_is_retained (test_free_text.FreeTextTests.test_every_compiled_entry_has_reachable_alias_and_every_character_is_retained) ... ok
test_full_buffer_rejects_whole_word_without_consuming_it (test_free_text.FreeTextTests.test_full_buffer_rejects_whole_word_without_consuming_it) ... ok
test_initials_candidate_return_preserves_page_and_separates_full_pinyin (test_free_text.FreeTextTests.test_initials_candidate_return_preserves_page_and_separates_full_pinyin) ... ok
test_long_display_fits_four_lines_and_reuses_cache_for_dwell (test_free_text.FreeTextTests.test_long_display_fits_four_lines_and_reuses_cache_for_dwell) ... ok
test_long_favorites_roundtrip_and_old_phrases_are_compatible (test_free_text.FreeTextTests.test_long_favorites_roundtrip_and_old_phrases_are_compatible) ... ok
test_new_sentence_composes_multiple_words_without_finish_detours (test_free_text.FreeTextTests.test_new_sentence_composes_multiple_words_without_finish_detours) ... ok
test_page_navigation_wraps_and_never_commits_or_loses_initials (test_free_text.FreeTextTests.test_page_navigation_wraps_and_never_commits_or_loses_initials) ... ok
test_punctuation_return_and_confirmed_load_keep_navigation_consistent (test_free_text.FreeTextTests.test_punctuation_return_and_confirmed_load_keep_navigation_consistent) ... ok
test_same_target_hold_and_invalid_input_cannot_append_a_second_word (test_free_text.FreeTextTests.test_same_target_hold_and_invalid_input_cannot_append_a_second_word) ... ok
test_undo_history_is_bounded_and_pending_full_pinyin_is_preserved (test_free_text.FreeTextTests.test_undo_history_is_bounded_and_pending_full_pinyin_is_preserved) ... ok
test_undo_removes_last_word_only_and_can_restore_deleted_text (test_free_text.FreeTextTests.test_undo_removes_last_word_only_and_can_restore_deleted_text) ... ok
test_cancel_requires_new_dwell (test_interaction.DwellTests.test_cancel_requires_new_dwell) ... ok
test_changed_context_invalidates_calibration (test_interaction.DwellTests.test_changed_context_invalidates_calibration) ... ok
test_clock_regression_stops_controller (test_interaction.DwellTests.test_clock_regression_stops_controller) ... ok
test_duplicate_reorder_future_stale_and_nonfinite_rejected (test_interaction.DwellTests.test_duplicate_reorder_future_stale_and_nonfinite_rejected) ... ok
test_exact_dwell_once_and_no_repeat (test_interaction.DwellTests.test_exact_dwell_once_and_no_repeat) ... ok
test_gap_resets_even_without_timer_ticks (test_interaction.DwellTests.test_gap_resets_even_without_timer_ticks) ... ok
test_invalid_input_cannot_unlock (test_interaction.DwellTests.test_invalid_input_cannot_unlock) ... ok
test_lost_closed_unknown_clear_progress (test_interaction.DwellTests.test_lost_closed_unknown_clear_progress) ... ok
test_more_and_back_require_separate_dwell (test_interaction.DwellTests.test_more_and_back_require_separate_dwell) ... ok
test_new_more_visit_rearms_only_return_and_requires_full_fresh_dwell (test_interaction.DwellTests.test_new_more_visit_rearms_only_return_and_requires_full_fresh_dwell) ... ok
test_pause_clears_progress_and_preserves_locks (test_interaction.DwellTests.test_pause_clears_progress_and_preserves_locks) ... ok
test_pause_status_survives_timer (test_interaction.DwellTests.test_pause_status_survives_timer) ... ok
test_short_exit_does_not_rearm (test_interaction.DwellTests.test_short_exit_does_not_rearm) ... ok
test_tick_never_selects (test_interaction.DwellTests.test_tick_never_selects) ... ok
test_uncalibrated_and_stopped_cannot_select (test_interaction.DwellTests.test_uncalibrated_and_stopped_cannot_select) ... ok
test_valid_exit_rearms (test_interaction.DwellTests.test_valid_exit_rearms) ... ok
test_capacity_exhaustion_fails_instead_of_discarding_evidence (test_invalid_input.InvalidInputTests.test_capacity_exhaustion_fails_instead_of_discarding_evidence) ... ok
test_incomplete_save_cannot_claim_invalid_input_passed (test_invalid_input.InvalidInputTests.test_incomplete_save_cannot_claim_invalid_input_passed) ... ok
test_portable_prompts_cover_every_phase (test_invalid_input.InvalidInputTests.test_portable_prompts_cover_every_phase) ... ok
test_prompt_does_not_force_rejection_and_every_challenge_capture_has_evidence (test_invalid_input.InvalidInputTests.test_prompt_does_not_force_rejection_and_every_challenge_capture_has_evidence) ... ok
test_return_uses_same_engine_without_new_reference (test_invalid_input.InvalidInputTests.test_return_uses_same_engine_without_new_reference) ... ok
test_runner_keeps_full_challenge_and_checks_link_errors (test_invalid_input.InvalidInputTests.test_runner_keeps_full_challenge_and_checks_link_errors) ... ok
test_sequence_has_positive_checks_before_and_after_each_challenge (test_invalid_input.InvalidInputTests.test_sequence_has_positive_checks_before_and_after_each_challenge) ... ok
test_board_exit_code_and_actual_result_are_preserved (test_launch.LaunchTests.test_board_exit_code_and_actual_result_are_preserved) ... ok
test_daily_tools_require_explicit_flag_complete_features_and_support_wireless_opt_in (test_launch.LaunchTests.test_daily_tools_require_explicit_flag_complete_features_and_support_wireless_opt_in) ... ok
test_demo_window_requires_cli_opt_in_and_keeps_profile_and_wireless_defaults (test_launch.LaunchTests.test_demo_window_requires_cli_opt_in_and_keeps_profile_and_wireless_defaults) ... ok
test_emotion_cards_require_explicit_local_feature_combination (test_launch.LaunchTests.test_emotion_cards_require_explicit_local_feature_combination) ... ok
test_failed_board_gate_does_not_forge_run_or_success (test_launch.LaunchTests.test_failed_board_gate_does_not_forge_run_or_success) ... ok
test_import_has_no_numpy_pynq_or_board_dependency (test_launch.LaunchTests.test_import_has_no_numpy_pynq_or_board_dependency) ... ok
test_missing_independent_evidence_is_not_accepted (test_launch.LaunchTests.test_missing_independent_evidence_is_not_accepted) ... ok
test_music_opt_in_requires_audible_profile_and_matching_build (test_launch.LaunchTests.test_music_opt_in_requires_audible_profile_and_matching_build) ... ok
test_no_unbounded_or_nonfinite_duration (test_launch.LaunchTests.test_no_unbounded_or_nonfinite_duration) ... ok
test_offline_check_never_invokes_board (test_launch.LaunchTests.test_offline_check_never_invokes_board) ... ok
test_paths_cannot_escape_project (test_launch.LaunchTests.test_paths_cannot_escape_project) ... ok
test_profile_cannot_enable_hidden_wireless_or_scripted_controls (test_launch.LaunchTests.test_profile_cannot_enable_hidden_wireless_or_scripted_controls) ... ok
test_quick_phrases_explicit_flag_required_with_new_ip_and_assets (test_launch.LaunchTests.test_quick_phrases_explicit_flag_required_with_new_ip_and_assets) ... ok
test_reposition_is_explicit_and_preserves_wireless_opt_in (test_launch.LaunchTests.test_reposition_is_explicit_and_preserves_wireless_opt_in) ... ok
test_stale_artifact_or_model_cannot_launch (test_launch.LaunchTests.test_stale_artifact_or_model_cannot_launch) ... ok
test_unique_output_and_checks_do_not_create_files (test_launch.LaunchTests.test_unique_output_and_checks_do_not_create_files) ... ok
test_wrong_boolean_and_duplicate_json_are_rejected (test_launch.LaunchTests.test_wrong_boolean_and_duplicate_json_are_rejected) ... ok
test_media_branch_preserves_old_album_and_no_hardware_action_on_selection (test_local_video.VideoNavigationTests.test_media_branch_preserves_old_album_and_no_hardware_action_on_selection) ... ok
test_video_launch_requires_explicit_local_dependencies (test_local_video.VideoNavigationTests.test_video_launch_requires_explicit_local_dependencies) ... ok
test_watch_renderer_reuses_cache_while_progress_and_frames_change (test_local_video.VideoNavigationTests.test_watch_renderer_reuses_cache_while_progress_and_frames_change) ... ok
test_watch_upper_targets_cannot_select_and_lower_help_control_need_new_dwell (test_local_video.VideoNavigationTests.test_watch_upper_targets_cannot_select_and_lower_help_control_need_new_dwell) ... ok
test_audio_clock_uses_consumed_samples_and_help_resume_keeps_sample_order (test_local_video.VideoTests.test_audio_clock_uses_consumed_samples_and_help_resume_keeps_sample_order) ... ok
test_audio_sample_count_and_peak_checked_before_play (test_local_video.VideoTests.test_audio_sample_count_and_peak_checked_before_play) ... ok
test_busy_retired_process_blocks_new_worker (test_local_video.VideoTests.test_busy_retired_process_blocks_new_worker) ... ok
test_catalogue_rejects_traversal_bad_hash_duration_shape_and_duplicates (test_local_video.VideoTests.test_catalogue_rejects_traversal_bad_hash_duration_shape_and_duplicates) ... ok
test_decode_fault_stops_audio_and_never_automatically_restarts (test_local_video.VideoTests.test_decode_fault_stops_audio_and_never_automatically_restarts) ... ok
test_empty_library_never_starts_worker_or_audio (test_local_video.VideoTests.test_empty_library_never_starts_worker_or_audio) ... ok
test_paused_video_cleanup_does_not_stop_a_later_speech_owner (test_local_video.VideoTests.test_paused_video_cleanup_does_not_stop_a_later_speech_owner) ... ok
test_return_next_and_exit_discard_old_decode_frames (test_local_video.VideoTests.test_return_next_and_exit_discard_old_decode_frames) ... ok
test_silent_pause_freezes_clock_and_picture_then_resumes_explicitly (test_local_video.VideoTests.test_silent_pause_freezes_clock_and_picture_then_resumes_explicitly) ... ok
test_startup_and_decode_lag_have_bounded_timeouts (test_local_video.VideoTests.test_startup_and_decode_lag_have_bounded_timeouts) ... ok
test_import_scales_peak_binds_hash_and_refuses_overwrite (test_music.ImportTests.test_import_scales_peak_binds_hash_and_refuses_overwrite) ... ok
test_new_page_requires_release_and_new_full_dwell (test_music.MusicNavigationTests.test_new_page_requires_release_and_new_full_dwell) ... ok
test_pause_and_clear_still_block_music_actions (test_music.MusicNavigationTests.test_pause_and_clear_still_block_music_actions) ... ok
test_alive_bclk_without_sample_progress_has_bounded_timeout (test_music.MusicTests.test_alive_bclk_without_sample_progress_has_bounded_timeout) ... ok
test_changed_music_is_not_played_using_old_validation (test_music.MusicTests.test_changed_music_is_not_played_using_old_validation) ... ok
test_clock_fault_does_not_trigger_resume_or_retry (test_music.MusicTests.test_clock_fault_does_not_trigger_resume_or_retry) ... ok
test_committed_bank_cannot_be_overwritten_by_driver (test_music.MusicTests.test_committed_bank_cannot_be_overwritten_by_driver) ... ok
test_empty_playlist_never_starts_audio (test_music.MusicTests.test_empty_playlist_never_starts_audio) ... ok
test_help_suspend_releases_hardware_and_explicit_resume_restarts_at_cursor (test_music.MusicTests.test_help_suspend_releases_hardware_and_explicit_resume_restarts_at_cursor) ... ok
test_legacy_ip_is_rejected_before_stream_register_writes (test_music.MusicTests.test_legacy_ip_is_rejected_before_stream_register_writes) ... ok
test_legacy_phrase_device_selects_legacy_mode_on_v2 (test_music.MusicTests.test_legacy_phrase_device_selects_legacy_mode_on_v2) ... ok
test_long_music_crosses_reused_banks_in_order_and_finishes_once (test_music.MusicTests.test_long_music_crosses_reused_banks_in_order_and_finishes_once) ... ok
test_manifest_path_escape_and_hash_mismatch_are_rejected (test_music.MusicTests.test_manifest_path_escape_and_hash_mismatch_are_rejected) ... ok
test_next_wraps_and_return_discards_resume_position (test_music.MusicTests.test_next_wraps_and_return_discards_resume_position) ... ok
test_pause_ack_timeout_is_bounded (test_music.MusicTests.test_pause_ack_timeout_is_bounded) ... ok
test_pause_resume_keeps_cursor_and_no_audio_during_pause (test_music.MusicTests.test_pause_resume_keeps_cursor_and_no_audio_during_pause) ... ok
test_peak_and_bad_wav_are_rejected_before_play (test_music.MusicTests.test_peak_and_bad_wav_are_rejected_before_play) ... ok
test_underflow_stops_closes_and_never_repeats_old_data (test_music.MusicTests.test_underflow_stops_closes_and_never_repeats_old_data) ... ok
test_corrupt_or_unbounded_saved_volume_is_not_silently_accepted (test_music_controls.MusicControlTests.test_corrupt_or_unbounded_saved_volume_is_not_silently_accepted) ... ok
test_display_empty_and_one_hour_bounds (test_music_controls.MusicControlTests.test_display_empty_and_one_hour_bounds) ... ok
test_gain_is_bounded_symmetric_and_preserves_samples_across_banks (test_music_controls.MusicControlTests.test_gain_is_bounded_symmetric_and_preserves_samples_across_banks) ... ok
test_live_buffers_cannot_be_rewritten_by_volume_controls (test_music_controls.MusicControlTests.test_live_buffers_cannot_be_rewritten_by_volume_controls) ... ok
test_multiline_titles_cannot_silently_overflow_display (test_music_controls.MusicControlTests.test_multiline_titles_cannot_silently_overflow_display) ... ok
test_paused_progress_tracks_consumption_and_end_then_return_resets (test_music_controls.MusicControlTests.test_paused_progress_tracks_consumption_and_end_then_return_resets) ... ok
test_save_failure_keeps_previous_volume_and_file (test_music_controls.MusicControlTests.test_save_failure_keeps_previous_volume_and_file) ... ok
test_saved_volume_is_validated_before_library_is_usable (test_music_controls.MusicControlTests.test_saved_volume_is_validated_before_library_is_usable) ... ok
test_volume_is_remembered_and_clamped_without_wrapping (test_music_controls.MusicControlTests.test_volume_is_remembered_and_clamped_without_wrapping) ... ok
test_compiled_titles_progress_and_volumes_match_artwork (test_music_controls.MusicDisplayTests.test_compiled_titles_progress_and_volumes_match_artwork) ... ok
test_playlist_titles_bind_order_text_audio_identity_and_duration (test_music_controls.MusicDisplayTests.test_playlist_titles_bind_order_text_audio_identity_and_duration) ... ok
test_music_pages_keep_same_large_regions_and_help_location (test_music_controls.MusicVolumeNavigationTests.test_music_pages_keep_same_large_regions_and_help_location) ... ok
test_volume_entry_needs_release_and_each_step_needs_new_dwell (test_music_controls.MusicVolumeNavigationTests.test_volume_entry_needs_release_and_each_step_needs_new_dwell) ... ok
test_attach_after_reference_refused (test_neural.NeuralTests.test_attach_after_reference_refused) ... ok
test_attach_bound_to_appearance_before_reference (test_neural.NeuralTests.test_attach_bound_to_appearance_before_reference) ... ok
test_attach_wrong_geometry_refused (test_neural.NeuralTests.test_attach_wrong_geometry_refused) ... ok
test_busy_upload_refused (test_neural.NeuralTests.test_busy_upload_refused) ... ok
test_consensus_disagreement_rejects (test_neural.NeuralTests.test_consensus_disagreement_rejects) ... ok
test_declared_schema_required (test_neural.NeuralTests.test_declared_schema_required) ... ok
test_driver_rejects_wrong_identity (test_neural.NeuralTests.test_driver_rejects_wrong_identity) ... ok
test_driver_rejects_wrong_layer_and_dtype (test_neural.NeuralTests.test_driver_rejects_wrong_layer_and_dtype) ... ok
test_driver_requires_upload (test_neural.NeuralTests.test_driver_requires_upload) ... ok
test_guard_never_bypasses_legacy (test_neural.NeuralTests.test_guard_never_bypasses_legacy) ... ok
test_hardware_error_rejects_without_fallback (test_neural.NeuralTests.test_hardware_error_rejects_without_fallback) ... ok
test_hardware_reset_detected (test_neural.NeuralTests.test_hardware_reset_detected) ... ok
test_hash_binding (test_neural.NeuralTests.test_hash_binding) ... ok
test_invalid_feature_rejected (test_neural.NeuralTests.test_invalid_feature_rejected) ... ok
test_legacy_rejection_skips_neural (test_neural.NeuralTests.test_legacy_rejection_skips_neural) ... ok
test_model_memory_layout (test_neural.NeuralTests.test_model_memory_layout) ... ok
test_nonfinite_scale_and_input_rejected (test_neural.NeuralTests.test_nonfinite_scale_and_input_rejected) ... ok
test_parameter_shape_rejected (test_neural.NeuralTests.test_parameter_shape_rejected) ... ok
test_parameters_immutable (test_neural.NeuralTests.test_parameters_immutable) ... ok
test_probabilities_normalized (test_neural.NeuralTests.test_probabilities_normalized) ... ok
test_ps_driver_matches_integer_network (test_neural.NeuralTests.test_ps_driver_matches_integer_network) ... ok
test_symmetric_rounding_and_saturation (test_neural.NeuralTests.test_symmetric_rounding_and_saturation) ... ok
test_timeout_aborts_and_requires_reload (test_neural.NeuralTests.test_timeout_aborts_and_requires_reload) ... ok
test_audio_fault_preserves_last_known_cursor_and_releases (test_pastimes.BookTests.test_audio_fault_preserves_last_known_cursor_and_releases) ... ok
test_chapter_switch_preserves_each_cursor_without_autoplay (test_pastimes.BookTests.test_chapter_switch_preserves_each_cursor_without_autoplay) ... ok
test_corrupt_or_changed_bookmarks_never_resume_invalid_offset (test_pastimes.BookTests.test_corrupt_or_changed_bookmarks_never_resume_invalid_offset) ... ok
test_empty_book_library_never_starts (test_pastimes.BookTests.test_empty_book_library_never_starts) ... ok
test_help_suspend_releases_stream_and_does_not_autoresume (test_pastimes.BookTests.test_help_suspend_releases_stream_and_does_not_autoresume) ... ok
test_natural_end_does_not_play_next_chapter (test_pastimes.BookTests.test_natural_end_does_not_play_next_chapter) ... ok
test_pause_restart_instance_and_explicit_resume_keep_exact_cursor (test_pastimes.BookTests.test_pause_restart_instance_and_explicit_resume_keep_exact_cursor) ... ok
test_save_error_does_not_prevent_audio_stop_and_recovery (test_pastimes.BookTests.test_save_error_does_not_prevent_audio_stop_and_recovery) ... ok
test_five_untimed_rounds_require_explicit_correct_answer_and_next (test_pastimes.GameTests.test_five_untimed_rounds_require_explicit_correct_answer_and_next) ... ok
test_matching_has_one_correct_shape_and_restart_resets (test_pastimes.GameTests.test_matching_has_one_correct_shape_and_restart_resets) ... ok
test_new_routes_and_game_answer_cannot_chain_on_held_gaze (test_pastimes.GameTests.test_new_routes_and_game_answer_cannot_chain_on_held_gaze) ... ok
test_explicit_flag_and_wireless_isolation (test_pastimes.PastimeLaunchTests.test_explicit_flag_and_wireless_isolation) ... skipped 'requires optional local private profile or AI runtime bundle'
test_board_legacy_bitmap_font_without_getbbox (test_preview.PreviewTests.test_board_legacy_bitmap_font_without_getbbox) ... ok
test_clipping_and_invalid_camera_data_are_not_silently_accepted (test_preview.PreviewTests.test_clipping_and_invalid_camera_data_are_not_silently_accepted) ... ok
test_eye_region_uses_current_pixels_and_blanks_immediately_on_loss (test_preview.PreviewTests.test_eye_region_uses_current_pixels_and_blanks_immediately_on_loss) ... ok
test_fast_regions_match_reference_full_canvas_on_textured_frames (test_preview.PreviewTests.test_fast_regions_match_reference_full_canvas_on_textured_frames) ... ok
test_image_layout_keeps_real_pixels_and_center_magnification (test_preview.PreviewTests.test_image_layout_keeps_real_pixels_and_center_magnification) ... ok
test_brightness_changes_and_roi_edges_are_measured (test_preview_recording.PreviewRecordingTests.test_brightness_changes_and_roi_edges_are_measured) ... ok
test_capacity_and_failed_run_provenance (test_preview_recording.PreviewRecordingTests.test_capacity_and_failed_run_provenance) ... ok
test_invalid_input_does_not_append_measurements (test_preview_recording.PreviewRecordingTests.test_invalid_input_does_not_append_measurements) ... ok
test_owned_samples_survive_reused_camera_buffer (test_preview_recording.PreviewRecordingTests.test_owned_samples_survive_reused_camera_buffer) ... ok
test_sampling_is_bounded_and_skips_missing_bins (test_preview_recording.PreviewRecordingTests.test_sampling_is_bounded_and_skips_missing_bins) ... ok
test_feature_flags_only_expose_available_menu_entries (test_quick_phrases.QuickInteractionTests.test_feature_flags_only_expose_available_menu_entries) ... ok
test_held_menu_gaze_and_invalid_frames_cannot_choose_child (test_quick_phrases.QuickInteractionTests.test_held_menu_gaze_and_invalid_frames_cannot_choose_child) ... ok
test_partial_dwell_and_cleared_calibration_do_not_emit (test_quick_phrases.QuickInteractionTests.test_partial_dwell_and_cleared_calibration_do_not_emit) ... ok
test_two_pages_all_phrases_and_repeated_visits (test_quick_phrases.QuickInteractionTests.test_two_pages_all_phrases_and_repeated_visits) ... ok
test_catalog_targets_pcm_and_manifest_agree (test_quick_phrases.QuickSpeechTests.test_catalog_targets_pcm_and_manifest_agree) ... ok
test_changed_text_or_audio_is_rejected (test_quick_phrases.QuickSpeechTests.test_changed_text_or_audio_is_rejected) ... ok
test_new_utterances_keep_live_identity_freshness_and_no_queue (test_quick_phrases.QuickSpeechTests.test_new_utterances_keep_live_identity_freshness_and_no_queue) ... ok
test_oversized_asset_is_rejected_before_audio_read (test_quick_phrases.QuickSpeechTests.test_oversized_asset_is_rejected_before_audio_read) ... ok
test_busy_queue_fault_timeout_and_incomplete_completion_fail_closed (test_quick_phrases.StreamedPhraseTests.test_busy_queue_fault_timeout_and_incomplete_completion_fail_closed) ... ok
test_complete_long_pcm_order_and_final_sample (test_quick_phrases.StreamedPhraseTests.test_complete_long_pcm_order_and_final_sample) ... ok
test_stop_discards_tail_and_does_not_resume_on_poll (test_quick_phrases.StreamedPhraseTests.test_stop_discards_tail_and_does_not_resume_on_poll) ... ok
test_two_consecutive_long_utterances_start_from_sample_zero (test_quick_phrases.StreamedPhraseTests.test_two_consecutive_long_utterances_start_from_sample_zero) ... ok
test_cancel_never_replays_on_reconnect (test_receiver_sharing.SharingTests.test_cancel_never_replays_on_reconnect) ... ok
test_commit_uncertainty_and_no_private_fragment_bytes_in_trace (test_receiver_sharing.SharingTests.test_commit_uncertainty_and_no_private_fragment_bytes_in_trace) ... ok
test_confirmed_short_message_finishes_while_gaze_remains_unknown (test_receiver_sharing.SharingTests.test_confirmed_short_message_finishes_while_gaze_remains_unknown) ... ok
test_full_message_and_blink_after_commit_intent (test_receiver_sharing.SharingTests.test_full_message_and_blink_after_commit_intent) ... ok
test_help_preempts_fragments_and_stays_v1 (test_receiver_sharing.SharingTests.test_help_preempts_fragments_and_stays_v1) ... ok
test_helper_pause_still_cancels_confirmed_transfer (test_receiver_sharing.SharingTests.test_helper_pause_still_cancels_confirmed_transfer) ... ok
test_inflight_ping_ack_sends_begin_without_another_frame (test_receiver_sharing.SharingTests.test_inflight_ping_ack_sends_begin_without_another_frame) ... ok
test_old_firmware_is_not_sent_new_content (test_receiver_sharing.SharingTests.test_old_firmware_is_not_sent_new_content) ... ok
test_text_bounds_and_command_characters (test_receiver_sharing.SharingTests.test_text_bounds_and_command_characters) ... ok
test_trial_boundary_keeps_local_actions_local_and_honors_opt_out (test_receiver_sharing.SharingTests.test_trial_boundary_keeps_local_actions_local_and_honors_opt_out) ... ok
test_ui_freezes_text_and_requires_final_confirmation (test_receiver_sharing.SharingTests.test_ui_freezes_text_and_requires_final_confirmation) ... ok
test_v1_bytes_and_mixed_resynchronization (test_receiver_sharing.SharingTests.test_v1_bytes_and_mixed_resynchronization) ... ok
test_wrong_version_ack_rejected_and_freshness_kept (test_receiver_sharing.SharingTests.test_wrong_version_ack_rejected_and_freshness_kept) ... ok
test_cancel_discards_partial_reference_and_fresh_retry_can_pass (test_reposition.AssistedReferenceTests.test_cancel_discards_partial_reference_and_fresh_retry_can_pass) ... ok
test_capture_failure_propagates_with_actions_disabled (test_reposition.AssistedReferenceTests.test_capture_failure_propagates_with_actions_disabled) ... ok
test_exit_works_in_preview_and_collection (test_reposition.AssistedReferenceTests.test_exit_works_in_preview_and_collection) ... ok
test_failed_collection_stays_unavailable_and_requires_new_press (test_reposition.AssistedReferenceTests.test_failed_collection_stays_unavailable_and_requires_new_press) ... ok
test_held_start_does_not_repeat_and_pre_prompt_capture_is_excluded (test_reposition.AssistedReferenceTests.test_held_start_does_not_repeat_and_pre_prompt_capture_is_excluded) ... ok
test_preview_never_collects_or_reuses_old_partial_dwell_without_confirmation (test_reposition.AssistedReferenceTests.test_preview_never_collects_or_reuses_old_partial_dwell_without_confirmation) ... ok
test_retry_limit_and_global_deadline_do_not_enable_actions (test_reposition.AssistedReferenceTests.test_retry_limit_and_global_deadline_do_not_enable_actions) ... ok
test_live_preview_is_exact_subsample_and_never_mutates_capture (test_reposition.PositionPixelsTests.test_live_preview_is_exact_subsample_and_never_mutates_capture) ... ok
test_8bit_wire_address_mistake_rejected (test_sensor.BusTests.test_8bit_wire_address_mistake_rejected) ... ok
test_busy_data_line_refuses_blind_bus_clear (test_sensor.BusTests.test_busy_data_line_refuses_blind_bus_clear) ... ok
test_clock_stretch_timeout_is_bounded_and_releases (test_sensor.BusTests.test_clock_stretch_timeout_is_bounded_and_releases) ... ok
test_nack_releases_wires (test_sensor.BusTests.test_nack_releases_wires) ... ok
test_read_uses_repeated_start_big_endian_and_final_nack (test_sensor.BusTests.test_read_uses_repeated_start_big_endian_and_final_nack) ... ok
test_register_write_sends_high_byte_first (test_sensor.BusTests.test_register_write_sends_high_byte_first) ... ok
test_video_active_does_not_get_overwritten (test_sensor.BusTests.test_video_active_does_not_get_overwritten) ... ok
test_inactive_context_defaults_and_reserved_gain_bits_preserved (test_sensor.SensorTests.test_inactive_context_defaults_and_reserved_gain_bits_preserved) ... ok
test_lock_and_binning_are_refused_without_writes (test_sensor.SensorTests.test_lock_and_binning_are_refused_without_writes) ... ok
test_manual_both_contexts_and_exact_restore (test_sensor.SensorTests.test_manual_both_contexts_and_exact_restore) ... ok
test_only_identity_probes_do_not_write_registers (test_sensor.SensorTests.test_only_identity_probes_do_not_write_registers) ... ok
test_out_of_range_is_refused_before_access (test_sensor.SensorTests.test_out_of_range_is_refused_before_access) ... ok
test_partial_write_failure_can_restore (test_sensor.SensorTests.test_partial_write_failure_can_restore) ... ok
test_probe_rejects_multiple_matching_devices (test_sensor.SensorTests.test_probe_rejects_multiple_matching_devices) ... ok
test_probe_rejects_unexpected_identity (test_sensor.SensorTests.test_probe_rejects_unexpected_identity) ... ok
test_readback_failure_not_reported_as_success (test_sensor.SensorTests.test_readback_failure_not_reported_as_success) ... ok
test_restore_failure_preserves_pending_original (test_sensor.SensorTests.test_restore_failure_preserves_pending_original) ... ok
test_check_labels_or_early_captures_cannot_be_used_as_fit (test_session_calibration.SessionCalibrationTests.test_check_labels_or_early_captures_cannot_be_used_as_fit) ... ok
test_cross_class_and_alignment_failures_do_not_make_a_candidate (test_session_calibration.SessionCalibrationTests.test_cross_class_and_alignment_failures_do_not_make_a_candidate) ... ok
test_fitting_excludes_reference_and_never_enables_or_updates_source (test_session_calibration.SessionCalibrationTests.test_fitting_excludes_reference_and_never_enables_or_updates_source) ... ok
test_incomplete_or_unaccepted_reference_and_duplicate_image_fail (test_session_calibration.SessionCalibrationTests.test_incomplete_or_unaccepted_reference_and_duplicate_image_fail) ... ok
test_save_requires_completed_capture_and_never_overwrites_an_old_model (test_session_calibration.SessionCalibrationTests.test_save_requires_completed_capture_and_never_overwrites_an_old_model) ... ok
test_banner_leaves_all_buttons_and_progress_pixels_unchanged (test_trial_challenges.ChallengeTests.test_banner_leaves_all_buttons_and_progress_pixels_unchanged) ... ok
test_phase_annotation_cannot_change_real_result (test_trial_challenges.ChallengeTests.test_phase_annotation_cannot_change_real_result) ... ok
test_plan_boundaries_and_confirmed_presentation (test_trial_challenges.ChallengeTests.test_plan_boundaries_and_confirmed_presentation) ... ok
test_all_emotion_actions_are_local_even_if_injected_into_wireless_adapter (test_trial_events.TrialEventsTests.test_all_emotion_actions_are_local_even_if_injected_into_wireless_adapter) ... ok
test_cancel_stops_pending_retry_and_reconnect_cannot_replay (test_trial_events.TrialEventsTests.test_cancel_stops_pending_retry_and_reconnect_cannot_replay) ... ok
test_deferred_ping_preserves_original_stamp_in_ack (test_trial_events.TrialEventsTests.test_deferred_ping_preserves_original_stamp_in_ack) ... ok
test_held_target_and_normal_shutdown_do_not_repeat (test_trial_events.TrialEventsTests.test_held_target_and_normal_shutdown_do_not_repeat) ... ok
test_live_mode_flag_and_busy_rejection_not_false_success (test_trial_events.TrialEventsTests.test_live_mode_flag_and_busy_rejection_not_false_success) ... ok
test_local_music_navigation_never_becomes_receiver_command (test_trial_events.TrialEventsTests.test_local_music_navigation_never_becomes_receiver_command) ... ok
test_missing_link_does_not_delay_local_selection_or_replay (test_trial_events.TrialEventsTests.test_missing_link_does_not_delay_local_selection_or_replay) ... ok
test_partial_dwell_loss_does_not_emit_but_new_full_dwell_does (test_trial_events.TrialEventsTests.test_partial_dwell_loss_does_not_emit_but_new_full_dwell_does) ... ok
test_real_dwell_provenance_and_all_codes_reach_log_receiver (test_trial_events.TrialEventsTests.test_real_dwell_provenance_and_all_codes_reach_log_receiver) ... ok
test_response_care_phrases_and_navigation_are_local_in_both_modes (test_trial_events.TrialEventsTests.test_response_care_phrases_and_navigation_are_local_in_both_modes) ... ok
test_simulated_replay_stale_actions_do_not_cross_real_boundary (test_trial_events.TrialEventsTests.test_simulated_replay_stale_actions_do_not_cross_real_boundary) ... ok
test_real_loop_submits_only_controller_action_and_cleans_transport (test_trial_events.TrialLoopWiringTests.test_real_loop_submits_only_controller_action_and_cleans_transport) ... ok
test_explicit_opt_in_only_default_remains_off (test_trial_events.WirelessLaunchTests.test_explicit_opt_in_only_default_remains_off) ... ok
test_demo_window_requires_long_run_and_stays_bounded (test_trial_limits.TrialLimitsTests.test_demo_window_requires_long_run_and_stays_bounded) ... ok
test_event_window_retains_latest_and_full_totals (test_trial_limits.TrialLimitsTests.test_event_window_retains_latest_and_full_totals) ... ok
test_long_duration_requires_explicit_mode_and_remains_finite (test_trial_limits.TrialLimitsTests.test_long_duration_requires_explicit_mode_and_remains_finite) ... ok
test_no_command_until_real_utterance_and_bounded_one_shot_schedule (test_trial_speech.AutomaticControlsTests.test_no_command_until_real_utterance_and_bounded_one_shot_schedule) ... ok
test_bounded_speech_high_watermark_rejects_replay_and_reordering (test_trial_speech.SpeechBoundaryTests.test_bounded_speech_high_watermark_rejects_replay_and_reordering) ... ok
test_more_and_back_are_silent (test_trial_speech.SpeechBoundaryTests.test_more_and_back_are_silent) ... ok
test_no_busy_queue_no_duplicate_after_completion (test_trial_speech.SpeechBoundaryTests.test_no_busy_queue_no_duplicate_after_completion) ... ok
test_partial_dwell_invalid_clears_and_cannot_speak_until_new_full_dwell (test_trial_speech.SpeechBoundaryTests.test_partial_dwell_invalid_clears_and_cannot_speak_until_new_full_dwell) ... ok
test_reject_stale_future_replay_wrong_phrase_or_uncalibrated (test_trial_speech.SpeechBoundaryTests.test_reject_stale_future_replay_wrong_phrase_or_uncalibrated) ... ok
test_duplicate_or_nonfinite_frame_identity_does_not_count (test_trial_telemetry.BoundedTrialTelemetryTests.test_duplicate_or_nonfinite_frame_identity_does_not_count) ... ok
test_long_run_keeps_all_counters_and_bounds_retained_data (test_trial_telemetry.BoundedTrialTelemetryTests.test_long_run_keeps_all_counters_and_bounds_retained_data) ... ok
test_missing_invalid_metrics_and_empty_recording_are_json_safe (test_trial_telemetry.BoundedTrialTelemetryTests.test_missing_invalid_metrics_and_empty_recording_are_json_safe) ... ok
test_periodic_only_audit_is_sparse_and_does_not_alias_dma_buffer (test_trial_telemetry.BoundedTrialTelemetryTests.test_periodic_only_audit_is_sparse_and_does_not_alias_dma_buffer) ... ok
test_resource_and_reason_limits_hold_even_beyond_planned_duration (test_trial_telemetry.BoundedTrialTelemetryTests.test_resource_and_reason_limits_hold_even_beyond_planned_duration) ... ok
test_resources_are_ten_second_samples_with_single_core_cpu_and_endpoint (test_trial_telemetry.BoundedTrialTelemetryTests.test_resources_are_ten_second_samples_with_single_core_cpu_and_endpoint) ... ok
test_selection_and_validity_events_never_sample_faster_than_one_hz (test_trial_telemetry.BoundedTrialTelemetryTests.test_selection_and_validity_events_never_sample_faster_than_one_hz) ... ok
test_valid_is_current_stable_region_not_just_non_null_stable (test_trial_telemetry.BoundedTrialTelemetryTests.test_valid_is_current_stable_region_not_just_non_null_stable) ... ok
test_validity_transition_is_sampled_without_an_action (test_trial_telemetry.BoundedTrialTelemetryTests.test_validity_transition_is_sampled_without_an_action) ... ok
test_missing_proc_files_are_null_without_platform_dependencies (test_trial_telemetry.ProcessResourceTests.test_missing_proc_files_are_null_without_platform_dependencies) ... ok
test_reads_proc_kib_fields_and_ignores_other_units_and_invalid_values (test_trial_telemetry.ProcessResourceTests.test_reads_proc_kib_fields_and_ignores_other_units_and_invalid_values) ... ok
test_all_common_phrases_supported_and_paging_does_not_skip (test_typing_efficiency.TypingEfficiencyTests.test_all_common_phrases_supported_and_paging_does_not_skip) ... ok
test_candidate_ranking_uses_context_without_changing_dictionary_or_saving (test_typing_efficiency.TypingEfficiencyTests.test_candidate_ranking_uses_context_without_changing_dictionary_or_saving) ... ok
test_every_syllable_remains_reachable_including_early_candidates (test_typing_efficiency.TypingEfficiencyTests.test_every_syllable_remains_reachable_including_early_candidates) ... ok
test_free_pinyin_examples_need_fewer_selections (test_typing_efficiency.TypingEfficiencyTests.test_free_pinyin_examples_need_fewer_selections) ... ok
test_keyboard_delete_and_navigation_preserve_saved_phrases (test_typing_efficiency.TypingEfficiencyTests.test_keyboard_delete_and_navigation_preserve_saved_phrases) ... ok
test_phrase_appends_atomically_without_auto_display_or_discarding_pinyin (test_typing_efficiency.TypingEfficiencyTests.test_phrase_appends_atomically_without_auto_display_or_discarding_pinyin) ... ok
test_prefix_filter_excludes_impossible_letters (test_typing_efficiency.TypingEfficiencyTests.test_prefix_filter_excludes_impossible_letters) ... ok
test_complete_acceptance_sequence_uses_the_real_controller (test_ui.BoardUiTests.test_complete_acceptance_sequence_uses_the_real_controller) ... ok
test_display_failure_preserves_incomplete_trace_and_propagates (test_ui.BoardUiTests.test_display_failure_preserves_incomplete_trace_and_propagates) ... ok
test_guidance_text_fits_compiled_message_region (test_ui.BoardUiTests.test_guidance_text_fits_compiled_message_region) ... ok
test_mismatched_geometry_or_malformed_tile_is_rejected (test_ui.BoardUiTests.test_mismatched_geometry_or_malformed_tile_is_rejected) ... ok
test_pixels_match_authoritative_artwork_for_all_cards_and_sources (test_ui.BoardUiTests.test_pixels_match_authoritative_artwork_for_all_cards_and_sources) ... ok
test_progress_never_rounds_up_or_displays_completion_early (test_ui.BoardUiTests.test_progress_never_rounds_up_or_displays_completion_early) ... ok
test_rendering_does_not_change_controller_and_handles_cursor_edges (test_ui.BoardUiTests.test_rendering_does_not_change_controller_and_handles_cursor_edges) ... ok
test_selected_button_stays_visibly_locked_after_lost_input (test_ui.BoardUiTests.test_selected_button_stays_visibly_locked_after_lost_input) ... ok
test_stalled_input_does_not_get_synthetic_catchup_actions (test_ui.BoardUiTests.test_stalled_input_does_not_get_synthetic_catchup_actions) ... ok
test_startup_reference_pixels_match_and_never_show_selectable_cards (test_ui.BoardUiTests.test_startup_reference_pixels_match_and_never_show_selectable_cards) ... ok
test_wrong_dwell_label_cannot_be_used (test_ui.BoardUiTests.test_wrong_dwell_label_cannot_be_used) ... ok
test_held_selection_stays_locked_and_more_has_return_instruction (test_usage_guidance.GuidanceTests.test_held_selection_stays_locked_and_more_has_return_instruction) ... ok
test_helper_states_override_old_observation_and_do_not_authorize_input (test_usage_guidance.GuidanceTests.test_helper_states_override_old_observation_and_do_not_authorize_input) ... ok
test_prolonged_loss_is_only_a_hint_and_new_dwell_is_still_required (test_usage_guidance.GuidanceTests.test_prolonged_loss_is_only_a_hint_and_new_dwell_is_still_required) ... ok
test_rejection_never_claims_closed_eyes_or_recalibrates (test_usage_guidance.GuidanceTests.test_rejection_never_claims_closed_eyes_or_recalibrates) ... ok
test_stale_frame_and_time_fault_cannot_show_ready (test_usage_guidance.GuidanceTests.test_stale_frame_and_time_fault_cannot_show_ready) ... ok
test_checked_launch_keeps_all_features_and_opt_in_receiver_mode (test_wireless_upgrade.WirelessUpgradeTests.test_checked_launch_keeps_all_features_and_opt_in_receiver_mode) ... skipped 'requires optional local private profile or AI runtime bundle'
test_cold_text_build_services_same_owner_without_pixel_or_draft_changes (test_wireless_upgrade.WirelessUpgradeTests.test_cold_text_build_services_same_owner_without_pixel_or_draft_changes) ... ok
test_delayed_ping_priority_keeps_expiry_and_invalid_input_guards (test_wireless_upgrade.WirelessUpgradeTests.test_delayed_ping_priority_keeps_expiry_and_invalid_input_guards) ... ok
test_fresh_help_precedes_unsent_heartbeat_after_feature_processing (test_wireless_upgrade.WirelessUpgradeTests.test_fresh_help_precedes_unsent_heartbeat_after_feature_processing) ... ok
test_overdue_service_cancels_instead_of_relaxing_250ms_or_replaying (test_wireless_upgrade.WirelessUpgradeTests.test_overdue_service_cancels_instead_of_relaxing_250ms_or_replaying) ... ok
test_ping_ack_promotes_and_sends_fresh_help_in_same_service_call (test_wireless_upgrade.WirelessUpgradeTests.test_ping_ack_promotes_and_sends_fresh_help_in_same_service_call) ... ok
test_rebinding_retires_pending_session_and_rejects_old_action_or_late_ack (test_wireless_upgrade.WirelessUpgradeTests.test_rebinding_retires_pending_session_and_rejects_old_action_or_late_ack) ... ok
test_suspended_preview_drops_pending_ping_action_and_never_handshakes (test_wireless_upgrade.WirelessUpgradeTests.test_suspended_preview_drops_pending_ping_action_and_never_handshakes) ... ok
test_unknown_and_every_upgrade_local_key_are_not_protocol_submissions (test_wireless_upgrade.WirelessUpgradeTests.test_unknown_and_every_upgrade_local_key_are_not_protocol_submissions) ... ok
test_all_characters_stay_reachable_and_no_duplicate_word_choices (test_word_completion.WordCompletionTests.test_all_characters_stay_reachable_and_no_duplicate_word_choices) ... ok
test_continuation_is_visible_but_never_added_without_selection (test_word_completion.WordCompletionTests.test_continuation_is_visible_but_never_added_without_selection) ... ok
test_first_syllable_can_explicitly_commit_whole_phrase (test_word_completion.WordCompletionTests.test_first_syllable_can_explicitly_commit_whole_phrase) ... ok
test_limits_never_truncate_phrase_or_consume_pending_pinyin (test_word_completion.WordCompletionTests.test_limits_never_truncate_phrase_or_consume_pending_pinyin) ... ok
test_plain_pinyin_is_one_explicit_action_away_from_suggestions (test_word_completion.WordCompletionTests.test_plain_pinyin_is_one_explicit_action_away_from_suggestions) ... ok
test_same_target_hold_cannot_commit_a_whole_phrase_after_new_page (test_word_completion.WordCompletionTests.test_same_target_hold_cannot_commit_a_whole_phrase_after_new_page) ... ok

----------------------------------------------------------------------
Ran 559 tests in 24.309s

OK (skipped=3)
